embeddedci-com/benchpod/spice/adc-v2/adc-v2.asc

C72: Cap; 100p
C74: Cap; 10p
C139: Cap; 10p
C140: Cap; {Cc}
R90: Res; 910k
R91: Res; 82.5k
R92: Res; 1k
R93: Res; 1k
R94: Res; 1.5k
R97: Res; 22
R98: Res; 22
R102: Res; 1.5k
R103: Res; 10
VOCM: voltage; 2.05
VP: voltage; 5
Vsig: voltage; PULSE(0 30 1u 0.1n 0.1n 5u 10u); AC 1 0
Named nets: 0, SMA, TOP, ATTN, INM, INP, OUTP, OUTM, AINP, AINN, VP, VOCM, BUF
.include ths4551.lib
XU1 INP INM OUTP OUTM VOCM VP 0 THS4551
.tran 0 12u 0 1n
Vneg VN 0 -5
;EBUF BUF 0 ATTN 0 1
.include opa810.lib
XBUF ATTN BUF BUF VP VN OPA810
.options reltol=1e-5
* per-input charge buckets (datasheet 22R + 1.7nF per input)
CbP AINP 0 680p
CbN AINN 0 680p
* SAR sample-and-hold: 31pF cap switched onto the inputs during tACQ
S1 AINP SP CLK 0 SW1
S2 AINN SN CLK 0 SW1
Csmp SP SN 31p
S3 SP SN NCLK 0 SW1
VCLK  CLK  0 PULSE(0 1 1.5u 1n 1n 300n 1000n)
VNCLK NCLK 0 PULSE(1 0 1.5u 1n 1n 300n 1000n)
.model SW1 SW(Ron=100 Roff=1e9 Vt=0.5)
.meas TRAN Vend   FIND V(AINP)-V(AINN) AT 4.8u
.meas TRAN Vfinal FIND V(AINP)-V(AINN) AT 5.45u
.meas TRAN err    param Vend-Vfinal
.param Cc=9.3p
.step param Cc 9.0p 9.6p 0.025p
