embeddedci-com/benchpod/(commit log)

2026-09-04 switched D1, added rules area with keepout
    [analog-power-v2.kicad_sch, usb.kicad_sch, vbench-pod.kicad_pcb]
2026-09-05 1V8/3V3 pull-ups / pull-down fixes
    [LogicAnalyzer.kicad_sch, vbench-pod.kicad_pcb, vbench-pod.kicad_sch]
2026-09-05 ethernet rx/tx reroute
    [vbench-pod.kicad_pcb]
2026-09-05 txp/txn/rxp/rxn rerouting
    [vbench-pod.kicad_pcb]
2026-09-05 nrst control
    [vbench-pod.kicad_pcb, vbench-pod.kicad_sch]
2026-09-06 expanding board, adding headers, adding usb-a
    [analog-to-digital-v2.kicad_sch, digital-to-analog-v2.kicad_sch, power.kicad_sch, vbench-pod.kicad_pcb]
2026-09-06 replacement for crystals, revision resistors, cleanups
    [ethernet.kicad_sch, vbench-pod.kicad_pcb, vbench-pod.kicad_sch]
2026-09-06 tvs fixes, extra cap, schematic fixes
    [analog-power-v2.kicad_sch, digital-to-analog-v2.kicad_sch, vbench-pod.kicad_pcb]
2026-09-07 headers for dac/adcs with zero resistors, 4.5V input for DAC instead of 5V
    [analog-power-v2.kicad_sch, analog-to-digital-v2.kicad_sch, digital-to-analog-v2.kicad_sch, vbench-pod.kicad_pcb]
2026-09-07 fix pull-downs for board boot-up
    [analog-switching.kicad_sch, power.kicad_sch]
2026-09-07 copper cleanups
    [vbench-pod.kicad_pcb]
2026-09-07 cleanups and copper fill
    [vbench-pod.kicad_pcb]
2026-09-08 route cleanups and out of stock component replacement
    [analog-power-v2.kicad_sch, power.kicad_sch, usb.kicad_sch, vbench-pod.kicad_pcb, vbench-pod.kicad_sch]
2026-09-08 replace d1, cleanups, cap changes
    [analog-power-v2.kicad_sch, ethernet.kicad_sch, power.kicad_sch, vbench-pod.kicad_pcb, vbench-pod.kicad_sch]
2026-09-08 5VA->5V for relays, resistor and cap changes
    [analog-power-v2.kicad_sch, analog-switching.kicad_sch, analog-to-digital-v2.kicad_sch, digital-to-analog-v2.kicad_sch, vbench-pod.kicad_pcb, vbench-pod.kicad_sch]
2026-09-08 5VA->5V for relays rerouting
    [analog-to-digital-v2.kicad_sch, vbench-pod.kicad_pcb, vbench-pod.kicad_sch]
2026-09-08 drc and cleanups
    [vbench-pod.kicad_pcb]
2026-09-09 CAN improvements, rerouting, final drc cleanup of routes
    [vbench-pod.kicad_pcb, vbench-pod.kicad_sch]
2026-09-09 fb changes, cc sensing, cleanups
    [analog-power-v2.kicad_sch, ethernet.kicad_sch, usb.kicad_sch, vbench-pod.kicad_pcb, vbench-pod.kicad_sch]
2026-09-09 final cleanup
    [analog-power-v2.kicad_sch]
2026-09-09 change resistor value
    [analog-power-v2.kicad_sch]
2026-09-25 benchpod digital only
    [LogicAnalyzer.kicad_sch, analog-power-v2.kicad_sch, analog-switching.kicad_sch, analog-to-digital-v2.kicad_sch, digital-to-analog-v2.kicad_sch, ethernet.kicad_sch, power.kicad_sch, usb.kicad_sch]
2026-10-02 digital layout fixes
    [vbench-pod.kicad_pcb]
2026-10-03 layout fixes and cleanups
    [vbench-pod.kicad_pcb, vbench-pod.kicad_sch]
2026-10-03 more fixes
    [vbench-pod.kicad_pcb]
2026-10-03 digital benchpod: final layout
    [vbench-pod.kicad_pcb, vbench-pod.kicad_sch]
2026-10-04 cleanups: before schematic sync
    [vbench-pod.kicad_pcb]
2026-10-04 digital and analog cleanup
    [ethernet.kicad_sch, power.kicad_sch, usb.kicad_sch, vbench-pod.kicad_pcb, vbench-pod.kicad_sch]
2026-10-06 Benchpod v3.0.1 work (#1)
    * bom replacements and footprint replacements for out of stock items
    * replacements and fixes
    * smaller fixes
    * finalized v3r1
    * finshunt work on digital (wip)
    [analog-power-v2.kicad_sch, analog-to-digital-v2.kicad_sch, power.kicad_sch, usb.kicad_sch, vbench-pod.kicad_pcb, vbench-pod.kicad_sch]
2026-10-06 bring digital on par with analog for current shunt
    [vbench-pod.kicad_pcb]
2026-10-06 small cleanups
    [vbench-pod.kicad_pcb]
2026-10-06 README: which board matches which tag
    Board names as printed on the silkscreen, the tag with their design files,
    and what changed per board. The v3 tags are renamed after the boards:
    analog-v3, digital-v3, analog-v3r1, digital-v3r2.
2026-10-06 digital: U35 value INA226AIDGSR like U29/U33
    With two different values the JLC BOM had two lines for the same part
    (C49851) and left both unconfirmed at quantity 0, so no INA226 would have
    been placed. One value gives one line, U29/U33/U35.
    [usb.kicad_sch]
2026-10-20 analog v3r2: lead-free diodes and SMA, 0.1 % gain resistors, tantalum ADC reference cap
    RoHS/REACH (no exemption claimed in the LCSC test reports):
    - SS34 D3 D9 D15 D16 -> FOSAN SS34 C3014011
    - SMAJ20A D5 -> FOSAN SMAJ20A C5353170
    - SMAJ36CA D6 D7 D8 D10 -> FOSAN SMAJ36CA C5353135
    - SMA RF1-RF4 -> HCTL HC-SMA-KWE-14.5H-D002-01 C41410437 (same footprint,
    5.08 vs 5.10 mm pin square)
    - 11.8k R127 R129 R132 R133 (RALEC, lead glass) -> YAGEO 0.1 % C852496
    0.1 % 25 ppm thin film, to cut the pod-to-pod offset and gain spread:
    - THS4551 gain R92 R93 (1k C852624), R94 R102 (1.5k C281775): the 1 %
    mismatch turned VOCM into an ADC offset of about +-66 mV between pods
    - +-12 V difference amps R126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
2026-10-20 analog v3r2: smaller capacitor packages (same rating and dielectric)
    To 0402: 3.3 nF C99 C102 C119 C226 (C26404), 8.2 pF C0G C29 C30 C50 C51
    (C1579), 5.1 pF high-Q C207 C208 (C237535; the old C2297586 had 29 in stock).
    To 0603: 4.7 uF C2 C3 C5 C220 (C69335), 22 uF C16 C108 C154 C157 (C2762594),
    220 nF C189 (C64705), 2.2 uF X7R VCAP C218 C219 (C415535, from 1206).
    Kept: C150/C153 (4.7 uF on the ~5 V charge-pump rails, DC-bias derating),
    C140 (sees up to 58 V at TVS clamp), all 10 uF and the 22 uF on >5 V rails.
    Footprint changes: needs a PCB update. Netlist connectivity unchanged.
2026-10-20 analog v3r2: no extra BOM lines from the 0.1 % swaps and cap shrinks
    JLC standard assembly charges per unique BOM line, so only keep changes
    that replace a whole line:
    - Revert 4.7 uF C2 C3 C5 C220 and 22 uF C16 C108 C154 C157 to 0805 (the
    other 4.7 uF/22 uF stay 0805, so the shrink split a line), and 5.1 pF C207
    C208 to the 0603 C2297586 (C140 needs it; 29 in stock = 9 boards).
    - Move the remaining 1k (R21 R22 R164 R175), 1.5k (R15) and 2.2k (R58 R62)
    to the same 0.1 % parts as the precision ones, so their old lines go.
    BOM: 122 -> 124 unique lines (0.1 % 10k for R109 R110 R111 R123, tantalum
    C142). Netlist connectivity unchanged.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
2026-10-20 libs: import DAC8554IPWR (C527522) from LCSC/EasyEDA
    easyeda2kicad import, named like the kicad_lcsc_manager parts:
    symbol DAC8554IPWR_C527522, footprint C527522_TSSOP-16_..., 3D model
    3dmodels/C527522. Pin 5 keeps EasyEDA's name VREEL (VREFL).
2026-10-20 analog v3r2: quad DAC (DAC8554) with one channel per output, TMUXes removed
    Step A of the analog redesign, relays unchanged:
    - U43 DAC8551 -> DAC8554IPWR (C527522, same 24-bit frame family):
    A = TO_3V3, B = TO_5V, C = TO_12V (U51B and the cal2 stage U51C),
    D = DAC_OUTPUT -> U44B -> BUFFER_OUT -> XTR116, so 4-20 mA is now
    independent of the voltage outputs. VREFH = AREF_4V096, VREFL/A0/A1/
    ENABLE/LDAC = GND, IOVDD = +3V3 with new C266 100n (C307331).
    - Removed U47 U48 (TMUX1104), U55 (TCA9554 @0x21) with R107 R112 R124,
    C164 C199 C200 C203 C204 C234, and the SDA/SCL sheet pins of this sheet.
    - BUFFER_VMID (2.048 V) now goes straight to both +-12 V stages
    (was TO_12V_VMID / TO_ADC_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
2026-10-20 analog v3r2: board-rev strap R164 1k -> 2.2k (PA3 2.70 V)
    v3 straps PA3 with 1k/10k (3.00 V); v3r2 uses 2.2k/10k (2.70 V) so new
    firmware can tell them apart. Still reads HIGH in the pull-down NC test
    (~2.59 V loaded), so v2 detection is unchanged, and old firmware runs a
    v3r2 board as v3. R164 uses the existing 0.1 % 2.2k line (C326602): no new
    BOM line. Note next to the strap documents both values.
2026-10-20 header cleanup and schematic cleanup
2026-10-20 analog v3r2: +-14 V (TPS65131) enabled from U58 P4, off by default
    U49 ENP/ENN were pulled up to VIN, so +-14 V was always on. They now share
    the new ANA14_EN net from the relay expander U58 P4 (TCA9554 0x23, spare
    pin), with R114 (100k) as pull-down to GND; R117 removed. TPS65131 EN:
    VIH 1.4 V, 0.1 uA, so the 3.3 V expander output and 100k pull-down work.
    Why: the DAC8554 powers up at code 0, which put the +-12 V output (RF3) at
    about -12 V until firmware parked channel C. With +-14 V off at power-up,
    -14 V is 0 V and +14 V sits at ~VIN - Vf (no BSW load switch), so U51
    cannot swing negative and RF3 stays near 0 V. Old firmware never enables
    it, so on v3r2 the +-12 V output is simply off.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
2026-10-20 analog v3r2: remove H3 (unused 2x5 GPIO header), freed STM32 pins no-connect
    PD8-PD15, PG2, PG5 (HEADER1_1..10) get no-connect flags, like the pins
    freed by the H2 removal. BOM lines unchanged (H1 still uses the same
    header part until it becomes a TC2030 footprint).
2026-10-20 analog v3r2: SWD on a TC2030 footprint with SWO, USART2 console on test pads
    - H1 (2x5 1.27 mm SWD header, DNP) -> J10 Tag-Connect TC2030-IDC footprint
    (Connector:Tag-Connect_TC2030-IDC-FP_2x03_P1.27mm_Vertical, legged):
    VCC=+3V3, SWDIO, NRST, SWCLK, GND, and pin 6 SWO = PB3 (was unused).
    TC2030-IDC plugs into a 10-pin Cortex debug header.
    - USART2 (PD5 TX, PD6 RX), the firmware's mirrored console, on test pads
    TP8 (TX), TP9 (RX) and TP10 (GND), 1.5 mm pads, in place of H2's pins.
    - J10 and the pads are footprints only (in_bom no, like TP3/TP7).
    ERC: one extra pin_not_driven on J10 SWO (STM32 pins have no pin type).
    BOM lines unchanged (123).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
2026-10-20 analog v3r2: EMC pre-scan fixes in the schematic, no new BOM lines
    From compliance emc/prescan-2026-10-18.md (schematic part; layout is separate):
    - C267 100 nF (C307331) at U37 (THS4551) pin 5 VS-; C224/C157 sit at the
    LM7705 on the power sheet, not at the driver.
    - USB-C CC1/CC2 clamped by the two unused channels of D11 (USBLC6-4, pins
    6 and 4), which already protects D+/D-.
    - LA header +1V8 (J1.18) and LA_VCCIO (J1.21) on the two unused channels of
    U28 (SRV05-4, pins 4 and 6); +3V3 (J1.17) is U28's own VDD rail, so it is
    clamped by U28 already. Layout: U28 next to J1.
    - RF2 (0-5 V SMA) gets D21 SMF13CA (C1851355, same as D19/D20): the jack had
    no clamp of its own and floats behi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
2026-10-20 pcb placement of v3r2 changes
2026-10-21 analog v3r2: fixed ADC divider compensation, trimmer C160 removed
    Measured on baea06 (v3r1) with a cal1 loopback sine sweep (200 Hz-150 kHz):
    the top leg was ~11.4 pF (C140 5.1 pF + C160 near its 6 pF max + stray)
    against ~107 pF on the bottom, so HF gain was +16 % over DC. Flat needs
    ~9.7 pF total.
    - C160 (2-6 pF trimmer, never adjusted) removed.
    - C140 5.1 pF -> 9.1 pF C0G +-0.1 pF 250 V, Murata GQM1875C2E9R1BB12D
    (C2299929), same 0603 footprint. With ~0.3 pF stray: ~3 % low at HF.
    - C72 100 pF +-5 % -> +-1 % C0G, YAGEO CC0402FRNPO9BN101 (C327198), same
    0402 footprint; C72 was the only user of C1546.
    C140 also leaves the 5.1 pF line (29 in stock), now only C207/C208.
    Netlist: only C1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
2026-10-21 pcb: 16 vias 0.45/0.2 -> 0.6/0.3 (board standard), no moves
    Only size and drill changed; positions, nets and tracks untouched. Fixes 16
    annular_width errors (0.125 mm ring vs the 0.15 mm rule). The bigger vias
    now hit clearance near the ESP32 signals around (107-117, 25-31); left for
    manual fixing. Refill zones before judging the via-to-zone clearance items.
2026-10-21 cleanups and sync pcb to schematic
2026-10-21 silkscreen fixes
2026-10-21 resistor change - enable 14V not at power up
2026-10-21 README: BenchPod v3-r2 board and tag
2026-10-21 bom fixes
2026-10-21 digital v3r3: carry over the analog v3r2 schematic changes
    Same refs and nets as analog v3r1 in these areas, so the v3r2 fixes map 1:1.
    - RoHS: D3 SS34 C8678 -> C3014011, D5 SMAJ20A C41376408 -> C5353170.
    - U4 ESP32-C3-MINI-1-H4 (C2934569): the N4 is out of stock at JLC; same
    module, footprint and chip, 105 C rated.
    - Package shrinks (whole BOM lines, no new lines): 8.2p C29/C30/C50/C51 and
    3.3n C99/C102/C119/C226 0603 -> 0402, 2.2u C218/C219 1206 -> 0603.
    - EMC: D11 spare channels on USB CC1/CC2, U34 spares on +1V8 and LA_VCCIO.
    - Debug: H1 (SWD 2x5) and H3 (HEADER1) removed; J10 SWO/NRST/SWCLK/SWDIO and
    J11 USART2_RX/+3V3/GND/USART2_TX 2x2, both DNP; PB3 = SWO, PD5/PD6 = USART2.
    No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
2026-10-21 pcb sync
2026-10-21 digital v3r3: right-angle, panel-facing parts for the enclosure
    Parts from benchpod-private enclosure/design.md (connector choices):
    - J1 LA header: shrouded keyed right-angle 2x13 X9555WR-2x13-6TV01
    (C2682221). Pins 1-22 unchanged (same odd/even IDC numbering), 23-26 GND.
    - J4/J5/J6 (target in, target out, 5 V out): pluggable right-angle 3.81 mm
    block, black, DB2ERC-3.81-2P-BK (C5259145); the plug ships separately.
    - SW1/SW2 reset/boot: side-push TS24CA (C393942), for pinholes in the panel;
    its two mechanical tabs have no pad number.
    - LED1: side-view RGB P4-1204RGBWS2-1.5T-A (C2827295). Pin numbers follow
    its datasheet (1 G, 2 B, 3 R, 4 anode); the colors stay on the same
    iCE40 d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
2026-10-21 digital v3r3: C120 back to its v3r2 orientation (pad 1 = +3V3) so the existing traces fit
2026-10-21 digital v3r3: CN1 becomes a 24-pin 1.0 mm FFC link to the analog module
    CN1 (2x10 IDC) is replaced by a 24-pin 1.0 mm FFC, KH-FPC1.0-H2.0SMT-24P-QCHF
    (C5123103, flip lock, top and bottom contact), on a new "Module link" sheet:
    1-3 +5V_MOD, 4-6 GND, 7 DAC_SCLK, 8 DAC_DIN, 9 DAC_SYNC, 10 GND,
    11 ADC_SCLK, 12 ADC_SDO, 13 ADC_SDI, 14 GND, 15 ADC_CNVST, 16 GND,
    17 I2C0_SDA, 18 I2C0_SCL, 19 GND, 20 MOD_RESET#, 21 MOD_PRESENT#, 22 GND,
    23 MOD_SPARE, 24 GND (tabs to GND). Every clock sits next to a ground.
    - Module 5 V through eFuse U59, a copy of U26 (TPS259470A, same BOM line):
    about 1 A limit (1.65k), soft start, OVLO divider, PG and FLT pull-ups.
    EN has a 10k pull-up, so the module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
2026-10-21 digital v3r3: always-on USB-A (USB2) to power the optional Wi-Fi bridge
    USB1 stays the target-power USB-A (it follows eFuse 1 and power-cycles with
    the DUT). USB2 is a second USB-A, same part, for the back panel next to the
    RJ45: always-on 5 V for the Wi-Fi bridge (power only, data goes over RJ45),
    as decided in benchpod-private enclosure/wifi-bridge.md (USB-A rather than a
    second USB-C, so nobody plugs the laptop into the wrong port).
    - eFuse U60, a copy of U26/U59 (TPS259470A): about 1 A limit, soft start,
    OVLO; EN pulled up, so it is on at power-up and older firmware keeps it on.
    - STM32 PD14 BRIDGE_PWR_EN (low = off, to power-cycle a hung bridge),
    PD15 BRIDGE_PWR_FLT#, PG2 BRIDGE_PW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
2026-10-21 connector placement
2026-10-21 connector placement continued
2026-10-21 pcb work
2026-10-22 digital v3r3: own I2C bus for the module; module sheet uses hierarchical labels
    - CN1 pins 17/18 move from the pod's internal I2C0 bus to a separate bus for
    the analog module: MOD_I2C_SDA = PF0, MOD_I2C_SCL = PF1 (STM32 I2C2, AF4),
    4.7k pull-ups R193/R194 to +3V3 (existing 4.7k line). A fault on the module
    or its cable can no longer hang the INA226 and TCA9554 bus.
    - The "Module link, bridge power" sheet now connects through hierarchical
    labels and sheet pins instead of global labels: the sheet box on the root
    sheet moved to the free space at the top (152.4, 25.4), 50.8 x 25.4, with
    the 9 FPGA/I2C lines on the left and the 9 STM32 control lines on the right.
    - Removes the old I2C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
2026-10-22 more pcb work
2026-10-22 digital v3r3: SY6280AAC power switches for module and bridge, TVS on 5 V outputs
    - U59 (module 5 V) and U60 (bridge USB-A 5 V) become SY6280AAC (C55136,
    about $0.09) instead of TPS259470 eFuses (about $1 each); 12 support parts
    removed. Current limit 6800/Rset: module 4.7k = about 1.45 A, bridge
    4.7k + 2.2k (R187 + R195) = 6.9k = about 1 A, both from existing BOM lines.
    EN keeps its 10k pull-up (on at power-up), PD10 / PD14 still switch them.
    - The FLT/PG flags are gone with the eFuses: PD11, PD12, PD15 and PG2 are free
    again (no-connect), and their four sheet pins are removed.
    - SMAJ5.0A TVS (same line as D1): D22 on the bridge USB-A VBUS, D23 on target
    power 1 (USB1/J5).
    BOM: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
2026-10-22 digital v3r3: merge three single-use resistor lines into existing ones
    - CAN series resistors R18/R176: 56 ohm -> 49.9 ohm (C325388).
    - RJ45 LED resistors R140/R141: 270 ohm 0603 -> 330 ohm 0402 (C25104); the
    LEDs get slightly dimmer.
    - VDDA/VREF+ filter R1: 47 ohm 0603 -> 49.9 ohm 0402 (C325388).
    Three BOM lines fewer. The MDIO pull-up R15 stays 1.5k (LAN8742A reference
    value). R140, R141 and R1 change footprint: re-place them after Update PCB.
2026-10-22 digital v3r3: CAN termination resistors R18/R176 back to 56 ohm
    They are not series resistors: with U24 (switch) they form the switchable
    CAN termination across CANH/CANL (2 x 56 + switch = about 115-117 ohm,
    close to 120 nominal). 49.9 ohm would give about 103-105 ohm.
2026-10-23 digital v3r3: PSRAM U7 in SOP-8 (APS6404L-3SQR-SN)
    - U7 becomes APS6404L-3SQR-SN (C5333729, SOP-8): same die, commands and pin
    numbering as the USON-8 APS6404L-3SQR-ZR (C3040877). $3.99 instead of $4.98
    at qty 1 ($2.88 vs $3.40 at 100), and 3.7k in stock at JLC instead of 664.
    - The SOP-8 has no exposed pad: pin 9 and its GND wire and symbol are removed.
    GND stays on pin 4. No firmware or gateware change.
    BOM: same number of lines. Layout needs about 5 x 6 mm instead of 2 x 3 mm.
2026-10-23 digital v3r3: 3.3 V buck U30 becomes TPS62130A plus a 2.2 uH inductor
    The TPS82130 module is a TPS62130 with a 1 uH inductor inside. Discrete, per
    the TPS62130 datasheet typical application (figure 9-1, table 9-1):
    - U30 TPS62130ARGTR (C337502, $0.80, KiCad VQFN-16 footprint with thermal
    vias); L1 2.2 uH 4x4 shielded FNR4030S2R2MT (C167869, 3.2 A, 5.8 A sat,
    39 mohm). 2.2 uH + 22 uF is the datasheet's standard LC combination.
    - PVIN/AVIN and EN on +5V; VOS on +3V3; FB divider R85 316k / R86 100k
    unchanged (FB is 0.8 V on both, 3.33 V out); SS/TR C119 3.3 nF unchanged;
    DEF and FSW on GND (nominal output, 2.5 MHz); PG unconnected, so the A
    version's PG behavior does not matter.
    - Ex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
2026-10-23 analog only board
2026-10-23 analog only board: CN1 FFC module link to the digital board
    - CN1 KH-FPC1.0-H2.0SMT-24P-QCHF (C5123103), the same 24-pin 1.0 mm FFC
    connector as the digital board, on the root sheet. Pins 21-24 +5V,
    DAC_DIN/SCLK/SYNC, ADC_SDI/SCLK/SDO/CNVST and I2C0 to the existing labels;
    MOD_PRESENT# tied to GND; MOD_RESET# and MOD_SPARE unused; tabs to GND.
    - Placed on the bottom side, under the digital CN1 (same X/Y from the
    top-left board corner), opening toward the left edge. Mounted upside down
    it is mirrored, so the pin order is reversed: pin N here = digital CN1
    pin 25-N (a flat cable keeps each wire at the same position). Text note on
    the sheet.
    - PCB: only the footprint was added; it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
2026-10-23 analog only board: +3V3 from an AP2112K-3.3 instead of the 3 A buck
    On this board +3V3 only feeds logic I/O (DAC8554 IOVDD, MCP33131 DVIO,
    TCA9554, the new EEPROM): a few mA. U30 TPS82130 (3 A module) becomes
    AP2112K-3.3 (C51118, same part as U46, so no new BOM line): VIN and EN on
    +5V, VOUT to +3V3, C107/C109 in, C110/C114 out. R85, R86, C119 and C108
    removed. Separate from U46's +3V3A so logic I/O stays off the analog rail.
    BOM: TPS82130, 316k and 3.3n lines gone (-3), about $4.75 per board.
2026-10-23 analog only board: sheet-pin cleanup, PWR_FLAGs, module ID EEPROM
    - Power sheet: the INA_SCL/SDA, SCL/SDA and EFUSE_INT sheet pins and their
    root labels removed (left over from the full pod, no labels inside).
    - PWR_FLAG on +5V at CN1 (it now comes in over the FFC) and on GND.
    - U61 24C32 I2C EEPROM (XBLW 24C32BN, C18723546, SOP-8) on I2C0, the module
    bus: A0-A2 and WP to GND (address 0x50, writable), C268 100n. Holds the
    module ID and its DAC/ADC calibration so they travel with the module.
    Pull-ups are on the digital board (R193/R194).
    BOM: +1 line (EEPROM). ERC 291 -> 276 (6 cleanup errors gone).
2026-10-23 analog only board: CN1 on the top side, straight pin order
    The board now has a cut at the left edge for the FFC, so CN1 moves to the
    top side with the same orientation as the digital CN1 (opening toward the
    cut). The cable U-turns through the cut, so pin N = digital CN1 pin N again
    (the reversed mapping is gone): pins 1-4 +5V, MOD_PRESENT# (21) to GND,
    MOD_RESET# (20) and MOD_SPARE (23) unused. Note on the sheet updated.
    PCB: CN1 on F.Cu, rotated -90, pin 1 at the digital pin-1 height (y 48.57
    from the top edge), 2 mm further inboard (x 19.51) so the opening is about
    3.3 mm from the cut's inner edge and the cable has room to bend.
    Includes the board-edge cut drawn in KiCad.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
2026-10-23 analog only board: enclosure connectors (BNC, pluggable 4-20 mA blocks)
    Per benchpod-private enclosure/design.md:
    - RF2 (0-5 V), RF3 (+-12 V), RF4 (ADC in): SMA -> right-angle BNC
    KH-BNC50-3511 (C2837587). Center on the same net, shell + lugs to GND.
    - RF1 (0-3.3 V jack) removed; the 0-3.3 V output stays on TP1.
    - 2-pin test headers U11-U14 and their 0 ohm links R20, R165-R167 removed;
    test pads TP1-TP4 (1.5 mm, not in the BOM) on the four outputs instead.
    - J8 (4-20 mA in) and J9 (4-20 mA out): 5.08 mm screw terminals ->
    3.81 mm right-angle pluggable WJ15EDGRC-3.81-02P (C8387, green); the
    mating plug C8466 is bought separately.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
2026-10-23 analog only board: ADC input ready for 10x probes, lead-free BNC
    - J10 (was RF4): ADC input BNC is now the lead-free SAMZO BNC-KYWE-295-W4-N
    (C41416668), as decided in benchpod-compliance v4-parts.md; the Kinghelm
    KH-BNC50-3511 relies on a RoHS lead exemption and is removed (symbol,
    footprint, model).
    - D8 and D7 (SMAJ36CA on RELAY1_IN / RELAY2_IN) removed: a few hundred pF and
    uA leakage on the 1 Mohm node made 10x probes impossible to compensate.
    - D22 BAV199LT1G (C145516, pA leakage, ~2 pF) clamps the OPA810 input
    (R90/R91 node) to 5VA / -5VA. R90 limits the fault current (0.33 mA at
    300 V) and moves to a 1206 0.1 % 200 V part (YAGEO RT1206BRD07910KL,
    C870935), value unchang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
2026-10-23 analog only board: DAC outputs on one 6-pin pluggable block
    RF2 (0-5 V) and RF3 (+-12 V) BNCs removed. All three DAC outputs go to
    J11, a 3.81 mm right-angle pluggable block WJ15EDGRC-3.81-06P (C7246,
    green): 1 0-3.3 V (OUT_3V3), 2 GND, 3 0-5 V (TO_5V_SMA), 4 GND,
    5 +-12 V (OUT_12V), 6 GND. The 0-3.3 V output is on the panel again.
    TP1-TP3 stay as internal test pads. Panel: 1 BNC (ADC in), the 6-pin DAC
    block, and the two 2-pin 4-20 mA blocks.
2026-10-24 digital v3r3: front/back connectors overhang 2.2 mm, even spacing
    Parts moved only; tracks to these parts are not rerouted yet.
    - Overhang: J1, J5, J6, USB1 2.2 mm past the front edge; USB2, J4, J7
    2.2 mm past the back edge; USBC1 1.5 mm (its pads allow no more). The
    faces sit 0.2 mm behind the panel's inside face (Hammond 1455N, 118 mm
    board). LED1, SW1, SW2 stay (light pipe / pinholes).
    - Front row: J1 centred on the board (x 106.30), 4.0 mm between all
    courtyards (J6, J5, J1, LED1, USB1), like the 4 mm between the analog
    4-20 mA blocks.
    - Back: J4 centred between USB2 and USBC1 (7.65 mm each side).
    - C64/C65 (4.7u pair between J6 and J5) moved 1.6 mm back to clear the
    connecto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
2026-10-24 analog only board: square outline, front connectors overhang, J8/J9 turned
    Parts moved only; tracks are not rerouted.
    - Outline: one polygon, exactly 98.5 x 118 (x 39.0-137.5, y 20.18-138.18),
    with the FFC cut (x to 50.0, y 65.0-97.0) and a 2.2 mm tab under the BNC
    (x 46.41-61.41) so its pads stay on the board while it reaches the panel.
    - J10 (ADC BNC): flange front on the panel's inside face (2.4 mm past the
    edge), so the panel nut clamps it; y 26.36 -> 23.78.
    - J8 (4-20 IN), J9 (4-20 OUT): were at 0 deg, with the plug opening facing
    into the board; now 180 deg like J11, opening 2.2 mm past the edge.
    - J11 (DAC block): 2.2 mm overhang, x 114.37 -> 115.22 for the same
    7.89 mm gap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
2026-10-24 aligning board components
2026-10-24 analog only board: mounting holes at the digital board's positions
    H10, H11, H12, H14 at the same X/Y from the top-left board corner as on the
    digital board (x 5.99 / 92.33, y 20.81 / 92.49), so both boards line up
    in the case. H10, H11 and H14 sit in free space. H12 lands on U45
    (OPA2992), C168, C169 and R108: those need to move. H12 is still the
    unplated MountingHole_2.7mm_M2.5 here (plated Pad_Via on the digital
    board).
2026-10-24 analog only board: H12 plated and on GND like the other holes
    H12 becomes Mechanical:MountingHole_Pad with MountingHole_2.7mm_M2.5_Pad_Via
    and its own GND symbol, the same as H10, H11, H14 and all four holes on the
    digital board. PCB footprint swapped in place (same position, path, GND on
    the pads). Its pad now shorts with U45, C168, C169 and R108, which still
    need to move out of the hole's keepout.
2026-10-24 pcb alignment work
2026-10-24 digital v3r3: USB1 1.5 mm and LED1 0.75 mm toward the board center
    USB1's rear shell leg (2.2 mm below the board) reached 0.34 mm into the
    Hammond 1455N's bottom corner (found by the enclosure import). Moving USB1
    1.5 mm inward clears it; LED1 moves 0.75 mm so the front row stays even
    (J1-LED1 and LED1-USB1 both 3.25 mm, J1 still centred) and the aluminum
    between the USB and LED panel openings stays thicker than with the LED
    moved alone. Parts moved only: tracks around LED1 and USB1 need rerouting,
    and the +3V3 via at (135.1, 23.6) now sits too close to USB1's shell leg.
2026-10-24 fixes for enclosure
2026-10-24 digital v3r3: USB-C reaches through the panel, 2.2 mm tab under it
    For a tight USB-C panel opening (no overmold-sized hole) the receptacle face
    has to sit just behind the panel's outside surface (1.5 mm aluminum, inside
    face 2.4 mm past the board edge). Its front pads only allowed 1.5 mm of
    overhang on a straight edge.
    - Outline: the rectangle becomes one polygon with a 2.2 mm tab on the back
    edge under USBC1 (x 113.49-124.49, inside the bezel window), stopping
    0.2 mm short of the panel, like the analog board's BNC tab.
    - USBC1 y 129.52 -> 131.74: face 3.7 mm past the board edge, 0.2 mm behind
    the panel's outside surface (measured from the footprint's silkscreen
    front). Front pads 0.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
2026-10-24 pcb connector work
2026-10-24 digital: flush connector moves + two 2.2 mm front stop tabs
    Front -y: J1 1.95, J5/J6 1.82, USB1 1.5. Back +y: J4 1.79, J7 1.72, USB2 1.55.
    Stop tabs x 82.32-85.32 and 127.29-129.54, front edge to y 13.055.
    Tracks not moved: reroute J1, J7, USB1, USB2 (J4/J5/J6 pads still touch old ends).
2026-10-24 analog: black DORABO terminals, flush with the front panel
    J8/J9 -> DB2ERC-3.81-2P-BK (C5259145, same as digital J4-J6), J11 -> DB2ERC-3.81-6P-BK
    (C5244107, new footprint from EasyEDA + courtyard, no 3D model). Same pinout and pitch,
    body centre x kept, pad row y 25.53 -> 24.271 (face 3.8 mm past the edge). Stale
    C8465/WJ500V fields on J8/J9 corrected. Tracks to the old pads need rerouting.
2026-10-24 analog: J8/J9/J11 0.09 mm toward the front (face 0.1 mm behind panel outside, per enclosure fit check)
2026-10-24 digital: USB1/USB2 1.4 mm inward, flare against the inside of the panel
    C456018 has a flared lip (14.5 x 7.0) on its front 0.6 mm; seating it behind the panel
    lets the opening fit the shell body (13.5 x 6.1). Shell face ends 1.5 mm behind the panel
    outside. USB1 y 23.323 -> 24.723, USB2 125.126 -> 123.726.
2026-10-26 pcb work - all connected
2026-10-26 pcb work - pours
2026-10-27 digital v3r3: EMC changes from vendor references
    Ethernet (Microchip LAN8742A datasheet Fig. 3-23 + EVB8742, HanRun
    HR911105A note, TI DP83825 EVM):
    - R160 1M -> 0R 0402: J7 pin 8 (CHS GND) straight to GND; C58 DNP
    - J7 center taps on their own net ETH_CT, fed from VDDA by R196 0R;
    C49 100n now sits on ETH_CT (place it at J7 pins 4/5)
    - C273-C276 8.2p from TXP/TXN/RXP/RXN to GND (EVB8742 10 pF EMI option)
    Power terminals (TI TPS25947EVM):
    - 100n + 470p at J5 (C277/C278), J6 (C279/C280), J4 (C281/C282)
    - J4 pin 1 net named EXT_IN
    No new BOM lines. ERC unchanged (467 before and after).
2026-10-27 signal filtering / improvement
2026-10-27 digital v3r3: D4 Ethernet ESD -> TPD4E05U06DQAR (flow-through, no 3.3 V rail)
    As on TI's DP83825 EVM (U3): D1 = TX pair, D2 = RX pair, each line on
    both opposite pads (1/10, 2/9, 4/7, 5/6) so the pairs run straight
    through the part; GND on 3 and 8. USBLC6-4SC6 clamped to +3V3 and its
    SOT-23-6 pinout forced the pairs to cross; C47 (its +3V3 pin cap) removed.
    Part imported with easyeda2kicad (C138714), pins set to passive.
    ERC unchanged (467).
2026-10-27 analog module: use reserved JLC stock for C207/C208 and U42
    C207/C208 5.1 pF: C2297586 (11 left at JLC) -> C20617868 (FH 0603 C0G 50 V,
    100 reserved); op-amp feedback caps, 50 V is plenty. C140 9.1 pF 250 V stays.
    U42 LM7705MM/NOPB C129980 -> LM7705MMX/NOPB C2070761 (same chip and
    VSSOP-8 package, larger reel; 10 reserved). Schematic and board fields both.
2026-10-27 bom changes, cleanups
2026-10-27 README: v3r3 digital board and analog module in the board table
2026-10-28 analog module: ÷2 ADC low range (K5)
    A second input range for small signals: ±5.46 V (÷2, 167 uV/count)
    next to today's ±32.8 V (÷12), 6x the resolution on 0-5 V signals and on
    the J8 current input (both share the divider).
    - K5 (G6K-2F-Y DC5, same part as K3) driven by U53 OUT5 from U58 P5
    (R185 4.7k pull-down), LOW_RANGE_EN through the root sheet.
    - Pole 1 swaps the bottom leg: R91 82.5k + C72 to GND (NC1, off) or
    R182 910k 0.1 % 25 ppm + C269 47 pF to GND (NO1, on). R90 stays in
    series, so 30 V into the D22 clamp is still ~33 uA.
    - Pole 2 moves C271 (47 pF 100 V): to GND on the normal range (part of
    the bottom leg; C72 100 -> 51 pF keeps it at ~105 pF with strays), across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
2026-10-29 pcb work for second precision on adc
2026-10-29 analog: silkscreen v3-r4
2026-11-04 Add the BenchPod product datasheet
    Markdown source (datasheet/datasheet.md) built into a PDF through headless
    Chrome. Port, dimension and block-diagram figures are generated from the
    KiCad PCBs at the digital-v3r3 and analog-v3r4 tags. Ports use their
    product names; no board reference designators in the datasheet.
2026-11-04 datasheet: EXT SUPPLY IN is 2.7-20 V
    The DUT EXT eFuse has no undervoltage divider; only the chip's own
    2.5 V lockout applies, so 3.3 V DUT supplies pass and 1.8 V does not.
2026-11-04 datasheet: getting started, usage notes, firmware updates and support
    Copied from the public docs so the PDF is useful on its own: setup with
    the CLI, first wiring, a first pytest, the do's and don'ts per port, and
    how to update or recover the firmware. Fenced code blocks render now.
2026-11-04 datasheet: indoor use, 3 m cable limit
2026-11-04 datasheet: no adapter included, current draw from the previous revision, SHA-256 checked updates
    Firmware signature checks are not enforced yet, so the datasheet no longer
    calls the images signed. DUT 5V notes the computer's USB-C port limit.
2026-11-05 analog module: 100 pF at ADC VREF, DNP 1.8 nF C0G per ADC input
    C272 100 pF C0G at U36 VREF (pin 1), as on Microchip's ADM00873-R2.
    C273/C274 1.8 nF C0G from ADC_AIN+/- to GND, DNP until the THS4551
    is checked for stability with the extra load. Schematic only; the PCB
    still needs Update from Schematic and placement next to U36.
2026-11-05 analog module: drop C273/C274 ADC input caps
    Simulation (THS4551 model, as-built driver) shows they do not change
    stability and slow the recovery after the ADC's sampling kick, so they
    are left out. C272 (100 pF at VREF) stays.
2026-11-05 datasheet: separate Wi-Fi bridge datasheet
    wifi-bridge.md builds BenchPod-WiFi-bridge-datasheet.pdf (make bridge): radio,
    network, measured power and throughput, ports and buttons, setup, security,
    updates and recovery, usage notes, and a test-lab section with the bridge's
    clocks and the module's FCC and ISED numbers. build.py takes the source file
    and reads the PDF name from an output comment. The main datasheet's bridge
    section points to it. Not published to the Downloads page.
2026-11-06 1 uF caps: 25 V basic part (C52923) on 38 positions of 5.5 V or less
    Samsung CL05A105KA5NQNC (1 uF 25 V X5R 0402, JLC basic) replaces the Murata
    GRM155R61H105KE05D (C1518208, 50 V) where the rail stays at 5.5 V or less
    and the cap sits in parallel with at least 10x its capacitance, so DC-bias
    loss cannot matter:
    - digital (21): C17 C24 C26 C53 C57 C59 C67 C107 C110 C111 C115 C117 C217
    C235-C240 C265 C271
    - analog (17): C107 C127 C134 C147 C151 C155 C165 C168 C171 C209 C213 C230
    C232 C234 C247 C251 C252
    The other 29 keep the 50 V part (+-14 V, LDO output caps, references and
    filters, charge pumps, USB VBUS input). Schematic and PCB fields both
    updated; about $1.60 per pod. Decision log: b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
2026-11-06 1 uF caps: MPN matches the LCSC part (GRM155R61H105KE05D)
    The C1518208 positions listed MPN CL21B105KBFNNNE, an 0805 Samsung part,
    while C1518208 is Murata GRM155R61H105KE05D (0402). Only the MPN field
    changes; no other BOM line moves.
2026-11-06 Digital buck U30: TPS62130RGTR (C43590) instead of TPS62130ARGTR (C337502)
    C337502 is out of stock at JLC. The A and non-A versions differ only in
    the power-good pin, and U30's PG is not connected, so the circuit, the
    RGT footprint and the symbol stay. Value, description and LCSC change in
    the schematic and the PCB.
2026-11-06 Digital D5 (EXT SUPPLY IN TVS): SMAJ22CA (C5353129) instead of SMAJ20A
    Bidirectional, same SMA pads. Breakdown 24.4-28.0 V keeps it off on a
    24 V supply and below the eFuse's 28 V input maximum; bidirectional so a
    reversed supply is not shorted (TPS25947 handles -15 V on IN).
2026-11-06 Analog 4-20 mA IN: 25 mA limiter U62 (AL5809-25P1-7) + reverse diode D23 (SS34)
    A supply wired straight to 4-20 mA IN put up to 2.3 W into R81 (249 R,
    250 mW). U62 caps the current at 23.75-26.25 mA (R81 <= 0.17 W) and
    D23 blocks reverse polarity. D6 stays at the connector. Adds about 2 V
    to the loop burden. Schematic only: PCB not updated yet. Footprint
    (PowerDI-123) imported from EasyEDA, check against the datasheet land
    pattern before layout. R81 note corrected to 250 mW.
2026-11-07 Digital: CAN ESD clamp D25 (H24VNT2B) on J1 CAN+/CAN-
    Dual bidirectional 24 V TVS (C20615827, JLC preferred) from CAN+ and
    CAN- to GND, to be placed at J1 with a short ground. Schematic only,
    the PCB is not updated.
2026-11-07 Analog: ESD fixes for 4-20 mA OUT, 4-20 mA IN and the BNC input
    - J9 (4-20 mA OUT): D24/D25 SMAJ36CA clamp each loop terminal to GND,
    R186 47 ohm in series with XTR116 IO, D26 BAV21WS keeps V+ to IO
    from reversing, D9 SS34 -> SS220 (200 V).
    - 4-20 mA IN: D23 SS34 -> BAV21WS (250 V, 5 pF), D27 BAV21WS bypass
    across U62 (anode Out, cathode In).
    - ADC IN: D28 H36VLT2B (36 V, 18 pF max) from the BNC center to GND,
    to be placed at J10.
    New parts are JLC preferred (no loading fee). Schematic only, the PCB
    is not updated.
2026-11-08 CN1 ESD: SRV05-4A arrays at both CN1s, 100 ohm in the lines without a series resistor
    The stand cover over the FFC was dropped, so CN1 and the FFC are reachable in the
    open-board EMC test and on the stand. Simulated in benchpod-compliance
    emc/esd-port-simulation.md (CN1 section): every IC end then stays under its HBM
    rating at +-4 kV contact and at the 8 kV contact stress case.
    Digital (module-link sheet):
    - U61-U63 SRV05-4A (C20615829, JLC preferred) on the 12 CN1 signal lines,
    rail +3V3, GND; place at CN1 with a short ground via.
    - R197-R201 100R (0402, C25076) in series in MOD_I2C_SDA/SCL, MOD_RESET#,
    MOD_PRESENT# and MOD_SPARE; CN1 side is the new *_CN1 net. The ADC/DAC lines
    keep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
2026-11-09 Analog K1-K5: G6K-2F-Y-TR DC5 (C231390) instead of C231389
    Same Omron G6K-2F-Y 5 V DPDT relay on the same footprint, on tape and reel. JLC sells it for
    less ($0.80 vs $1.12 at 30+), and our own JLC stock will hold this part number, which JLC only
    uses when the BOM names it.
2026-11-10 Digital: DAC SPI series resistors R81/R82/R92 33 -> 100 ohm (C25076)
    The DAC clock (24 MHz) and data on the module cable drive the 288-336 MHz
    emission. ngspice of FPGA -> traces -> cable -> module DAC (with the CN1 ESD
    arrays and the module's 100 ohm resistors): about 9 dB less cable current at
    288-336 MHz, edges at the DAC 6.5 ns, setup/hold >= 15 ns, SCLK high/low at
    mid-level 20.5-20.8 ns. No shunt capacitor: 8.2 pF gave no extra reduction
    and doubled the edge time. Schematic only; the PCB is not updated yet.
2026-11-11 Analog R90: 910k 0.1% 0805 RT0805BRD07910KL (C865698) instead of the 1206
    C870935 (RT1206BRD07910KL) is out at JLC (5 left, 144 minimum pre-order).
    The 0805 is the same Yageo RT thin-film series (0.1%, 25 ppm), 2737 at JLC:
    150 V working, 300 V overload, still fine for the 300 V fault case of the
    ADC input (R90 limits the current, D22 clamps). Same center and rotation,
    short stubs from the old pad centers to the new pads, zones refilled; DRC
    unchanged (0 violations, 0 unconnected). Sheet note updated. Recheck the
    divider compensation (C140) on the first board, as the note already says.
2026-11-11 datasheet: Ethernet up to 30 m, indoors, to a switch or router in the same building
2026-11-12 datasheet: CAN FD (data phase up to 8 Mbit/s, 64-byte frames) (#2)
