embeddedci-com/benchpod/pcb/benchpod-analog/vbench-pod.kicad_pcb

## KiCad design pcb/benchpod-analog/vbench-pod.kicad_pcb (2026-11-11)

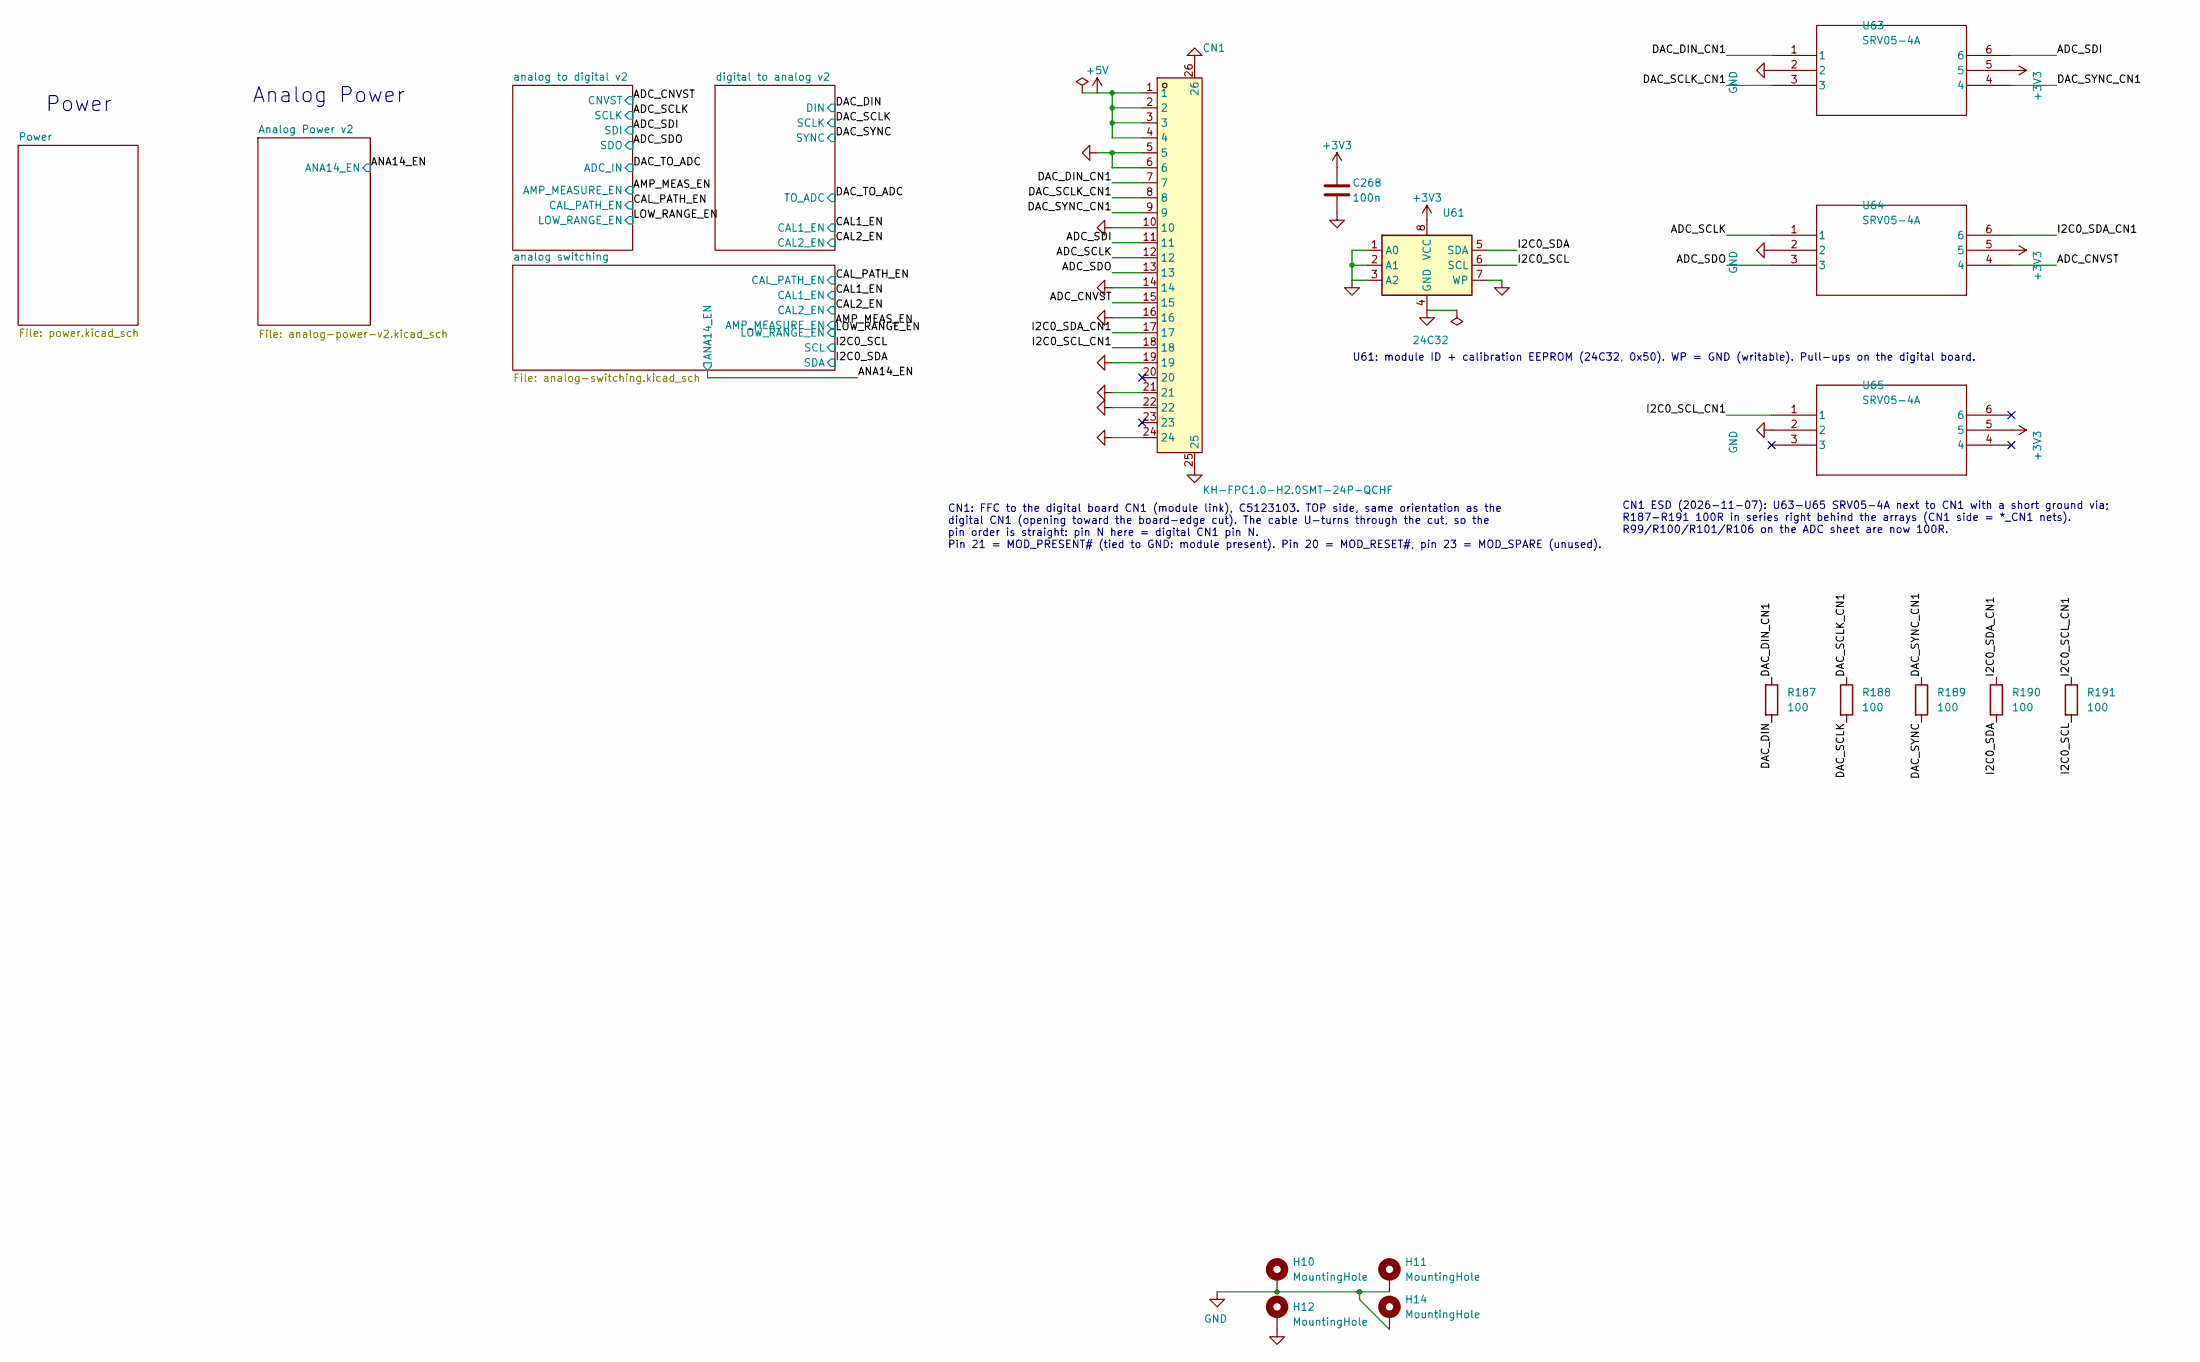
[picture p1: schematic vbench-pod.kicad_sch]

Parts:
C268: 100n; C_0402_1005Metric; LCSC C307331
CN1: KH-FPC1.0-H2.0SMT-24P-QCHF; C5123103_FPC-SMD_24P-P1.00_KH-FPC1.0-H2.0SMT-24P-QCHF; LCSC C5123103
H10, H11, H12, H14: MountingHole; MountingHole_2.7mm_M2.5_Pad_Via
R187, R188, R189, R190, R191: 100; R_0402_1005Metric; LCSC C25076
U61: 24C32; C18723546_SOP-8_L4.9-W3.9-P1.27-LS6.0-BL; LCSC C18723546
U63, U64, U65: SRV05-4A; SOT-23-6_L2.9-W1.6-P0.95-LS2.8-BR; LCSC C20615829

Connections:
+3V3: C268.1, U61.8 (VCC), U63.5, U64.5, U65.5; also elsewhere on the board
+5V: CN1.1, CN1.2, CN1.3, CN1.4; also elsewhere on the board
/ADC_CNVST: CN1.15, U64.4; also elsewhere on the board
/ADC_SCLK: CN1.12, U64.1; also elsewhere on the board
/ADC_SDI: CN1.11, U63.6; also elsewhere on the board
/ADC_SDO: CN1.13, U64.3; also elsewhere on the board
/DAC_DIN: CN1.7, R187.1, U63.1; also elsewhere on the board
/DAC_SCLK: CN1.8, R188.1, U63.3; also elsewhere on the board
/DAC_SYNC: CN1.9, R189.1, U63.4; also elsewhere on the board
/I2C0_SCL: CN1.18, R191.1, R191.2, U61.6 (SCL), U65.1; also elsewhere on the board
/I2C0_SDA: CN1.17, R190.1, R190.2, U61.5 (SDA), U64.6; also elsewhere on the board
GND: C268.2, CN1.5, CN1.6, CN1.10, CN1.14, CN1.16, CN1.19, CN1.21, CN1.22, CN1.24, CN1.25, CN1.26, H10.1 (1_1), H11.1 (1_1), H12.1 (1_1), H14.1 (1_1), U61.1 (A0), U61.2 (A1), U61.3 (A2), U61.4 (GND), U61.7 (WP), U63.2, U64.2, U65.2; also elsewhere on the board

Notes on the sheet:
Analog Power
CN1: FFC to the digital board CN1 (module link), C5123103. TOP side, same orientation as the digital CN1 (opening toward the board-edge cut). The cable U-turns through the cut, so the pin order is straight: pin N here = digital CN1 pin N. Pin 21 = MOD_PRESENT# (tied to GND: module present). Pin 20 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
U61: module ID + calibration EEPROM (24C32, 0x50). WP = GND (writable). Pull-ups on the digital board.
Power
CN1 ESD (2026-11-07): U63-U65 SRV05-4A next to CN1 with a short ground via; R187-R191 100R in series right behind the arrays (CN1 side = *_CN1 nets). R99/R100/R101/R106 on the ADC sheet are now 100R.

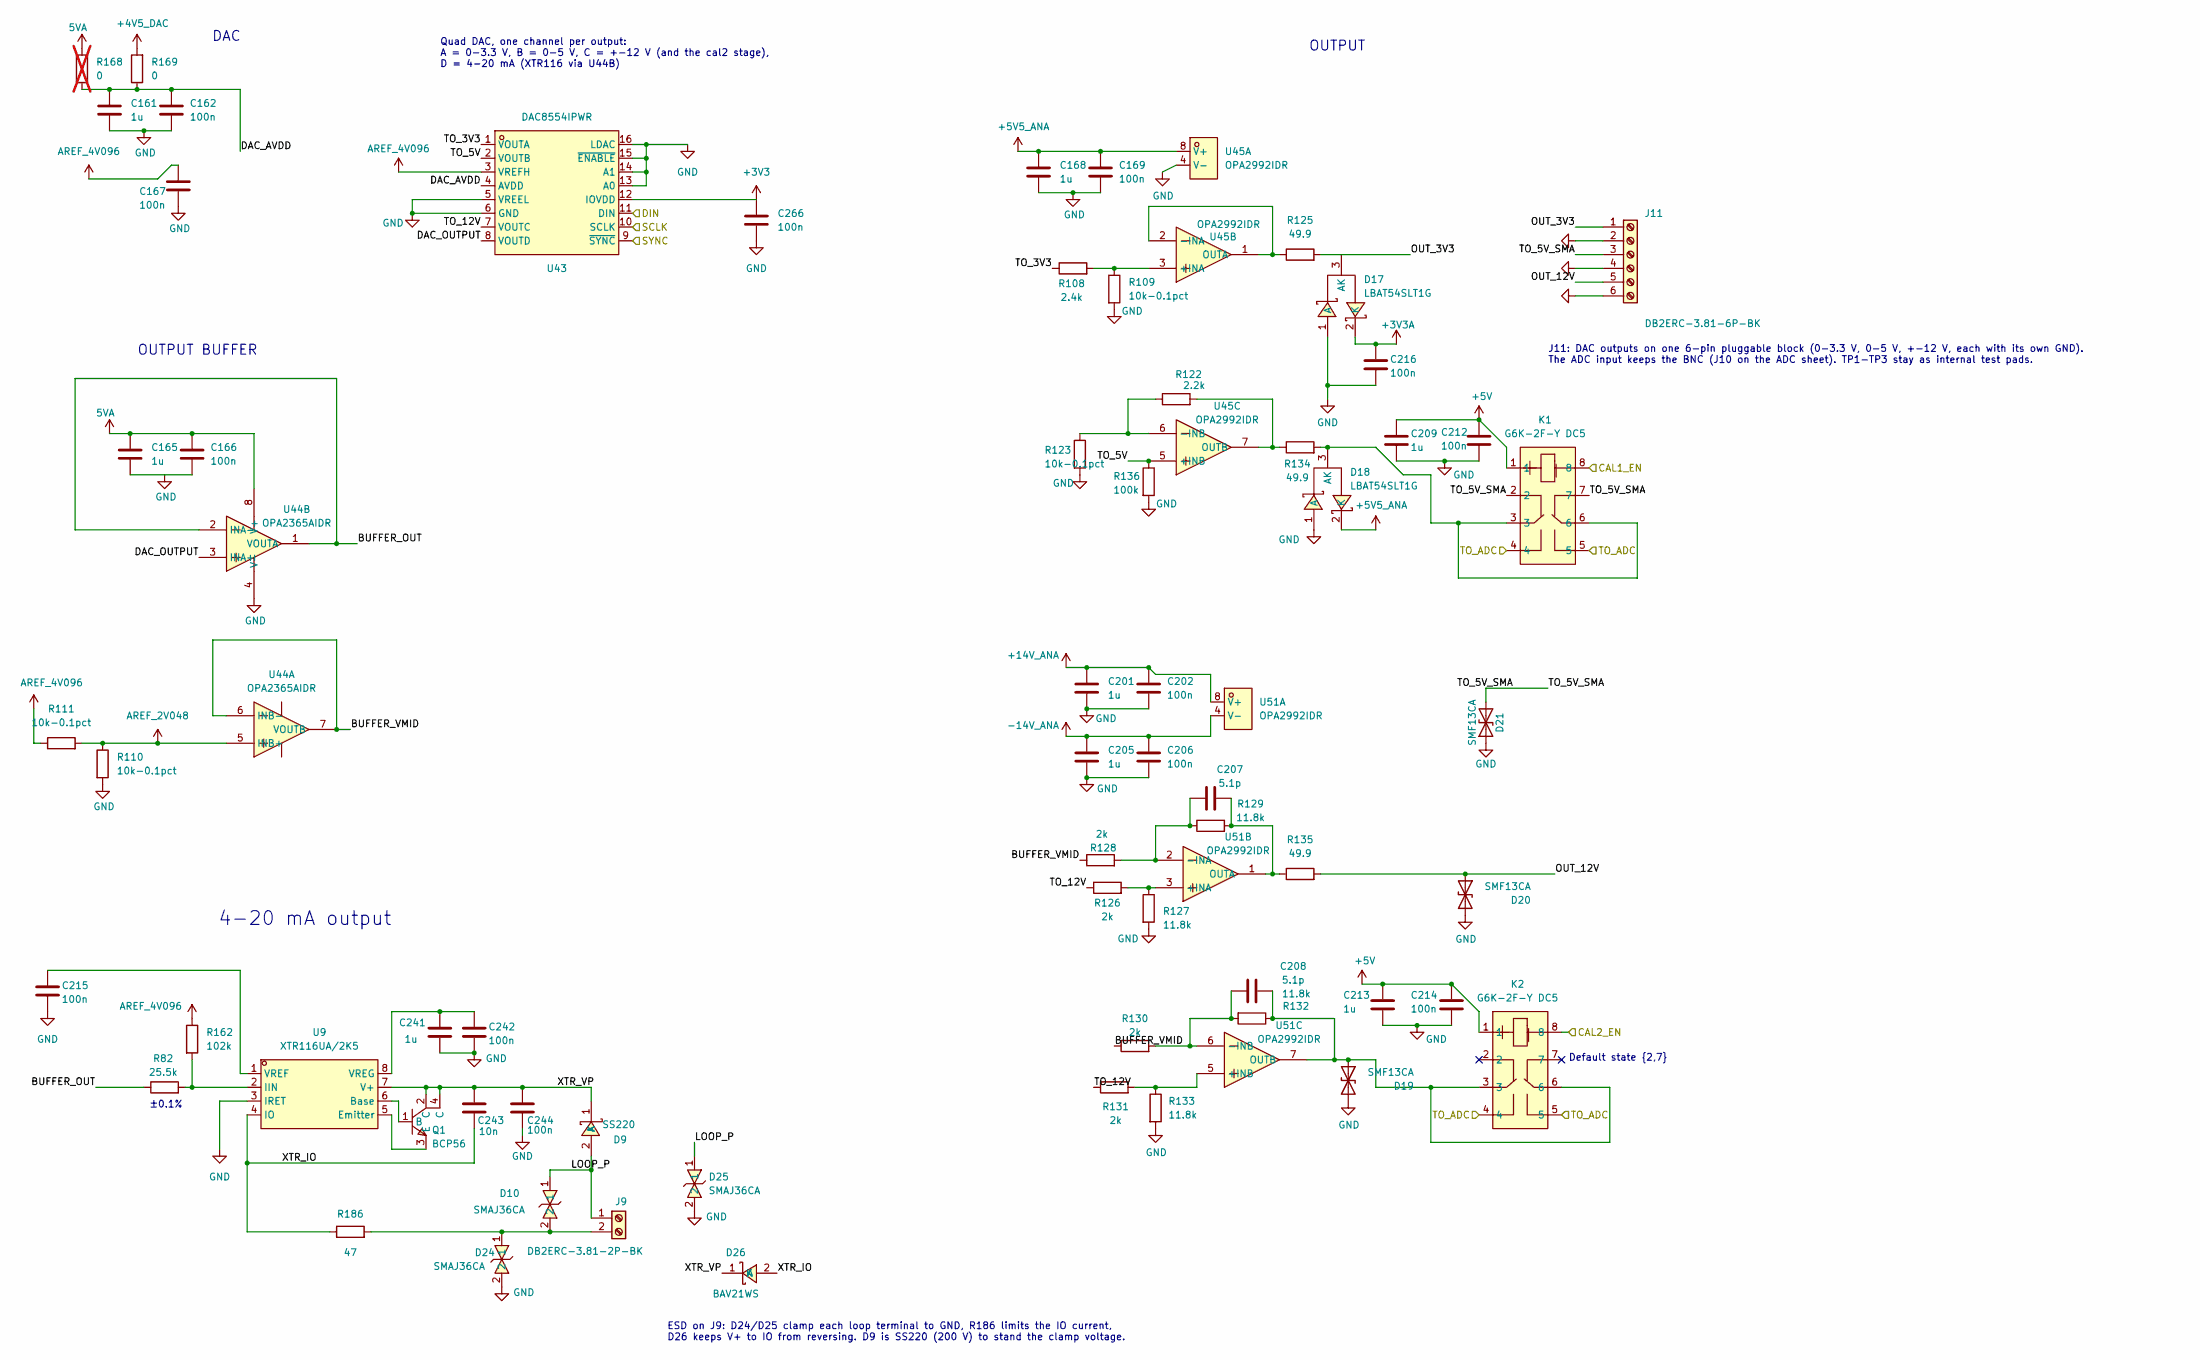
[picture p2: schematic digital-to-analog-v2.kicad_sch]

Parts:
C161, C201, C205, C241: 1u; C_0402_1005Metric; MPN GRM155R61H105KE05D; LCSC C1518208
C162, C166, C167, C169, C202, C206, C212, C214, C215, C216, C242, C244: 100n; C_0402_1005Metric; MPN CC0603KRX7R9BB104; LCSC C307331
C165, C168, C209, C213: 1u; C_0402_1005Metric; MPN CL05A105KA5NQNC; LCSC C52923
C207, C208: 5.1p; C_0603_1608Metric; LCSC C20617868
C243: 10n; C_0402_1005Metric; LCSC C15195
C266: 100n; C_0402_1005Metric; LCSC C307331
D9: SS220; SMA_L4.3-W2.6-LS5.2-RD; MPN SS220; LCSC Part C7420361
D10, D24, D25: SMAJ36CA; SMA_L4.3-W2.6-LS5.0-BI; MPN SMAJ36CA; LCSC Part C5353135
D17, D18: LBAT54SLT1G; SOT-23_L2.9-W1.3-P1.90-LS2.4-BR; MPN LBAT54SLT1G; LCSC Part C12765
D19, D20: SMF13CA; SOD-123FL_L3.0-W1.8-LS3.7-BI; MPN SMF13CA; LCSC Part C1851355
D21: SMF13CA; SOD-123FL_L3.0-W1.8-LS3.7-BI; MPN SMF13CA; LCSC C1851355
D26: BAV21WS; D_SOD-323; MPN BAV21WS; LCSC Part C7420334
J9: DB2ERC-3.81-2P-BK; C5259145_CONN-TH_2P-P3.81_DB2ERC-3.81-2P-BK; MFR. Part # DB2ERC-3.81-2P-BK; LCSC Part # C5259145
J11: DB2ERC-3.81-6P-BK; C5244107_HDR-TH_DB2ERC-3.81-6P-BK; LCSC C5244107
K1, K2: G6K-2F-Y DC5; RELAY-TH_G6K-2F-Y; MPN G6K-2F-Y-TR DC5 BY OMR/C; LCSC Part C231390
Q1: BCP56; SOT-223-4_L6.5-W3.5-P2.30-LS7.0-BR; MPN BCP56; LCSC C5345976
R82: 25.5k; R_0603_1608Metric; LCSC C861257
R108: 2.4k; R_0603_1608Metric; LCSC C861300
R109, R110, R111, R123: 10k-0.1pct; R_0402_1005Metric; LCSC C190095
R122: 2.2k; R_0402_1005Metric; LCSC C326602
R125, R134, R135: 49.9; R_0402_1005Metric; LCSC C325388
R126, R128, R130, R131: 2k; R_0402_1005Metric; LCSC C852711
R127, R129, R132, R133: 11.8k; R_0402_1005Metric; LCSC C852496
R136: 100k; R_0402_1005Metric; LCSC C25741
R162: 102k; R_0603_1608Metric; LCSC C861068
R168: 0; R_0402_1005Metric; LCSC C17168; not fitted
R169: 0; R_0402_1005Metric; LCSC C17168
R186: 47; R_0603_1608Metric; LCSC C23182
U9: XTR116UA/2K5; SOIC-8_L5.0-W4.0-P1.27-LS6.0-BL; MPN XTR116UA/2K5; LCSC Part C368611
U43: DAC8554IPWR; C527522_TSSOP-16_L5_0-W4_4-P0_65-LS6_4-BL; MPN DAC8554IPWR; LCSC C527522
U44: OPA2365AIDR; SOIC-8_L4.9-W3.9-P1.27-LS6.0-BL; MPN OPA2365AIDR; LCSC Part C130011
U45, U51: OPA2992IDR; SOIC-8_L4.9-W3.9-P1.27-LS6.0-BL; MPN OPA2992IDR; LCSC Part C4368953

Connections:
5VA: C165.2, C166.2, R168.2, U44.8 (V+); also elsewhere on the board
+3V3: C266.1, U43.12 (IOVDD); also elsewhere on the board
+3V3A: C216.2, D17.2 (K); also elsewhere on the board
+4V5_DAC: R169.2; also elsewhere on the board
+5V: C209.2, C212.2, C213.2, C214.2, K1.1, K2.1; also elsewhere on the board
+5V5_ANA: C168.2, C169.2, D18.2 (K), U45.8 (V+); also elsewhere on the board
+14V_ANA: C201.2, C202.2, U51.8 (V+); also elsewhere on the board
-14V_ANA: C205.2, C206.2, U51.4 (V-); also elsewhere on the board
/CAL1_EN: K1.8; also elsewhere on the board
/CAL2_EN: K2.8; also elsewhere on the board
/DAC_DIN: U43.11 (DIN); also elsewhere on the board
/DAC_SCLK: U43.10 (SCLK); also elsewhere on the board
/DAC_SYNC: U43.9 (~SYNC); also elsewhere on the board
/DAC_TO_ADC: K1.4, K1.5, K2.4, K2.5; also elsewhere on the board
/digital to analog v2/BUFFER_OUT: R82.1, U44.1 (VOUTA), U44.2 (INA-)
/digital to analog v2/BUFFER_VMID: R128.1, R130.1, U44.6 (INB-), U44.7 (VOUTB)
/digital to analog v2/DAC_AVDD: C161.2, C162.2, R168.1, R169.1, U43.4 (AVDD)
/digital to analog v2/DAC_OUTPUT: U43.8 (VOUTD), U44.3 (INA+)
/digital to analog v2/OUT_3V3: D17.3 (AK), J11.1, R125.2
/digital to analog v2/OUT_12V: D20.1 (A1), J11.5, R135.2
/digital to analog v2/TO_3V3: R108.1, U43.1 (VOUTA)
/digital to analog v2/TO_5V: R136.1, U43.2 (VOUTB), U45.5 (+INB)
/digital to analog v2/TO_5V_SMA: D21.2 (A2), J11.3, K1.2, K1.7
/digital to analog v2/TO_12V: R126.1, R131.1, U43.7 (VOUTC)
AREF_2V048: R110.1, R111.2, U44.5 (INB+)
AREF_4V096: C167.2, R111.1, R162.1, U43.3 (VREFH); also elsewhere on the board
GND: C161.1, C162.1, C165.1, C166.1, C167.1, C168.1, C169.1, C201.1, C202.1, C205.1, C206.1, C209.1, C212.1, C213.1, C214.1, C215.1, C216.1, C241.1, C242.1, C244.1, C266.2, D17.1 (A), D18.1 (A), D19.2 (A2), D20.2 (A2), D21.1 (A1), D24.2, D25.2, J11.2, J11.4, J11.6, R109.2, R110.2, R123.2, R127.2, R133.2, R136.2, U9.3 (IRET), U43.5 (VREEL), U43.6 (GND), U43.13 (A0), U43.14 (A1), U43.15 (~ENABLE), U43.16 (LDAC), U44.4 (V-), U45.4 (V-); also elsewhere on the board
unnamed: D9.2 (A), D10.1, D25.1, J9.1
unnamed: C243.1, C244.2, D9.1 (K), D26.1 (K), Q1.2 (C), Q1.4 (C), U9.7 (V+)
unnamed: D18.3 (AK), K1.3, K1.6, R134.2
unnamed: C208.2, D19.1 (A1), K2.3, K2.6, R132.1, U51.7 (OUTB)
unnamed: Q1.1 (B), U9.6 (Base)
unnamed: Q1.3 (E), U9.5 (Emitter)
unnamed: R82.2, R162.2, U9.2 (IIN)
unnamed: C215.2, U9.1 (VREF)
unnamed: C241.2, C242.2, U9.8 (VREG)
unnamed: R108.2, R109.1, U45.3 (+INA)
unnamed: R125.1, U45.1 (OUTA), U45.2 (-INA)
unnamed: R122.1, R123.1, U45.6 (-INB)
unnamed: R122.2, R134.1, U45.7 (OUTB)
unnamed: R126.2, R127.1, U51.3 (+INA)
unnamed: C207.1, R128.2, R129.1, U51.2 (-INA)
unnamed: C207.2, R129.2, R135.1, U51.1 (OUTA)
unnamed: R131.2, R133.1, U51.5 (+INB)
unnamed: C208.1, R130.2, R132.2, U51.6 (-INB)

Notes on the sheet:
Default state {2,7}
J11: DAC outputs on one 6-pin pluggable block (0-3.3 V, 0-5 V, +-12 V, each with its own GND). The ADC input keeps the BNC (J10 on the ADC sheet). TP1-TP3 stay as internal test pads.
±0.1%
OUTPUT BUFFER
OUTPUT
Quad DAC, one channel per output: A = 0-3.3 V, B = 0-5 V, C = +-12 V (and the cal2 stage), D = 4-20 mA (XTR116 via U44B)
DAC
4-20 mA output
ESD on J9: D24/D25 clamp each loop terminal to GND, R186 limits the IO current, D26 keeps V+ to IO from reversing. D9 is SS220 (200 V) to stand the clamp voltage.

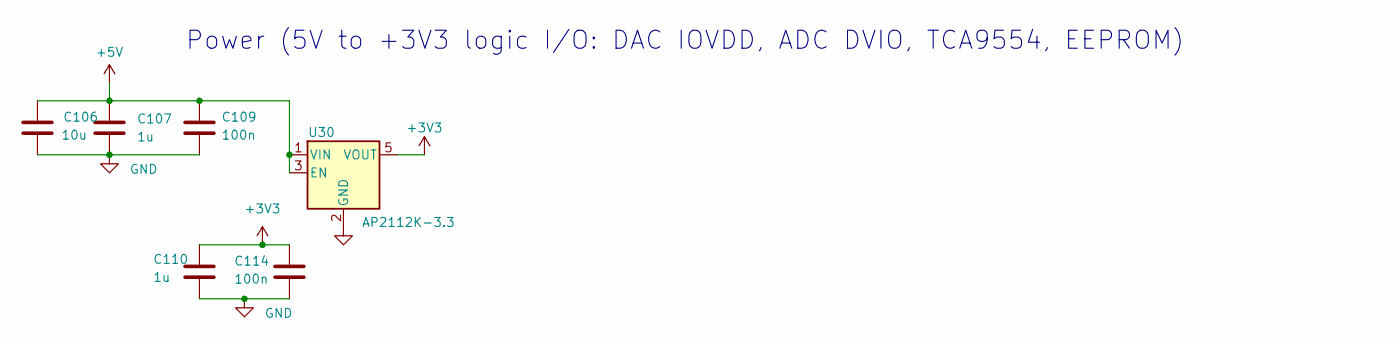
[picture p3: schematic power.kicad_sch]

Parts:
C106: 10u; C_0603_1608Metric; LCSC C96446
C107: 1u; C_0402_1005Metric; MPN CL05A105KA5NQNC; LCSC C52923
C109, C114: 100n; C_0402_1005Metric; MPN CC0603KRX7R9BB104; LCSC C307331
C110: 1u; C_0402_1005Metric; MPN GRM155R61H105KE05D; LCSC C1518208
U30: AP2112K-3.3; SOT-25-5_L2.9-W1.6-P0.95-LS2.8-BL; LCSC C51118

Connections:
+3V3: C110.2, C114.2, U30.5 (VOUT); also elsewhere on the board
+5V: C106.2, C107.2, C109.2, U30.1 (VIN), U30.3 (EN); also elsewhere on the board
GND: C106.1, C107.1, C109.1, C110.1, C114.1, U30.2 (GND); also elsewhere on the board

Notes on the sheet:
Power (5V to +3V3 logic I/O: DAC IOVDD, ADC DVIO, TCA9554, EEPROM)

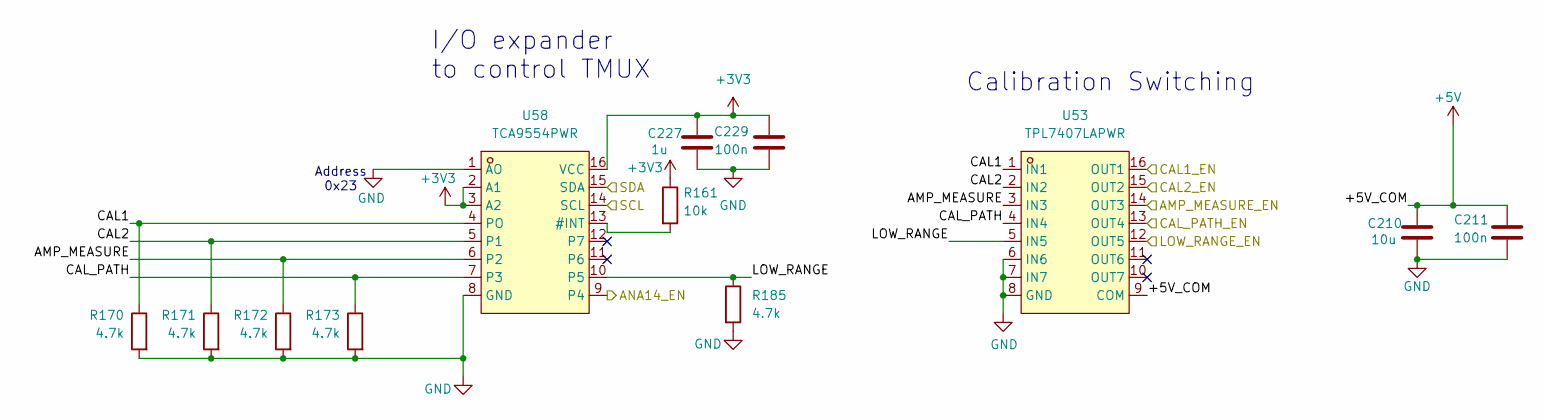
[picture p4: schematic analog-switching.kicad_sch]

Parts:
C210: 10u; C_0603_1608Metric; MPN CL21B105KBFNNNE; LCSC C96446
C211: 100n; C_0402_1005Metric; MPN CC0603KRX7R9BB104; LCSC C307331
C227: 1u; C_0402_1005Metric; MPN GRM155R61H105KE05D; LCSC C1518208
C229: 100n; C_0402_1005Metric; LCSC C307331
R161: 10k; R_0402_1005Metric; LCSC C25744
R170, R171, R172, R173, R185: 4.7k; R_0402_1005Metric; LCSC C25900
U53: TPL7407LAPWR; TSSOP-16_L5.0-W4.4-P0.65-LS6.4-BL; MPN TPL7407LAPWR; LCSC Part C2149827
U58: TCA9554PWR; TSSOP-16_L5.0-W4.4-P0.65-LS6.4-TL; MPN TCA9554PWR; LCSC Part C477924

Connections:
+3V3: C227.2, C229.1, R161.1, U58.2 (A1), U58.3 (A2), U58.16 (VCC); also elsewhere on the board
+5V: C210.2, C211.2, U53.9 (COM); also elsewhere on the board
/AMP_MEAS_EN: U53.14 (OUT3); also elsewhere on the board
/ANA14_EN: U58.9 (P4); also elsewhere on the board
/CAL1_EN: U53.16 (OUT1); also elsewhere on the board
/CAL2_EN: U53.15 (OUT2); also elsewhere on the board
/CAL_PATH_EN: U53.13 (OUT4); also elsewhere on the board
/I2C0_SCL: U58.14 (SCL); also elsewhere on the board
/I2C0_SDA: U58.15 (SDA); also elsewhere on the board
/LOW_RANGE_EN: U53.12 (OUT5); also elsewhere on the board
/analog switching/AMP_MEASURE: R172.1, U53.3 (IN3), U58.6 (P2)
/analog switching/CAL1: R170.1, U53.1 (IN1), U58.4 (PO)
/analog switching/CAL2: R171.1, U53.2 (IN2), U58.5 (P1)
/analog switching/CAL_PATH: R173.1, U53.4 (IN4), U58.7 (P3)
/analog switching/LOW_RANGE: R185.1, U53.5 (IN5), U58.10 (P5)
GND: C210.1, C211.1, C227.1, C229.2, R170.2, R171.2, R172.2, R173.2, R185.2, U53.6 (IN6), U53.7 (IN7), U53.8 (GND), U58.1 (AO), U58.8 (GND); also elsewhere on the board
unnamed: R161.2, U58.13 (#INT)

Notes on the sheet:
I/O expander to control TMUX
Calibration Switching
Address 0x23

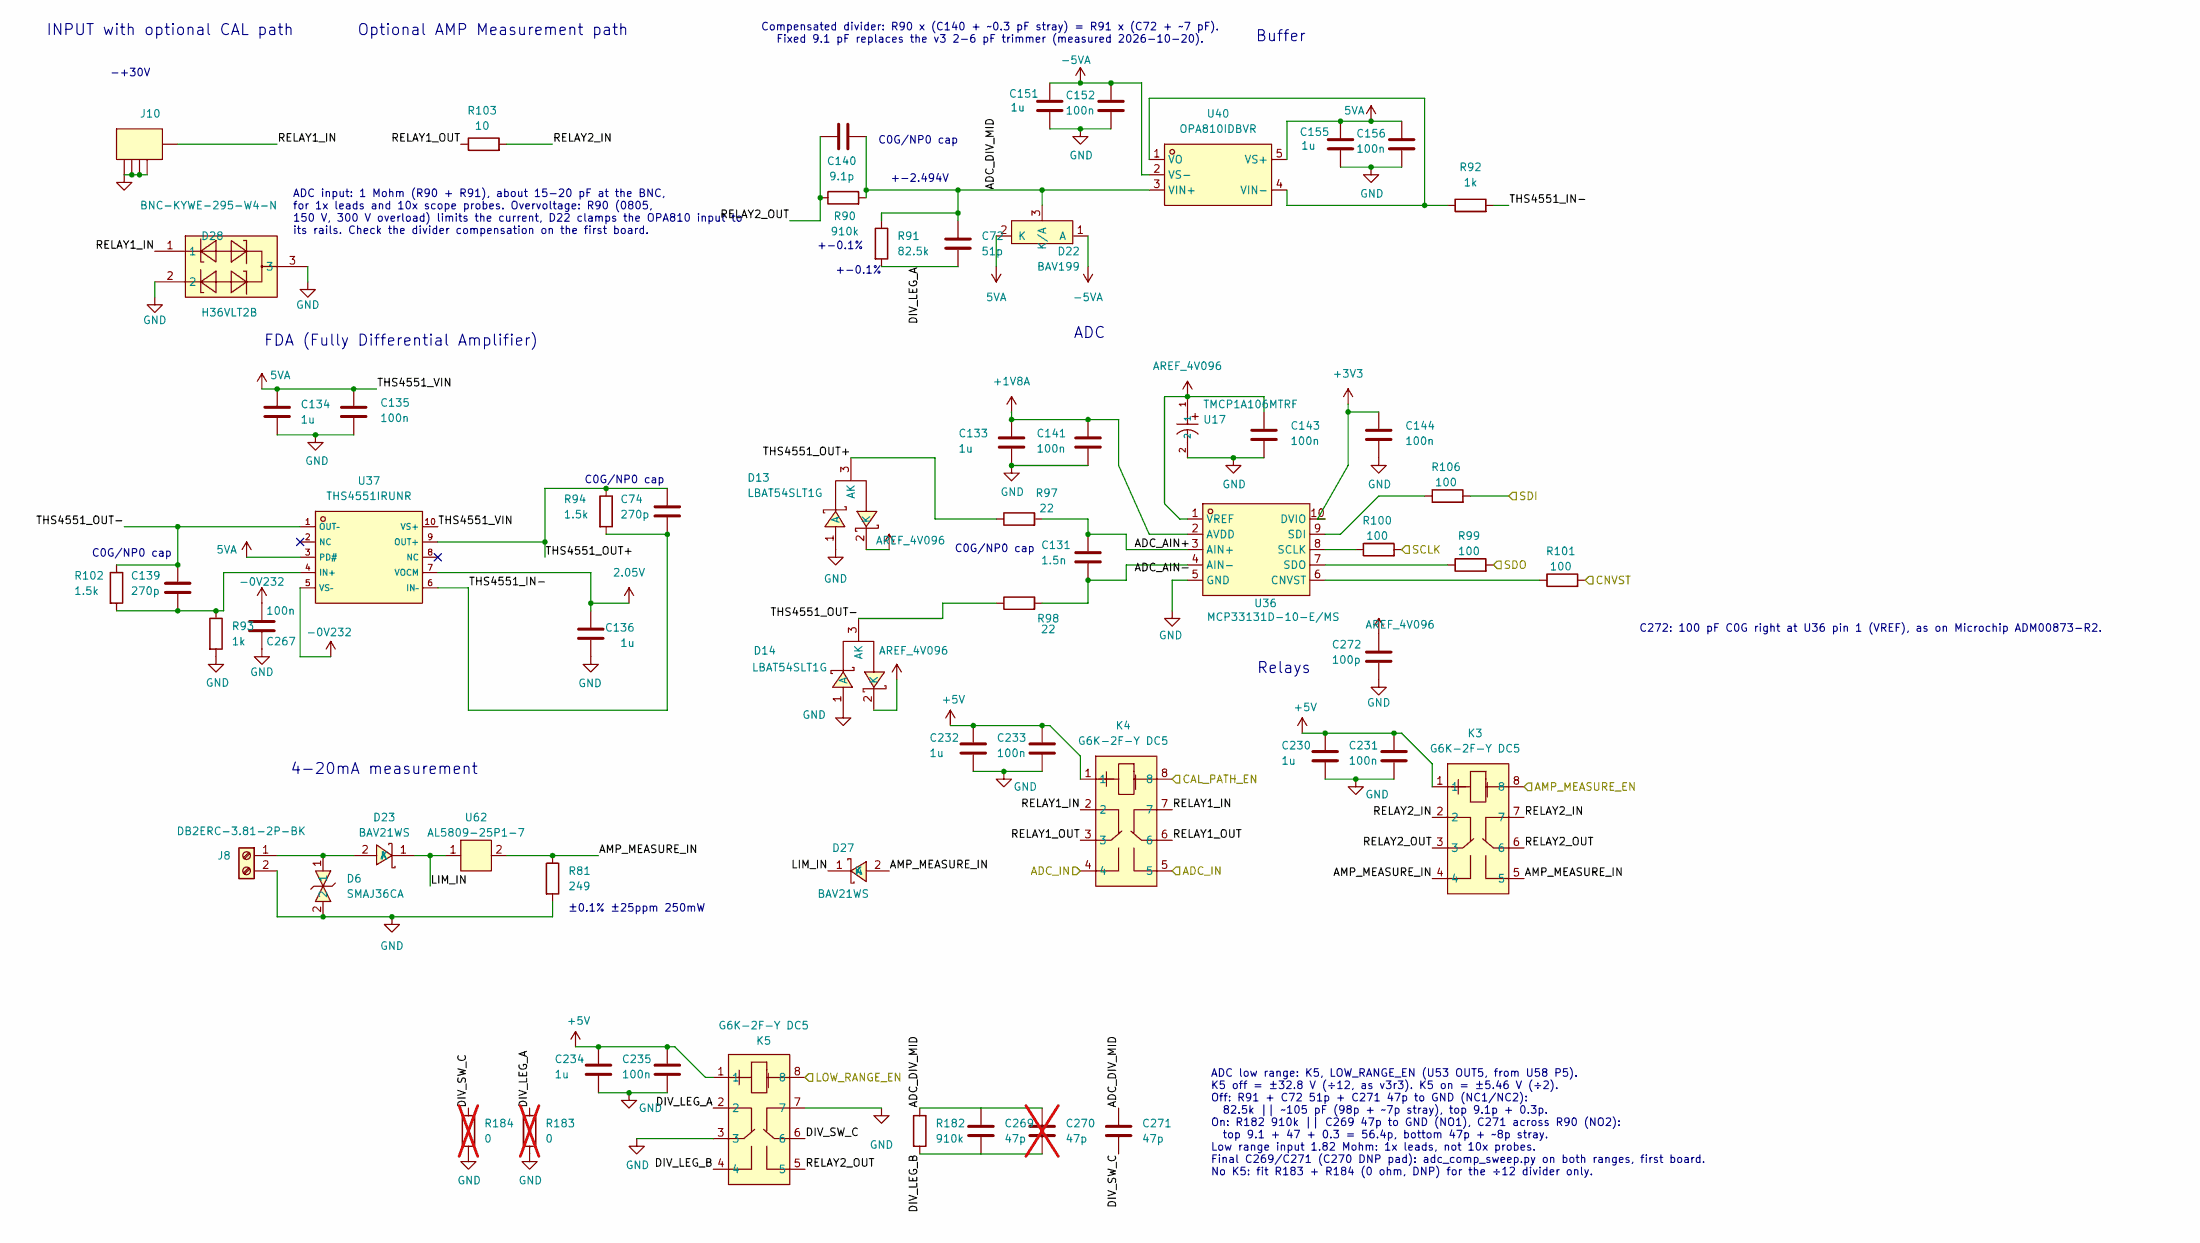
[picture p5: schematic analog-to-digital-v2.kicad_sch]

Parts:
C72: 51p; C_0402_1005Metric; LCSC C541437
C74, C139: 270p; C_0402_1005Metric; LCSC C161545
C131: 1.5n; C_0402_1005Metric; LCSC C668348
C133, C136: 1u; C_0402_1005Metric; MPN GRM155R61H105KE05D; LCSC C1518208
C134, C151, C155, C230, C232, C234: 1u; C_0402_1005Metric; MPN CL05A105KA5NQNC; LCSC C52923
C135, C141, C143, C144, C152, C156, C231, C233, C235: 100n; C_0402_1005Metric; MPN CC0603KRX7R9BB104; LCSC C307331
C140: 9.1p; C_0603_1608Metric; MPN GQM1875C2E9R1BB12D; LCSC C2299929
C267: 100n; C_0402_1005Metric; LCSC C307331
C269: 47p; C_0402_1005Metric; LCSC C277503
C270: 47p; C_0402_1005Metric; LCSC C277503; not fitted
C271: 47p; C_0603_1608Metric; LCSC C882574
C272: 100p; C_0402_1005Metric; MPN 0402CG101J500NT; LCSC C1546
D6: SMAJ36CA; SMA_L4.3-W2.6-LS5.0-BI; MPN SMAJ36CA; LCSC Part C5353135
D13, D14: LBAT54SLT1G; SOT-23_L2.9-W1.3-P1.90-LS2.4-BR; MPN LBAT54SLT1G; LCSC Part C12765
D22: BAV199; C145516_SOT-23_L2.9-W1.3-P1.90-LS2.4-BR; LCSC C145516
D23, D27: BAV21WS; D_SOD-323; MPN BAV21WS; LCSC Part C7420334
D28: H36VLT2B; SOT-23; LCSC C20615828
J8: DB2ERC-3.81-2P-BK; C5259145_CONN-TH_2P-P3.81_DB2ERC-3.81-2P-BK; MFR. Part # DB2ERC-3.81-2P-BK; LCSC Part # C5259145
J10: BNC-KYWE-295-W4-N; C41416668_BNC-TH_BNC-KYWE-295-W4-N; LCSC C41416668
K3, K4, K5: G6K-2F-Y DC5; RELAY-TH_G6K-2F-Y; MPN G6K-2F-Y-TR DC5 BY OMR/C; LCSC Part C231390
R81: 249; R_1206_3216Metric; LCSC C870575
R90: 910k; R_0805_2012Metric; LCSC C865698
R91: 82.5k; R_0603_1608Metric; LCSC C705796
R92, R93: 1k; R_0402_1005Metric; LCSC C852624
R94, R102: 1.5k; R_0402_1005Metric; LCSC C281775
R97, R98: 22; R_0402_1005Metric; LCSC C25092
R99, R100, R101, R106: 100; R_0402_1005Metric; LCSC C25076
R103: 10; R_0402_1005Metric; LCSC C25077
R182: 910k; R_0603_1608Metric; LCSC C2686431
R183, R184: 0; R_0603_1608Metric; LCSC C21189; not fitted
U17: TMCP1A106MTRF; C1969735_CAP-SMD_L2_0-W1_3-FD; LCSC C1969735
U36: MCP33131D-10-E/MS; MSOP-10_L3.0-W3.0-P0.50-LS5.0-BL; MPN MCP33131D-10-E/MS; LCSC Part C635978
U37: THS4551IRUNR; C2060364_QFN-10_L2_0-W2_0-P0_50-BL; LCSC C2060364
U40: OPA810IDBVR; SOT-23-5_L2.9-W1.6-P0.95-LS2.8-TL; MPN OPA810IDBVR; LCSC Part C2833513
U62: AL5809-25P1-7; POWERDI-123_L2.7-W1.6-LS3.7-RD; MPN AL5809-25P1-7; LCSC Part C2678668

Connections:
2.05V: C136.2, U37.7 (VOCM); also elsewhere on the board
5VA: C134.2, C135.2, C155.2, C156.2, D22.2 (K), U37.3 (PD#), U37.10 (VS+), U40.5 (VS+); also elsewhere on the board
+1V8A: C133.2, C141.2, U36.2 (AVDD); also elsewhere on the board
+3V3: C144.2, U36.10 (DVIO); also elsewhere on the board
+5V: C230.2, C231.2, C232.2, C233.2, C234.2, C235.2, K3.1, K4.1, K5.1; also elsewhere on the board
-5VA: C151.2, C152.2, D22.1 (A), U40.2 (VS-); also elsewhere on the board
/ADC_CNVST: R101.2; also elsewhere on the board
/ADC_SCLK: R100.2; also elsewhere on the board
/ADC_SDI: R106.2; also elsewhere on the board
/ADC_SDO: R99.2; also elsewhere on the board
/AMP_MEAS_EN: K3.8; also elsewhere on the board
/CAL_PATH_EN: K4.8; also elsewhere on the board
/DAC_TO_ADC: K4.4, K4.5; also elsewhere on the board
/LOW_RANGE_EN: K5.8; also elsewhere on the board
/analog to digital v2/ADC_DIV_MID: C72.1, C140.2, C269.1, C270.1, C271.1, D22.3 (K/A), R90.2, R91.1, R182.1, U40.3 (VIN+)
/analog to digital v2/DIV_LEG_A: C72.2, K5.2, R91.2, R183.1
/analog to digital v2/DIV_LEG_B: C269.2, C270.2, K5.4, R182.2
/analog to digital v2/DIV_SW_C: C271.2, K5.6, R184.1
/analog to digital v2/RELAY1_IN: D28.1, J10.5 (OUT), K4.2, K4.7
/analog to digital v2/RELAY1_OUT: K4.3, K4.6, R103.1
/analog to digital v2/RELAY2_IN: K3.2, K3.7, R103.2
/analog to digital v2/RELAY2_OUT: C140.1, K3.3, K3.6, K5.5, R90.1
/analog to digital v2/THS4551_IN-: C74.2, R92.2, R94.2, U37.6 (IN–)
/analog to digital v2/THS4551_OUT+: C74.1, D13.3 (AK), R94.1, R97.1, U37.9 (OUT+)
/analog to digital v2/THS4551_OUT-: C139.1, D14.3 (AK), R98.1, R102.1, U37.1 (OUT–)
AREF_4V096: C143.2, C272.1, D13.2 (K), D14.2 (K), U17.1, U36.1 (VREF); also elsewhere on the board
GND: C133.1, C134.1, C135.1, C136.1, C141.1, C143.1, C144.1, C151.1, C152.1, C155.1, C156.1, C230.1, C231.1, C232.1, C233.1, C234.1, C235.1, C267.2, C272.2, D6.2, D13.1 (A), D14.1 (A), D28.2, D28.3, J8.2, J10.1 (GND), J10.2 (GND), J10.3 (GND), J10.4 (GND), K5.3, K5.7, R81.2, R93.2, R183.2, R184.2, U17.2, U36.5 (GND); also elsewhere on the board
unnamed: D23.1 (K), D27.1 (K), U62.1 (In)
unnamed: C131.1, R97.2, U36.3 (AIN+)
unnamed: C131.2, R98.2, U36.4 (AIN-)
unnamed: R101.1, U36.6 (CNVST)
unnamed: R100.1, U36.8 (SCLK)
unnamed: R106.1, U36.9 (SDI)
unnamed: R99.1, U36.7 (SDO)
unnamed: C139.2, R93.1, R102.2, U37.4 (IN+)
unnamed: R92.1, U40.1 (VO), U40.4 (VIN-)
−0V232: C267.1, U37.5 (VS–); also elsewhere on the board

Notes on the sheet:
C0G/NP0 cap
4-20mA measurement
+-0.1%
ADC
+-2.494V
Buffer
±0.1% ±25ppm 250mW
Optional AMP Measurement path
Relays
ADC input: 1 Mohm (R90 + R91), about 15-20 pF at the BNC, for 1x leads and 10x scope probes. Overvoltage: R90 (0805, 150 V, 300 V overload) limits the current, D22 clamps the OPA810 input to its rails. Check the divider compensation on the first board.
FDA (Fully Differential Amplifier)
INPUT with optional CAL path
-+30V
Compensated divider: R90 x (C140 + ~0.3 pF stray) = R91 x (C72 + ~7 pF). Fixed 9.1 pF replaces the v3 2-6 pF trimmer (measured 2026-10-20).
ADC low range: K5, LOW_RANGE_EN (U53 OUT5, from U58 P5). K5 off = ±32.8 V (÷12, as v3r3). K5 on = ±5.46 V (÷2). Off: R91 + C72 51p + C271 47p to GND (NC1/NC2): 82.5k || ~105 pF (98p + ~7p stray), top 9.1p + 0.3p. On: R182 910k || C269 47p to GND (NO1), C271 across R90 (NO2): top 9.1 + 47 + 0.3 = 56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
C272: 100 pF C0G right at U36 pin 1 (VREF), as on Microchip ADM00873-R2.
