embeddedci-com/benchpod/pcb/benchpod-analog/vbench-pod.kicad_pcb

## KiCad design pcb/benchpod-analog/vbench-pod.kicad_pcb (continued)

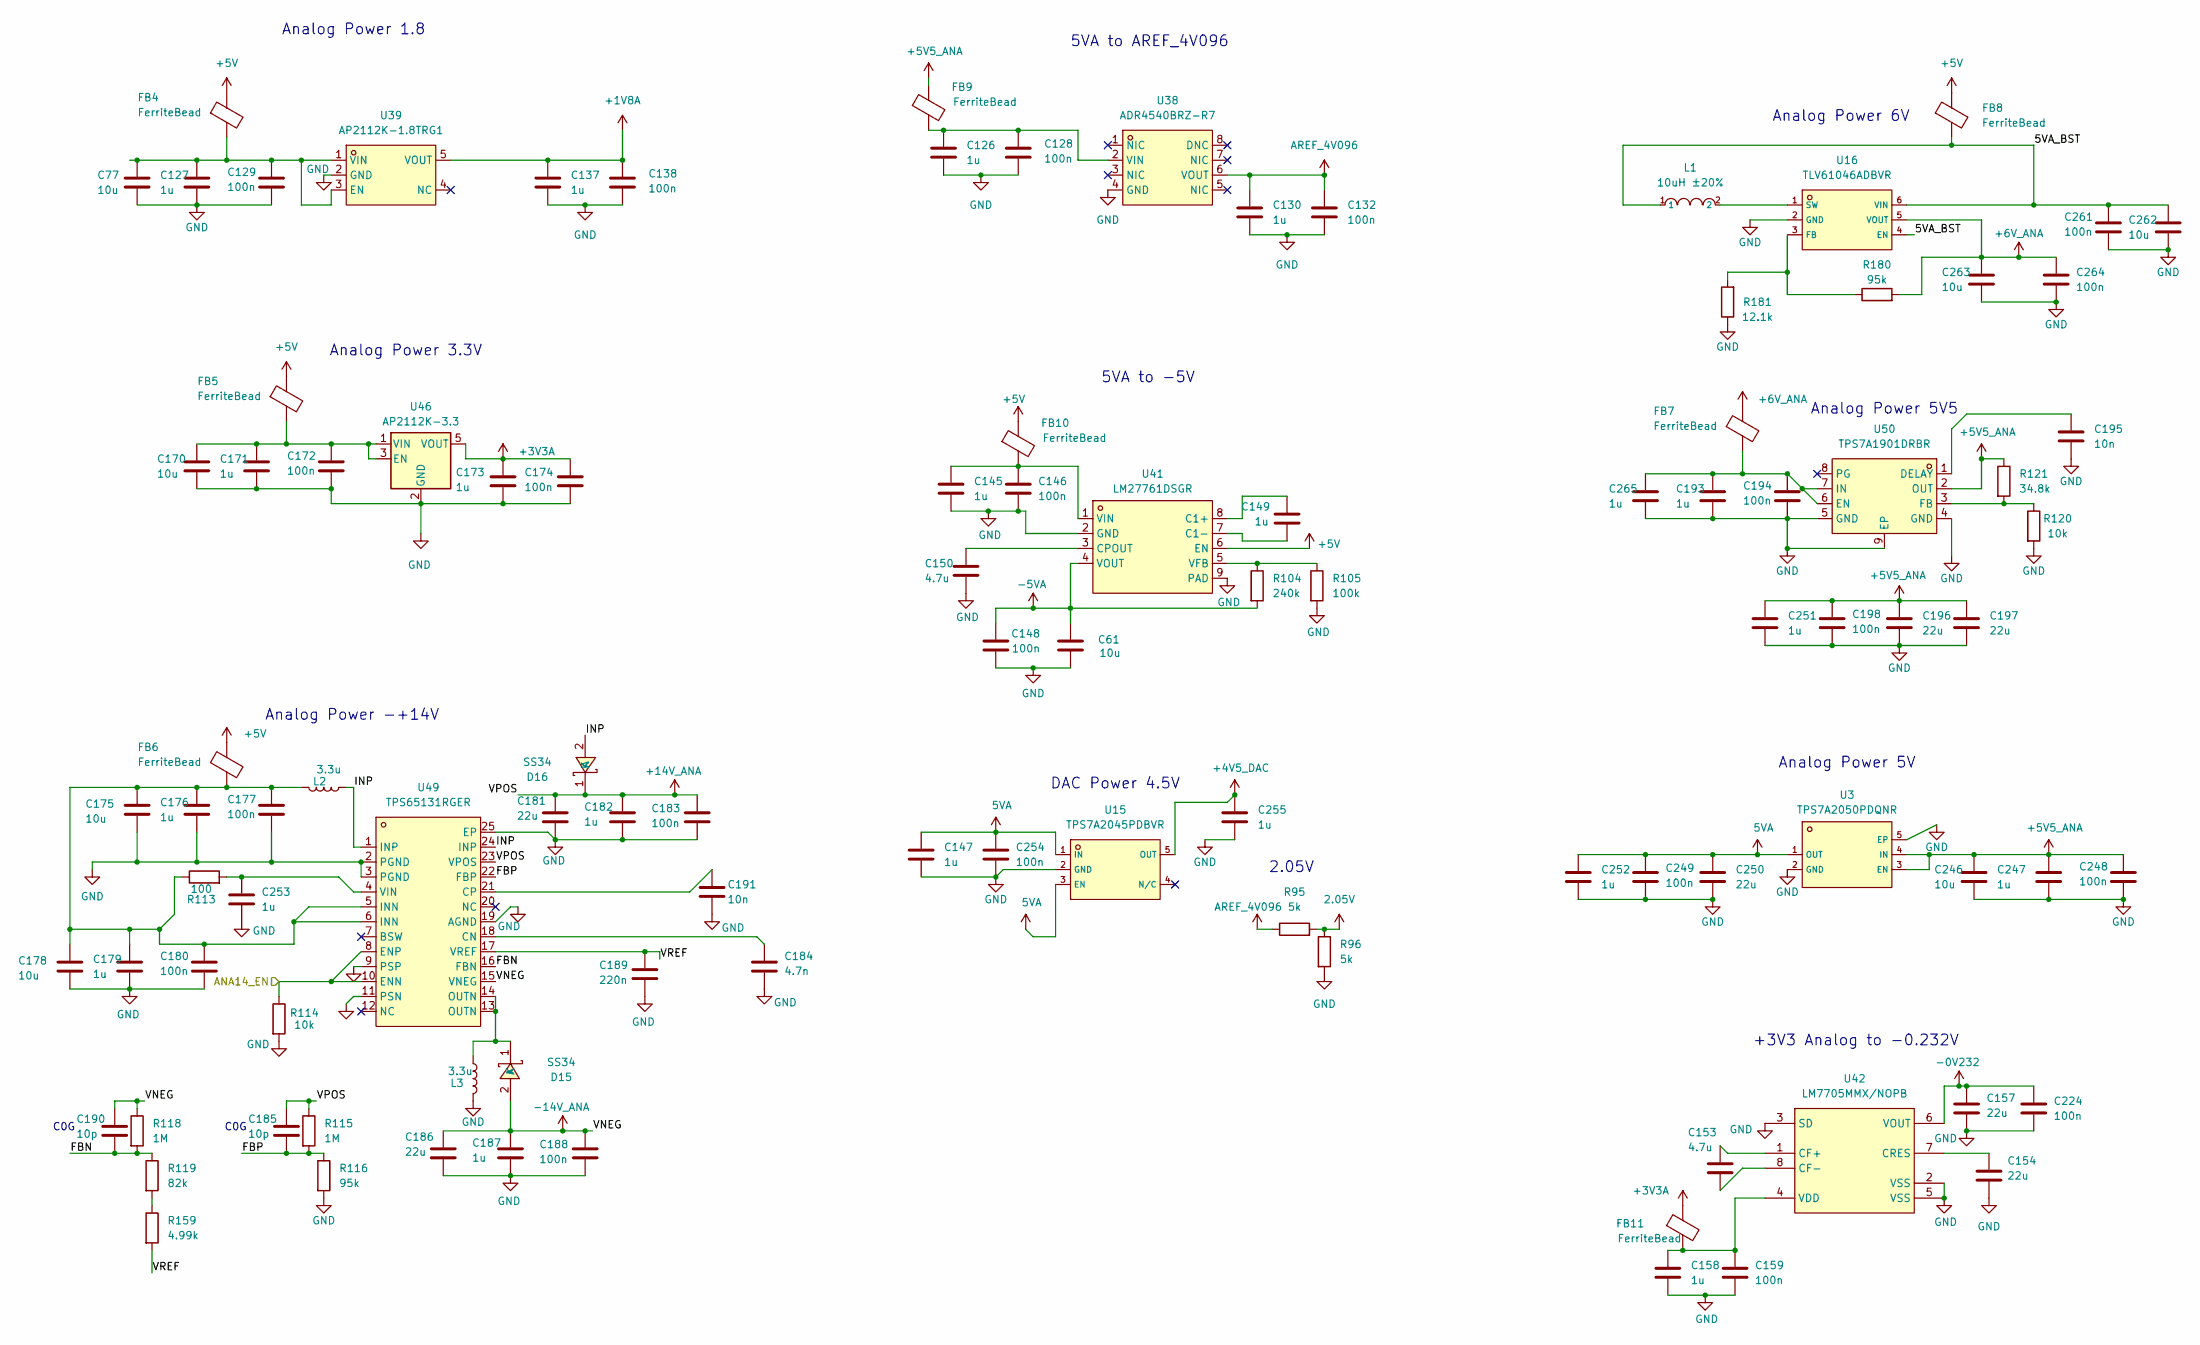
[picture p6: schematic analog-power-v2.kicad_sch]

Parts:
C61: 10u; C_0603_1608Metric; LCSC C96446
C77, C170, C175, C178, C246, C262, C263: 10u; C_0603_1608Metric; MPN GRM21BR61H106KE43L; LCSC C96446
C126, C130, C137, C145, C149, C158, C173, C176, C179, C182, C187, C193, C253, C255, C265: 1u; C_0402_1005Metric; MPN GRM155R61H105KE05D; LCSC C1518208
C127, C147, C171, C247, C251, C252: 1u; C_0402_1005Metric; MPN CL05A105KA5NQNC; LCSC C52923
C128, C129, C132, C138, C146, C148, C159, C172, C174, C177, C180, C183, C188, C194, C198, C224, C248, C249, C254, C261, C264: 100n; C_0402_1005Metric; MPN CC0603KRX7R9BB104; LCSC C307331
C150, C153: 4.7u; C_0805_2012Metric; LCSC C98192
C154, C157, C196, C197, C250: 22u; C_0805_2012Metric; LCSC C45783
C181, C186: 22u; C_0805_2012Metric; MPN CL21B105KBFNNNE; LCSC C45783
C184: 4.7n; C_0402_1005Metric; MPN CC0603KRX7R9BB104; LCSC C1538
C185, C190: 10p; C_0402_1005Metric; LCSC C32949
C189: 220n; C_0603_1608Metric; LCSC C64705
C191, C195: 10n; C_0402_1005Metric; LCSC C15195
D15, D16: SS34; SMA_L4.3-W2.6-LS5.2-RD; MPN SS34; LCSC Part C3014011
FB4, FB5, FB6, FB7, FB8, FB9, FB10, FB11: FerriteBead; C85833_L0603; LCSC C85833
L1: 10uH ±20%; C38117_IND-SMD_L4_0-W4_0; LCSC C38117
L2, L3: 3.3u; IND-SMD_L2.0-W1.6_AOTA-B201610S3R3-101-T; LCSC C42411119
R95, R96: 5k; R_0402_1005Metric; LCSC C5948099
R104: 240k; R_0402_1005Metric; LCSC C64043
R105: 100k; R_0402_1005Metric; LCSC C25741
R113: 100; R_0402_1005Metric; LCSC C25076
R114, R120: 10k; R_0402_1005Metric; LCSC C25744
R115, R118: 1M; R_0603_1608Metric; LCSC C22935
R116, R180: 95k; R_0402_1005Metric; LCSC C22375098
R119: 82k; R_0603_1608Metric; LCSC C23254
R121: 34.8k; R_0402_1005Metric; LCSC C2998092
R159: 4.99k; R_0603_1608Metric; LCSC C23046
R181: 12.1k; R_0402_1005Metric; LCSC C25852
U3: TPS7A2050PDQNR; C2866499_X2SON-4_L1_0-W1_0-P0_65-TL-EP; LCSC C2866499
U15: TPS7A2045PDBVR; C2873627_SOT-23-5_L2_9-W1_6-P0_95-LS2_8-BR; LCSC C2873627
U16: TLV61046ADBVR; C464815_SOT-23-6_L2_9-W1_6-P0_95-LS2_8-BL; LCSC C464815
U38: ADR4540BRZ-R7; SOIC-8_L4.9-W3.9-P1.27-LS6.0-BL; MPN ADR4540BRZ-R7; LCSC Part C404003
U39: AP2112K-1.8TRG1; SOT-25_L3.0-W1.6-P0.95-LS2.8-BL; MPN AP2112K-1.8TRG1; LCSC Part C176944
U41: LM27761DSGR; WSON-8_L2.0-W2.0-P0.65-BL-EP; MPN LM27761DSGR; LCSC Part C129351
U42: LM7705MMX/NOPB; MSOP-8_L3.0-W3.0-P0.65-LS5.0-BL; MPN LM7705MMX/NOPB; LCSC Part C2070761
U46: AP2112K-3.3; SOT-25-5_L2.9-W1.6-P0.95-LS2.8-BL; LCSC C51118
U49: TPS65131RGER; VQFN-24_L4.0-W4.0-P0.50-BL-EP2.5; LCSC Part C87663
U50: TPS7A1901DRBR; TDFN-8_L3.0-W3.0-P0.65-BL-EP; MPN TPS7A1901DRBR; LCSC Part C544334

Connections:
2.05V: R95.2, R96.1; also elsewhere on the board
5VA: C147.2, C249.2, C250.1, C252.2, C254.2, U3.1 (OUT), U15.1 (IN), U15.3 (EN); also elsewhere on the board
+1V8A: C137.2, C138.2, U39.5 (VOUT); also elsewhere on the board
+3V3A: C173.2, C174.2, FB11.1, U46.5 (VOUT); also elsewhere on the board
+4V5_DAC: C255.2, U15.5 (OUT); also elsewhere on the board
+5V: FB4.1, FB5.1, FB6.1, FB8.1, FB10.1, U41.6 (EN); also elsewhere on the board
+5V5_ANA: C196.1, C197.1, C198.2, C246.2, C247.2, C248.2, C251.2, FB9.1, R121.1, U3.3 (EN), U3.4 (IN), U50.2 (OUT); also elsewhere on the board
+6V_ANA: C263.2, C264.2, FB7.1, R180.2, U16.5 (VOUT)
+14V_ANA: C181.2, C182.2, C183.2, C185.1, D16.1 (K), R115.1, U49.23 (VPOS); also elsewhere on the board
-5VA: C61.1, C148.2, R104.2, U41.4 (VOUT); also elsewhere on the board
-14V_ANA: C186.2, C187.2, C188.2, C190.1, D15.2 (A), R118.1, U49.15 (VNEG); also elsewhere on the board
/ANA14_EN: R114.1, U49.8 (ENP), U49.10 (ENN); also elsewhere on the board
/Analog Power v2/5VA_BST: C261.2, C262.2, FB8.2, L1.1, U16.4 (EN), U16.6 (VIN)
/Analog Power v2/FBN: C190.2, R118.2, R119.1, U49.16 (FBN)
/Analog Power v2/FBP: C185.2, R115.2, R116.1, U49.22 (FBP)
/Analog Power v2/INP: D16.2 (A), L2.1, U49.1 (INP), U49.24 (INP)
/Analog Power v2/VREF: C189.2, R159.2, U49.17 (VREF)
AREF_4V096: C130.2, C132.2, R95.1, U38.6 (VOUT); also elsewhere on the board
GND: C61.2, C77.1, C126.1, C127.1, C128.1, C129.1, C130.1, C132.1, C137.1, C138.1, C145.1, C146.1, C147.1, C148.1, C150.2, C154.2, C157.2, C158.1, C159.1, C170.1, C171.1, C172.1, C173.1, C174.1, C175.1, C176.1, C177.1, C178.1, C179.1, C180.1, C181.1, C182.1, C183.1, C184.1, C186.1, C187.1, C188.1, C189.1, C191.2, C193.1, C194.1, C195.2, C196.2, C197.2, C198.1, C224.1, C246.1, C247.1, C248.1, C249.1, C250.2, C251.1, C252.1, C253.1, C254.1, C255.1, C261.1, C262.1, C263.1, C264.1, C265.1, L3.2, R96.2, R105.2, R114.2, R116.2, R120.2, R181.1, U3.2 (GND), U3.5 (EP), U15.2 (GND), U16.2 (GND), U38.4 (GND), U39.2 (GND), U41.2 (GND), U41.9 (PAD), U42.2 (VSS), U42.3 (SD), U42.5 (VSS), U46.2 (GND), U49.2 (PGND), U49.3 (PGND), U49.9 (PSP), U49.11 (PSN), U49.19 (AGND), U49.25 (EP), U50.4 (GND), U50.5 (GND), U50.9 (EP); also elsewhere on the board
unnamed: C175.2, C176.2, C177.2, C178.2, C179.2, C180.2, FB6.2, L2.2, R113.1, U49.5 (INN), U49.6 (INN)
unnamed: D15.1 (K), L3.1, U49.13 (OUTN), U49.14 (OUTN)
unnamed: R119.2, R159.1
unnamed: R180.1, R181.2, U16.3 (FB)
unnamed: L1.2, U16.1 (SW)
unnamed: C126.2, C128.2, FB9.2, U38.2 (VIN)
unnamed: C77.2, C127.2, C129.2, FB4.2, U39.1 (VIN), U39.3 (EN)
unnamed: C149.2, U41.8 (C1+)
unnamed: C149.1, U41.7 (C1-)
unnamed: C150.1, U41.3 (CPOUT)
unnamed: R104.1, R105.1, U41.5 (VFB)
unnamed: C145.2, C146.2, FB10.2, U41.1 (VIN)
unnamed: C153.1, U42.1 (CF+)
unnamed: C153.2, U42.8 (CF-)
unnamed: C154.1, U42.7 (CRES)
unnamed: C158.2, C159.2, FB11.2, U42.4 (VDD)
unnamed: C170.2, C171.2, C172.2, FB5.2, U46.1 (VIN), U46.3 (EN)
unnamed: C184.2, U49.18 (CN)
unnamed: C191.1, U49.21 (CP)
unnamed: C253.2, R113.2, U49.4 (VIN)
unnamed: C195.1, U50.1 (DELAY)
unnamed: C193.2, C194.2, C265.2, FB7.2, U50.6 (EN), U50.7 (IN)
unnamed: R120.1, R121.2, U50.3 (FB)
−0V232: C157.1, C224.2, U42.6 (VOUT); also elsewhere on the board

Notes on the sheet:
5VA to AREF_4V096
Analog Power 6V
DAC Power 4.5V
Analog Power 5V
5VA to -5V
Analog Power 5V5
C0G
2.05V
Analog Power 3.3V
Analog Power 1.8
+3V3 Analog to -0.232V
Analog Power -+14V

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
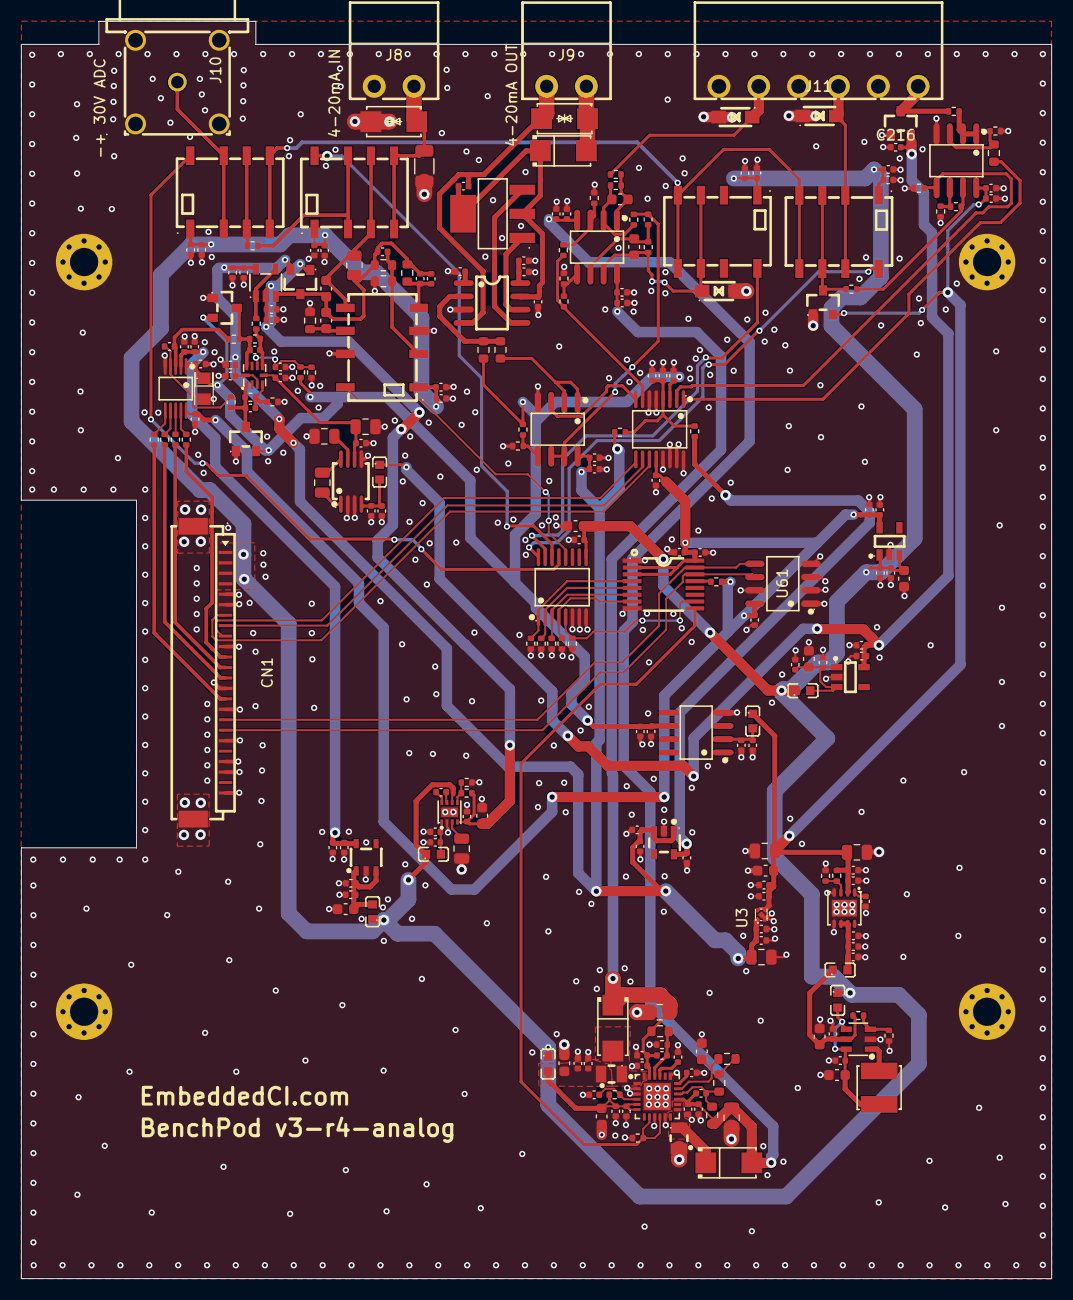
[picture p7: board pcb/benchpod-analog/vbench-pod.kicad_pcb from above]

Board: 4 copper layers, 98.5 x 120.2 mm, 247 parts (0 on the bottom side), 115 nets.
