embeddedci-com/benchpod/pcb/benchpod-digital/vbench-pod.kicad_pcb

## KiCad design pcb/benchpod-digital/vbench-pod.kicad_pcb (2026-11-06)

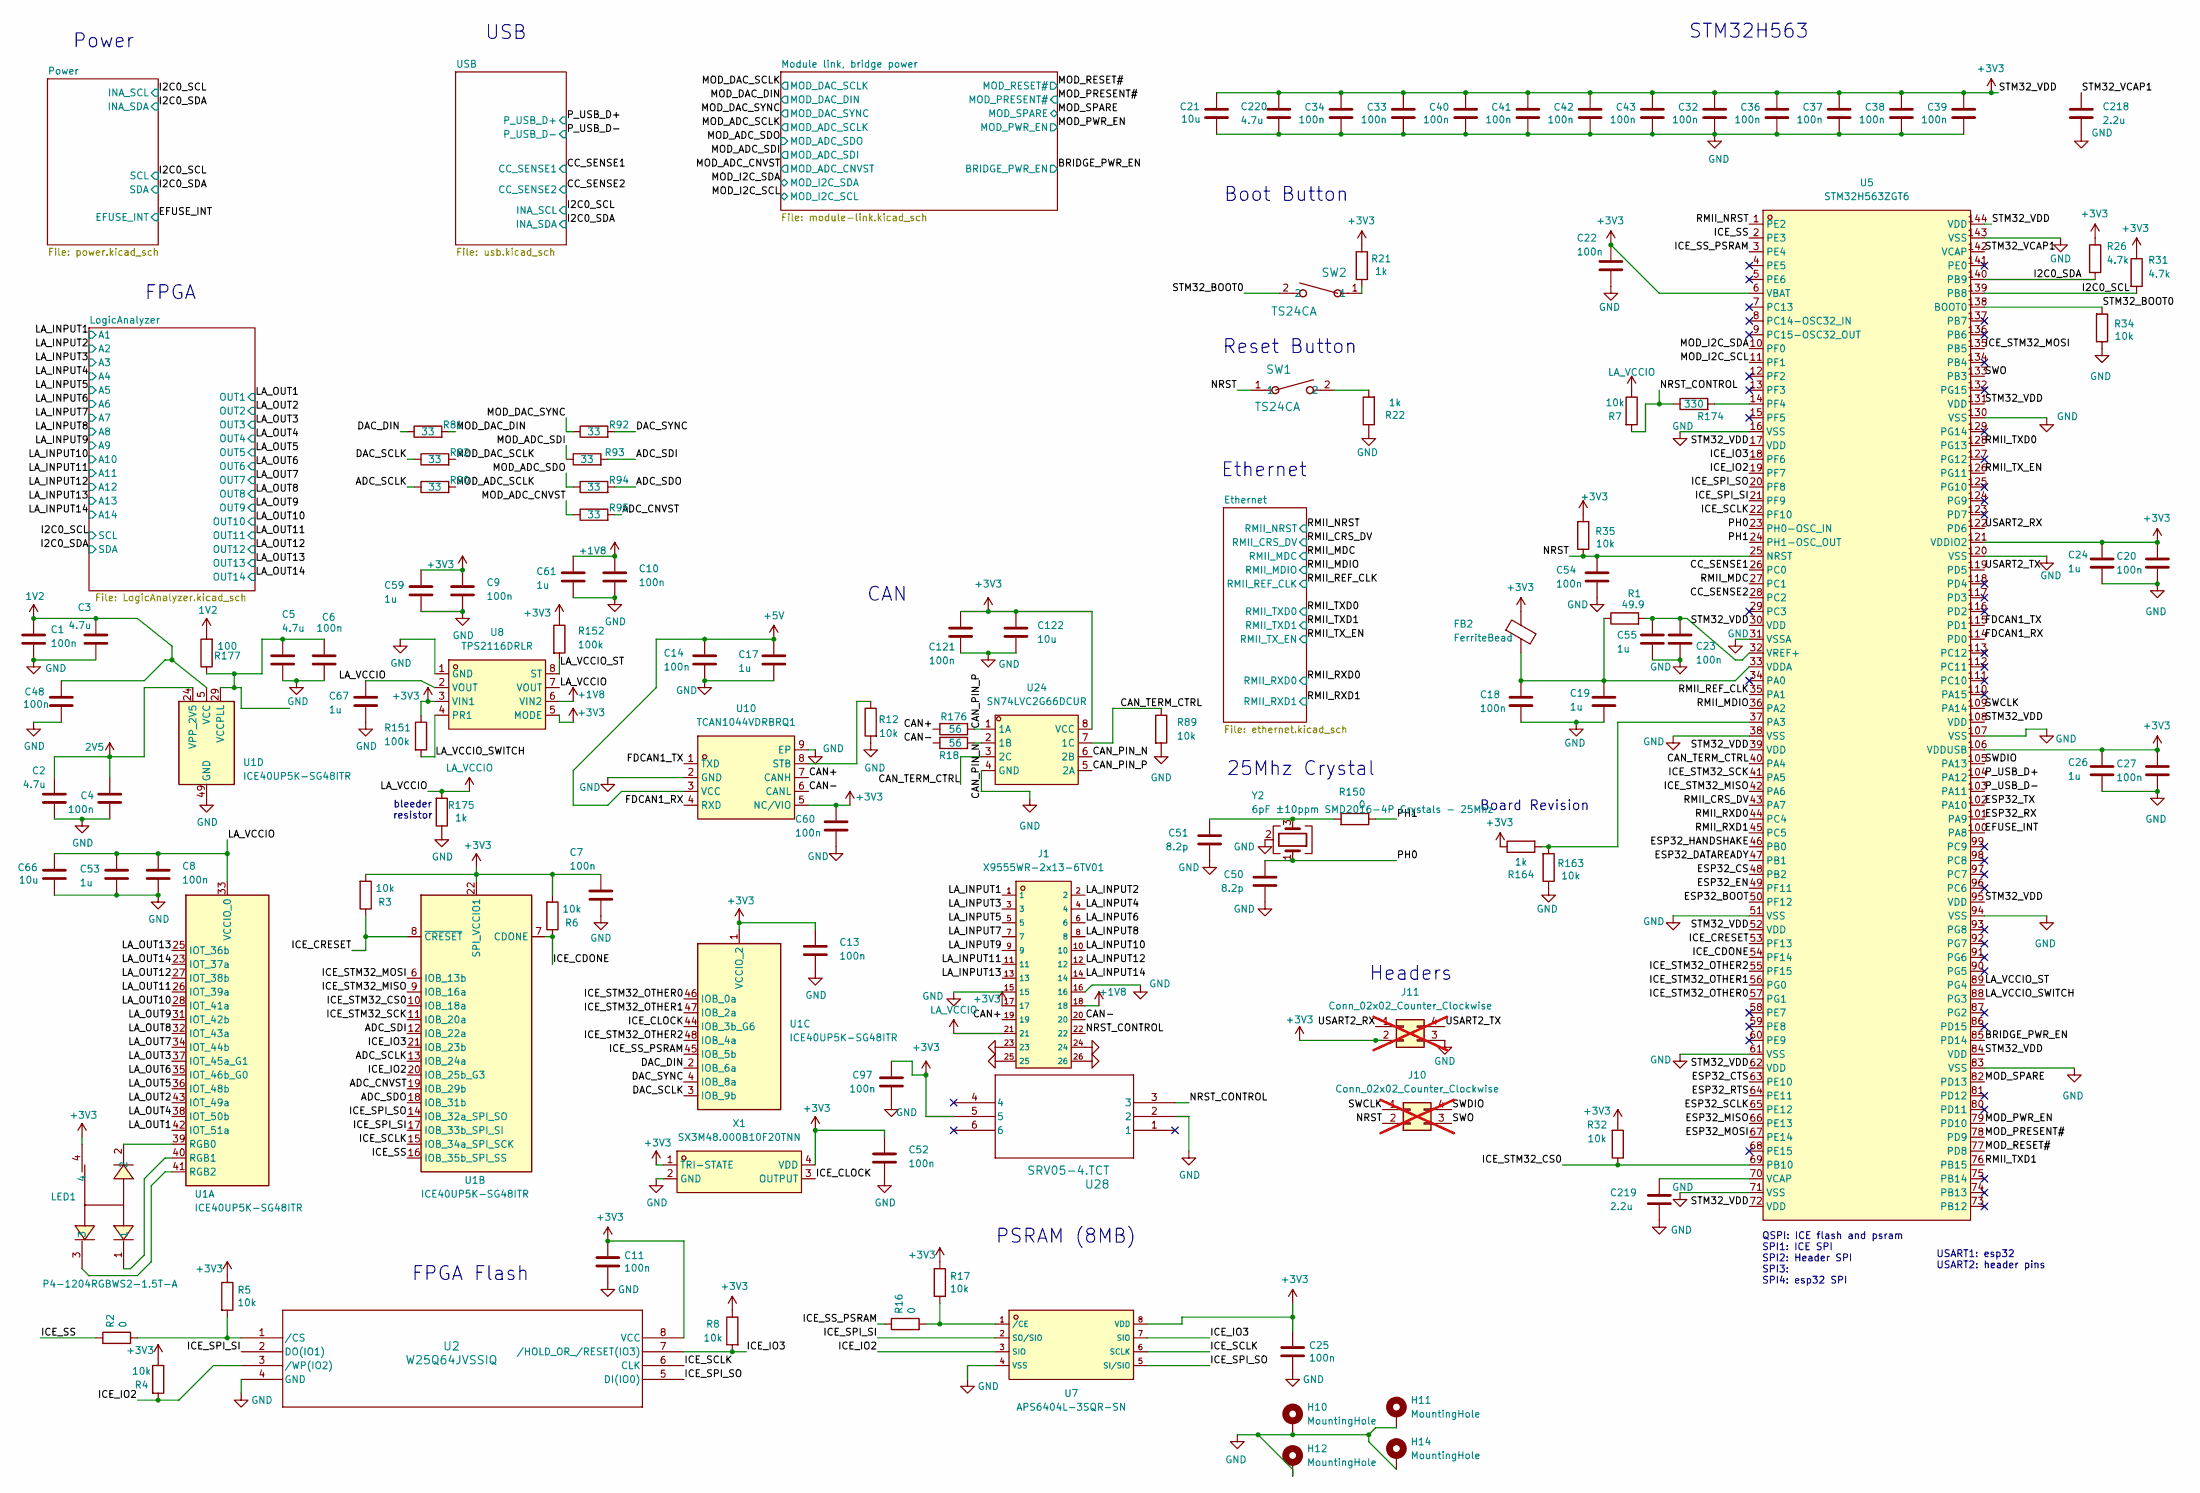
[picture p8: schematic vbench-pod.kicad_sch]

Parts:
C1, C4, C6, C7, C8, C9, C10, C13, C14, C18, C20, C22, C23, C27, C48, C52, C54, C60: 100n; C_0402_1005Metric; MPN CC0603KRX7R9BB104; LCSC C307331
C2, C3, C5, C220: 4.7u; C_0805_2012Metric; LCSC C98192
C11, C25, C32, C33, C34, C36, C37, C38, C39, C40, C41, C42, C43, C97, C121: 100n; C_0402_1005Metric; LCSC C307331
C17, C24, C26, C53, C59, C67: 1u; C_0402_1005Metric; MPN CL05A105KA5NQNC; LCSC C52923
C19, C55, C61: 1u; C_0402_1005Metric; MPN GRM155R61H105KE05D; LCSC C1518208
C21, C66, C122: 10u; C_0603_1608Metric; LCSC C96446
C50, C51: 8.2p; C_0402_1005Metric; LCSC C1579
C218, C219: 2.2u; C_0603_1608Metric; LCSC C415535
FB2: FerriteBead; C85833_L0603; LCSC C85833
H10, H11, H12, H14: MountingHole; MountingHole_2.7mm_M2.5_Pad_Via
J1: X9555WR-2x13-6TV01; C2682221_CONN-TH_X9555WR-2X13-6TV01; LCSC C2682221
J10, J11: Conn_02x02_Counter_Clockwise; PinSocket_2x02_P2.54mm_Vertical; not fitted
LED1: P4-1204RGBWS2-1.5T-A; C2827295_LED-SMD_4P-L3.2-W1.5_P4-1204RGBWS2-1.5T-A; MPN P4-1204RGBWS2-1.5T-A; LCSC Part C2827295
R1: 49.9; R_0402_1005Metric; LCSC C325388
R2, R16, R150: 0; R_0402_1005Metric; LCSC C17168
R3, R4, R6, R7, R8, R12, R32, R34, R35, R89, R163: 10k; R_0402_1005Metric; LCSC C25744
R5, R17: 10k; R_0402_1005Metric; JLC_DNF true
R18, R176: 56; R_0402_1005Metric; LCSC C3013179
R21, R22, R164, R175: 1k; R_0402_1005Metric; LCSC C11702
R26, R31: 4.7k; R_0402_1005Metric; LCSC C25900
R81, R82, R90, R92, R93, R94, R95: 33; R_0402_1005Metric; LCSC C25105
R151, R152: 100k; R_0402_1005Metric; LCSC C25741
R174: 330; R_0402_1005Metric; LCSC C25104
R177: 100; R_0402_1005Metric; LCSC C25076
SW1, SW2: TS24CA; C393942_SW-SMD_2P-TS24CA; LCSC C393942
U1: ICE40UP5K-SG48ITR; QFN-48_L7.0-W7.0-P0.50-TL-EP5.4-1; LCSC C2678152
U2: W25Q64JVSSIQ; SOIC-8_L5.3-W5.3-P1.27-LS8.0-BL; MPN W25Q64JVSSIQ; LCSC C179171
U5: STM32H563ZGT6; LQFP-144_L20.0-W20.0-P0.50-LS22.0-TL; LCSC Part C29271104
U7: APS6404L-3SQR-SN; C5333729_SOIC-8_L4.9-W3.9-P1.27-LS6.0-BL; LCSC C5333729
U8: TPS2116DRLR; SOT-583-8_L2.1-W1.6-P0.50-LS1.6-BL; MPN TPS2116DRLR; LCSC Part C3235557
U10: TCAN1044VDRBRQ1; VSON-8_L3.0-W3.0-P0.65-BR-EP; MPN TCAN1044VDRBRQ1; LCSC Part C5215851
U24: SN74LVC2G66DCUR; VSSOP-8_L2.1-W2.4-P0.50-LS3.2-BR; MPN SN74LVC2G66DCUR; LCSC Part C181970
U28: SRV05-4.TCT; SOT-23-6_L2.9-W1.6-P0.95-LS2.8-BR; LCSC C13612
X1: SX3M48.000B10F20TNN; OSC-SMD_4P-L3.2-W2.5-BL; MPN SX3M48.000B10F20TNN; LCSC Part C5452690
Y2: 6pF ±10ppm SMD2016-4P Crystals - 25Mhz; Crystal_SMD_2016-4Pin_2.0x1.6mm; LCSC C49867546

Connections:
1V2: C1.2, C3.1, C48.2, R177.2, U1.5 (VCC), U1.30 (VCC); also elsewhere on the board
2V5: C2.1, C4.2, U1.24 (VPP_2V5); also elsewhere on the board
+1V8: C10.2, C61.2, J1.18, U8.6 (VIN2); also elsewhere on the board
+3V3: C7.2, C9.2, C11.1, C13.2, C20.2, C21.1, C22.2, C24.2, C25.1, C26.2, C27.2, C32.1, C33.1, C34.1, C36.1, C37.1, C38.1, C39.1, C40.1, C41.1, C42.1, C43.1, C52.2, C59.2, C60.2, C97.2, C121.1, C122.2, C220.1, FB2.1, J1.17, J11.2, LED1.4, R3.2, R4.1, R5.1, R6.2, R8.1, R17.1, R21.2, R26.1, R31.1, R32.2, R35.2, R151.1, R152.1, R164.1, U1.1 (VCCIO_2), U1.22 (SPI_VCCIO1), U2.8 (VCC), U5.6 (VBAT), U5.17 (VDD), U5.30 (VDD), U5.39 (VDD), U5.52 (VDD), U5.62 (VDD), U5.72 (VDD), U5.84 (VDD), U5.95 (VDD), U5.106 (VDDUSB), U5.108 (VDD), U5.121 (VDDIO2), U5.131 (VDD), U5.144 (VDD), U7.8 (VDD), U8.3 (VIN1), U8.5 (MODE), U10.5 (NC/VIO), U24.8 (VCC), U28.5, X1.1 (TRI-STATE), X1.4 (VDD); also elsewhere on the board
+5V: C14.2, C17.2, U10.3 (VCC); also elsewhere on the board
/ADC_CNVST: R95.2, U1.19 (IOB_29b)
/ADC_SCLK: R90.1, U1.13 (IOB_24a)
/ADC_SDI: R93.2, U1.12 (IOB_22a)
/ADC_SDO: R94.2, U1.18 (IOB_31b)
/BRIDGE_PWR_EN: U5.85 (PD14); also elsewhere on the board
/CAN+: J1.19, R176.1, U10.7 (CANH)
/CAN-: J1.20, R18.1, U10.6 (CANL)
/CAN_PIN_N: R18.2, U24.2 (1B), U24.6 (2B)
/CAN_PIN_P: R176.2, U24.1 (1A), U24.5 (2A)
/CAN_TERM_CTRL: R89.1, U5.40 (PA4), U24.3 (2C), U24.7 (1C)
/CC_SENSE1: U5.26 (PC0); also elsewhere on the board
/CC_SENSE2: U5.28 (PC2); also elsewhere on the board
/DAC_DIN: R81.1, U1.2 (IOB_6a)
/DAC_SCLK: R82.1, U1.3 (IOB_9b)
/DAC_SYNC: R92.2, U1.4 (IOB_8a)
/EFUSE_INT: U5.100 (PA8); also elsewhere on the board
/ESP32_BOOT: U5.50 (PF12)
/ESP32_CS: U5.48 (PB2)
/ESP32_CTS: U5.63 (PE10)
/ESP32_DATAREADY: U5.47 (PB1)
/ESP32_EN: U5.49 (PF11)
/ESP32_HANDSHAKE: U5.46 (PB0)
/ESP32_MISO: U5.66 (PE13)
/ESP32_MOSI: U5.67 (PE14)
/ESP32_RTS: U5.64 (PE11)
/ESP32_RX: U5.101 (PA9)
/ESP32_SCLK: U5.65 (PE12)
/ESP32_TX: U5.102 (PA10)
/FDCAN1_RX: U5.114 (PD0), U10.4 (RXD)
/FDCAN1_TX: U5.115 (PD1), U10.1 (TXD)
/I2C0_SCL: R31.2, U5.139 (PB8); also elsewhere on the board
/I2C0_SDA: R26.2, U5.140 (PB9); also elsewhere on the board
/ICE_CDONE: R6.1, U1.7 (CDONE), U5.54 (PF14)
/ICE_CLOCK: U1.44 (IOB_3b_G6), X1.3 (OUTPUT)
/ICE_CRESET: R3.1, U1.8 (~CRESET), U5.53 (PF13)
/ICE_IO2: R4.2, U1.20 (IOB_25b_G3), U2.3 (/WP(IO2)), U5.19 (PF7), U7.3 (SIO)
/ICE_IO3: R8.2, U1.21 (IOB_23b), U2.7 (/HOLD_OR_/RESET(IO3)), U5.18 (PF6), U7.7 (SIO)
/ICE_SCLK: U1.15 (IOB_34a_SPI_SCK), U2.6 (CLK), U5.22 (PF10), U7.6 (SCLK)
/ICE_SPI_SI: U1.17 (IOB_33b_SPI_SI), U2.2 (DO(IO1)), U5.21 (PF9), U7.2 (SO/SIO)
/ICE_SPI_SO: U1.14 (IOB_32a_SPI_SO), U2.5 (DI(IO0)), U5.20 (PF8), U7.5 (SI/SIO)
/ICE_SS: R2.1, U1.16 (IOB_35b_SPI_SS), U5.2 (PE3)
/ICE_SS_PSRAM: R16.1, U1.45 (IOB_5b), U5.3 (PE4)
/ICE_STM32_CS0: R32.1, U1.10 (IOB_18a), U5.69 (PB10)
/ICE_STM32_MISO: U1.9 (IOB_16a), U5.42 (PA6)
/ICE_STM32_MOSI: U1.6 (IOB_13b), U5.135 (PB5)
/ICE_STM32_OTHER0: U1.46 (IOB_0a), U5.57 (PG1)
/ICE_STM32_OTHER1: U1.47 (IOB_2a), U5.56 (PG0)
/ICE_STM32_OTHER2: U1.48 (IOB_4a), U5.55 (PF15)
/ICE_STM32_SCK: U1.11 (IOB_20a), U5.41 (PA5)
/LA_INPUT1: J1.1; also elsewhere on the board
/LA_INPUT2: J1.2; also elsewhere on the board
/LA_INPUT3: J1.3; also elsewhere on the board
/LA_INPUT4: J1.4; also elsewhere on the board
/LA_INPUT5: J1.5; also elsewhere on the board
/LA_INPUT6: J1.6; also elsewhere on the board
/LA_INPUT7: J1.7; also elsewhere on the board
/LA_INPUT8: J1.8; also elsewhere on the board
/LA_INPUT9: J1.9; also elsewhere on the board
/LA_INPUT10: J1.10; also elsewhere on the board
/LA_INPUT11: J1.11; also elsewhere on the board
/LA_INPUT12: J1.12; also elsewhere on the board
/LA_INPUT13: J1.13; also elsewhere on the board
/LA_INPUT14: J1.14; also elsewhere on the board
/LA_OUT1: U1.42 (IOT_51a); also elsewhere on the board
/LA_OUT2: U1.43 (IOT_49a); also elsewhere on the board
/LA_OUT3: U1.37 (IOT_45a_G1); also elsewhere on the board
/LA_OUT4: U1.38 (IOT_50b); also elsewhere on the board
/LA_OUT5: U1.36 (IOT_48b); also elsewhere on the board
/LA_OUT6: U1.35 (IOT_46b_G0); also elsewhere on the board
/LA_OUT7: U1.34 (IOT_44b); also elsewhere on the board
/LA_OUT8: U1.32 (IOT_43a); also elsewhere on the board
/LA_OUT9: U1.31 (IOT_42b); also elsewhere on the board
/LA_OUT10: U1.28 (IOT_41a); also elsewhere on the board
/LA_OUT11: U1.26 (IOT_39a); also elsewhere on the board
/LA_OUT12: U1.27 (IOT_38b); also elsewhere on the board
/LA_OUT13: U1.25 (IOT_36b); also elsewhere on the board
/LA_OUT14: U1.23 (IOT_37a); also elsewhere on the board
/LA_VCCIO_ST: R152.2, U5.89 (PG4), U8.8 (ST)
/LA_VCCIO_SWITCH: R151.2, U5.88 (PG3), U8.4 (PR1)
/MOD_ADC_CNVST: R95.1; also elsewhere on the board
/MOD_ADC_SCLK: R90.2; also elsewhere on the board
/MOD_ADC_SDI: R93.1; also elsewhere on the board
/MOD_ADC_SDO: R94.1; also elsewhere on the board
/MOD_DAC_DIN: R81.2; also elsewhere on the board
/MOD_DAC_SCLK: R82.2; also elsewhere on the board
/MOD_DAC_SYNC: R92.1; also elsewhere on the board
/MOD_I2C_SCL: U5.11 (PF1); also elsewhere on the board
/MOD_I2C_SDA: U5.10 (PF0); also elsewhere on the board
/MOD_PRESENT#: U5.78 (PD9); also elsewhere on the board
/MOD_PWR_EN: U5.79 (PD10); also elsewhere on the board
/MOD_RESET#: U5.77 (PD8); also elsewhere on the board
/MOD_SPARE: U5.82 (PD13); also elsewhere on the board
/NRST: C54.2, J10.2, R35.1, SW1.1, U5.25 (NRST)
/NRST_CONTROL: J1.22, R7.2, R174.1, U28.3
/PH0: C50.1, U5.23 (PH0-OSC_IN), Y2.1
/PH1: R150.1, U5.24 (PH1-OSC_OUT)
/P_USB_D+: U5.104 (PA12); also elsewhere on the board
/P_USB_D-: U5.103 (PA11); also elsewhere on the board
/RMII_CRS_DV: U5.43 (PA7); also elsewhere on the board
/RMII_MDC: U5.27 (PC1); also elsewhere on the board
/RMII_MDIO: U5.36 (PA2); also elsewhere on the board
/RMII_NRST: U5.1 (PE2); also elsewhere on the board
/RMII_REF_CLK: U5.35 (PA1); also elsewhere on the board
/RMII_RXD0: U5.44 (PC4); also elsewhere on the board
/RMII_RXD1: U5.45 (PC5); also elsewhere on the board
/RMII_TXD0: U5.128 (PG13); also elsewhere on the board
/RMII_TXD1: U5.76 (PB15); also elsewhere on the board
/RMII_TX_EN: U5.126 (PG11); also elsewhere on the board
/STM32_BOOT0: R34.2, SW2.2, U5.138 (BOOT0)
/STM32_VCAP1: C218.1, U5.142 (VCAP)
/SWCLK: J10.1, U5.109 (PA14)
/SWDIO: J10.4, U5.105 (PA13)
/SWO: J10.3, U5.133 (PB3)
/USART2_RX: J11.1, U5.122 (PD6)
/USART2_TX: J11.4, U5.119 (PD5)
GND: C1.1, C2.2, C3.2, C4.1, C5.1, C6.1, C7.1, C8.1, C9.1, C10.1, C11.2, C13.1, C14.1, C17.1, C18.1, C19.1, C20.1, C21.2, C22.1, C23.1, C24.1, C25.2, C26.1, C27.1, C32.2, C33.2, C34.2, C36.2, C37.2, C38.2, C39.2, C40.2, C41.2, C42.2, C43.2, C48.1, C50.2, C51.2, C52.1, C53.1, C54.1, C55.1, C59.1, C60.1, C61.1, C66.2, C67.1, C97.1, C121.2, C122.1, C218.2, C219.2, C220.2, H10.1 (1_1), H11.1 (1_1), H12.1 (1_1), H14.1 (1_1), J1.15, J1.16, J1.23, J1.24, J1.25, J1.26, J11.3, R12.2, R22.1, R34.1, R89.2, R163.1, R175.1, U1.49 (GND), U2.4 (GND), U5.16 (VSS), U5.31 (VSSA), U5.38 (VSS), U5.51 (VSS), U5.61 (VSS), U5.71 (VSS), U5.83 (VSS), U5.94 (VSS), U5.107 (VSS), U5.120 (VSS), U5.130 (VSS), U5.143 (VSS), U7.4 (VSS), U8.1 (GND), U10.2 (GND), U10.9 (EP), U24.4 (GND), U28.2, X1.2 (GND), Y2.2 (G), Y2.4 (G); also elsewhere on the board
LA_VCCIO: C8.2, C53.2, C66.1, C67.2, J1.21, R7.1, R175.2, U1.33 (VCCIO_0), U8.2 (VOUT), U8.7 (VOUT); also elsewhere on the board
unnamed: C51.1, R150.2, Y2.3
unnamed: C219.1, U5.70 (VCAP)
unnamed: R21.1, SW2.1
unnamed: R22.2, SW1.2
unnamed: LED1.2, U1.39 (RGB0)
unnamed: LED1.1, U1.40 (RGB1)
unnamed: LED1.3, U1.41 (RGB2)
unnamed: C5.2, C6.2, R177.1, U1.29 (VCCPLL)
unnamed: R2.2, R5.2, U2.1 (/CS)
unnamed: R163.2, R164.2, U5.37 (PA3)
unnamed: R174.2, U5.14 (PF4)
unnamed: C18.2, C19.2, FB2.2, R1.1, U5.33 (VDDA)
unnamed: C23.2, C55.2, R1.2, U5.32 (VREF+)
unnamed: R16.2, R17.2, U7.1 (/CE)
unnamed: R12.1, U10.8 (STB)

Notes on the sheet:
bleeder resistor
CAN
QSPI: ICE flash and psram SPI1: ICE SPI SPI2: Header SPI SPI3: SPI4: esp32 SPI
STM32H563
USB
Ethernet
25Mhz Crystal
Reset Button
FPGA Flash
FPGA
Boot Button
Headers
USART1: esp32 USART2: header pins
PSRAM (8MB)
Power
Board Revision

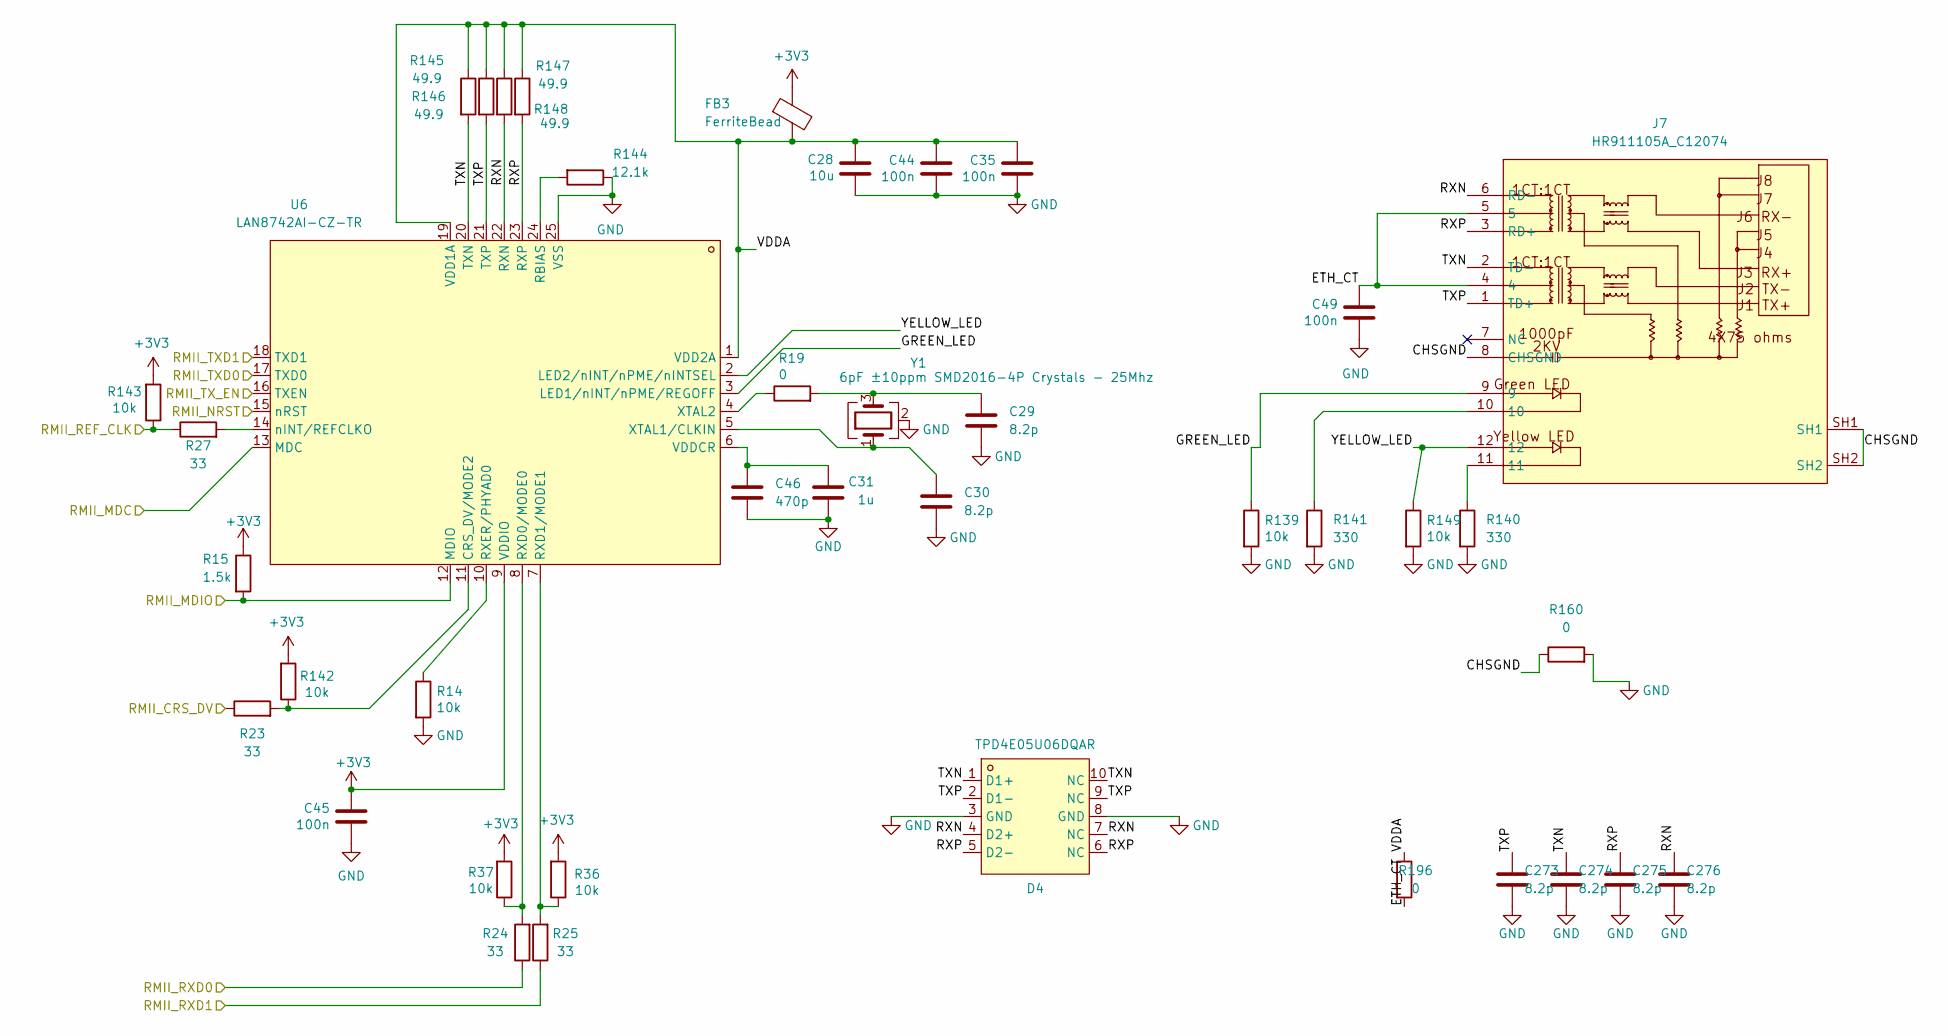
[picture p9: schematic ethernet.kicad_sch]

Parts:
C28: 10u; C_0603_1608Metric; LCSC C96446
C29, C30, C273, C274, C275, C276: 8.2p; C_0402_1005Metric; LCSC C1579
C31: 1u; C_0402_1005Metric; MPN GRM155R61H105KE05D; LCSC C1518208
C35, C44, C45, C49: 100n; C_0402_1005Metric; LCSC C307331
C46: 470p; C_0402_1005Metric; LCSC C1537
D4: TPD4E05U06DQAR; C138714_USON-10_L2.5-W1.0-P0.50-BL; LCSC C138714
FB3: FerriteBead; C85833_L0603; LCSC C85833
J7: HR911105A_C12074; RJ45-TH_HR911105A; MPN HR911105A; LCSC Part C12074
R14, R139, R149: 10k; R_0402_1005Metric; JLC_DNF true
R15: 1.5k; R_0402_1005Metric; LCSC C25867
R19, R160, R196: 0; R_0402_1005Metric; LCSC C17168
R23, R24, R25, R27: 33; R_0402_1005Metric; LCSC C25105
R36, R37, R142, R143: 10k; R_0402_1005Metric; LCSC C25744
R140, R141: 330; R_0402_1005Metric; LCSC C25104
R144: 12.1k; R_0402_1005Metric; LCSC C25852
R145, R146, R147, R148: 49.9; R_0402_1005Metric; LCSC C325388
U6: LAN8742AI-CZ-TR; VQFN-24_L4.0-W4.0-P0.50-BL-EP2.5; MPN LAN8742AI-CZ-TR; LCSC Part C621425
Y1: 6pF ±10ppm SMD2016-4P Crystals - 25Mhz; Crystal_SMD_2016-4Pin_2.0x1.6mm; LCSC C49867546

Connections:
+3V3: C45.1, FB3.1, R15.1, R36.2, R37.2, R142.2, R143.2, U6.9 (VDDIO); also elsewhere on the board
/Ethernet/CHSGND: J7.8 (CHSGND), J7.SH1, J7.SH2, R160.1
/Ethernet/ETH_CT: C49.1, J7.4, J7.5, R196.2
/Ethernet/GREEN_LED: J7.9, R139.1, U6.3 (LED1/nINT/nPME/REGOFF)
/Ethernet/RXN: C276.1, D4.4 (D2+), D4.7 (NC), J7.6 (RD-), R147.2, U6.22 (RXN)
/Ethernet/RXP: C275.1, D4.5 (D2-), D4.6 (NC), J7.3 (RD+), R148.2, U6.23 (RXP)
/Ethernet/TXN: C274.1, D4.1 (D1+), D4.10 (NC), J7.2 (TD-), R145.2, U6.20 (TXN)
/Ethernet/TXP: C273.1, D4.2 (D1-), D4.9 (NC), J7.1 (TD+), R146.2, U6.21 (TXP)
/Ethernet/VDDA: C28.1, C35.1, C44.1, FB3.2, R145.1, R146.1, R147.1, R148.1, R196.1, U6.1 (VDD2A), U6.19 (VDD1A)
/Ethernet/YELLOW_LED: J7.12, R149.1, U6.2 (LED2/nINT/nPME/nINTSEL)
/RMII_CRS_DV: R23.1; also elsewhere on the board
/RMII_MDC: U6.13 (MDC); also elsewhere on the board
/RMII_MDIO: R15.2, U6.12 (MDIO); also elsewhere on the board
/RMII_NRST: U6.15 (nRST); also elsewhere on the board
/RMII_REF_CLK: R27.1, R143.1; also elsewhere on the board
/RMII_RXD0: R24.1; also elsewhere on the board
/RMII_RXD1: R25.1; also elsewhere on the board
/RMII_TXD0: U6.17 (TXD0); also elsewhere on the board
/RMII_TXD1: U6.18 (TXD1); also elsewhere on the board
/RMII_TX_EN: U6.16 (TXEN); also elsewhere on the board
GND: C28.2, C29.2, C30.2, C31.1, C35.2, C44.2, C45.2, C46.2, C49.2, C273.2, C274.2, C275.2, C276.2, D4.3 (GND), D4.8 (GND), R14.2, R139.2, R140.2, R141.2, R144.1, R149.2, R160.2, U6.25 (VSS), Y1.2 (G), Y1.4 (G); also elsewhere on the board
unnamed: C29.1, R19.2, Y1.3
unnamed: J7.10, R141.1
unnamed: J7.11, R140.1
unnamed: R23.2, R142.1, U6.11 (CRS_DV/MODE2)
unnamed: R144.2, U6.24 (RBIAS)
unnamed: R24.2, R37.1, U6.8 (RXD0/MODE0)
unnamed: R25.2, R36.1, U6.7 (RXD1/MODE1)
unnamed: R14.1, U6.10 (RXER/PHYAD0)
unnamed: C31.2, C46.1, U6.6 (VDDCR)
unnamed: C30.1, U6.5 (XTAL1/CLKIN), Y1.1
unnamed: R19.1, U6.4 (XTAL2)
unnamed: R27.2, U6.14 (nINT/REFCLKO)
