embeddedci-com/benchpod/pcb/benchpod-digital/vbench-pod.kicad_pcb

## KiCad design pcb/benchpod-digital/vbench-pod.kicad_pcb (continued)

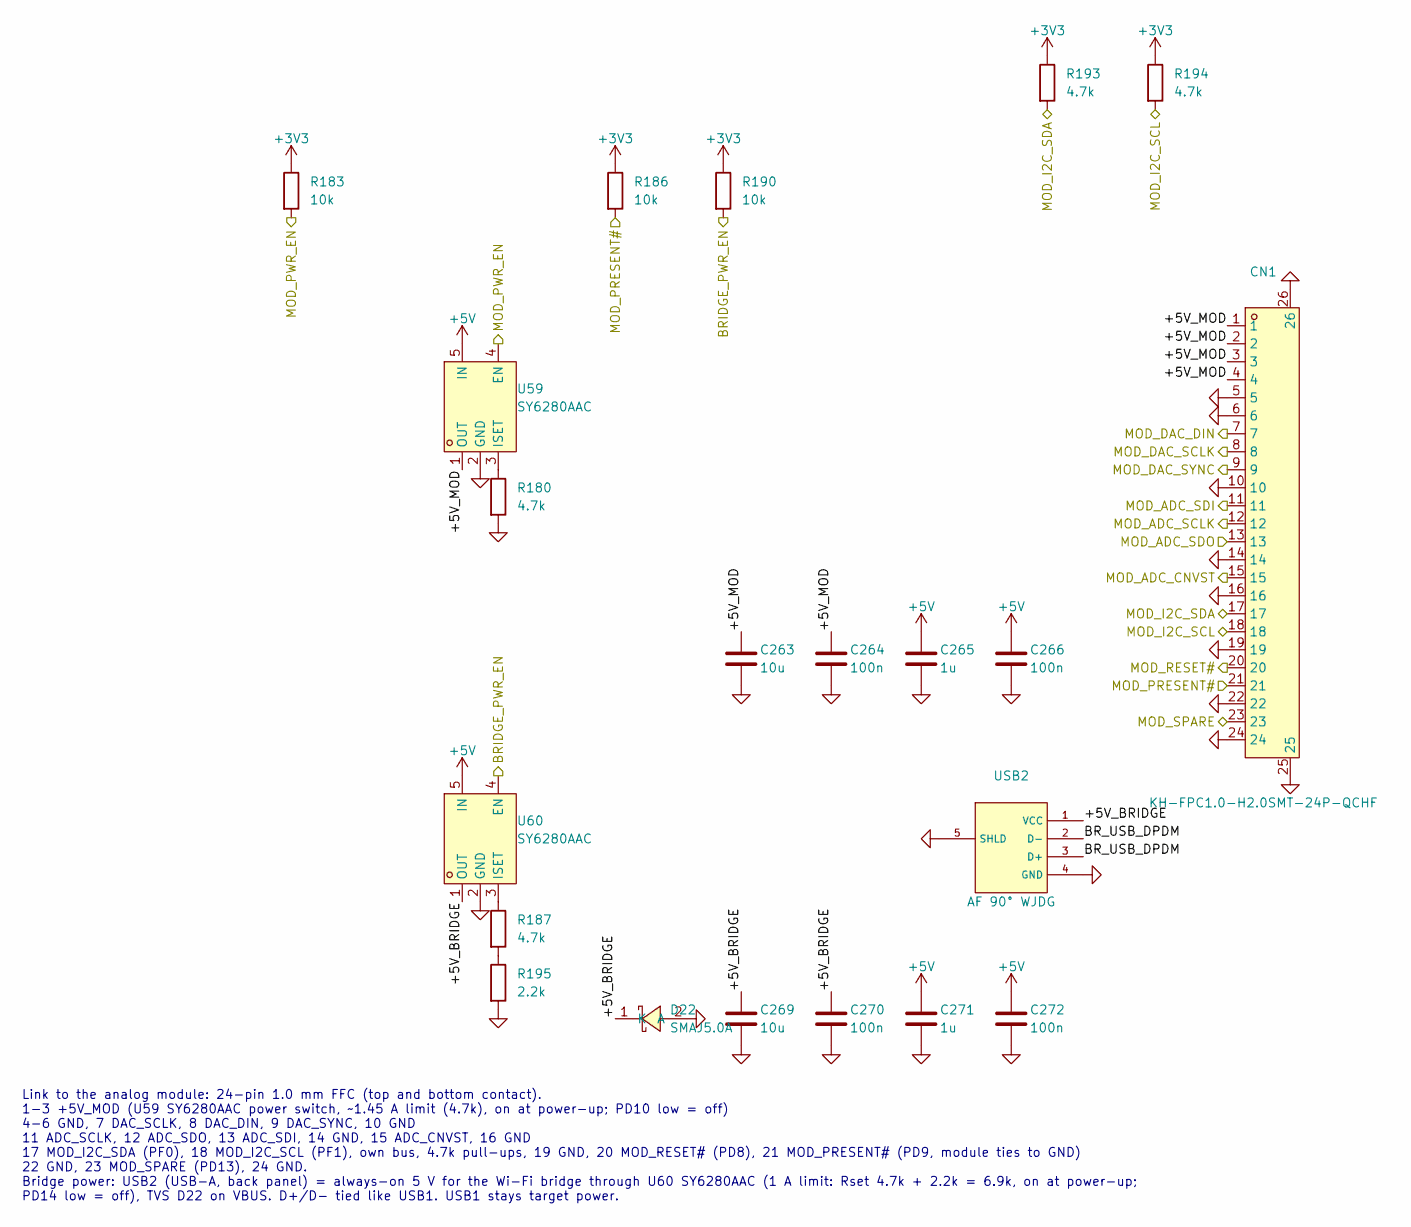
[picture p10: schematic module-link.kicad_sch]

Parts:
C263, C269: 10u; C_0603_1608Metric; LCSC C96446
C264, C266, C270, C272: 100n; C_0402_1005Metric; MPN CC0603KRX7R9BB104; LCSC C307331
C265, C271: 1u; C_0402_1005Metric; MPN CL05A105KA5NQNC; LCSC C52923
CN1: KH-FPC1.0-H2.0SMT-24P-QCHF; C5123103_FPC-SMD_24P-P1.00_KH-FPC1.0-H2.0SMT-24P-QCHF; LCSC C5123103
D22: SMAJ5.0A; SMA_L4.3-W2.6-LS5.0-RD; MPN SMAJ5.0A; LCSC Part C2925443
R180, R187, R193, R194: 4.7k; R_0402_1005Metric; LCSC C25900
R183, R186, R190: 10k; R_0402_1005Metric; LCSC C25744
R195: 2.2k; R_0402_1005Metric; LCSC C25879
U59, U60: SY6280AAC; C55136_SOT-23-5_L3.0-W1.7-P0.95-LS2.8-BL; LCSC C55136
USB2: AF 90° WJDG; C456018_USB-A-TH_AF-WJDG; LCSC C456018

Connections:
+3V3: R183.1, R186.1, R190.1, R193.1, R194.1; also elsewhere on the board
+5V: C265.1, C266.1, C271.1, C272.1, U59.5 (IN), U60.5 (IN); also elsewhere on the board
/BRIDGE_PWR_EN: R190.2, U60.4 (EN); also elsewhere on the board
/MOD_ADC_CNVST: CN1.15; also elsewhere on the board
/MOD_ADC_SCLK: CN1.12; also elsewhere on the board
/MOD_ADC_SDI: CN1.11; also elsewhere on the board
/MOD_ADC_SDO: CN1.13; also elsewhere on the board
/MOD_DAC_DIN: CN1.7; also elsewhere on the board
/MOD_DAC_SCLK: CN1.8; also elsewhere on the board
/MOD_DAC_SYNC: CN1.9; also elsewhere on the board
/MOD_I2C_SCL: CN1.18, R194.2; also elsewhere on the board
/MOD_I2C_SDA: CN1.17, R193.2; also elsewhere on the board
/MOD_PRESENT#: CN1.21, R186.2; also elsewhere on the board
/MOD_PWR_EN: R183.2, U59.4 (EN); also elsewhere on the board
/MOD_RESET#: CN1.20; also elsewhere on the board
/MOD_SPARE: CN1.23; also elsewhere on the board
/Module link, bridge power/+5V_BRIDGE: C269.1, C270.1, D22.1 (K), U60.1 (OUT), USB2.1 (VCC)
/Module link, bridge power/+5V_MOD: C263.1, C264.1, CN1.1, CN1.2, CN1.3, CN1.4, U59.1 (OUT)
/Module link, bridge power/BR_USB_DPDM: USB2.2 (D-), USB2.3 (D+)
GND: C263.2, C264.2, C265.2, C266.2, C269.2, C270.2, C271.2, C272.2, CN1.5, CN1.6, CN1.10, CN1.14, CN1.16, CN1.19, CN1.22, CN1.24, CN1.25, CN1.26, D22.2 (A), R180.2, R195.2, U59.2 (GND), U60.2 (GND), USB2.4 (GND), USB2.5 (SHLD); also elsewhere on the board
unnamed: R187.2, R195.1
unnamed: R180.1, U59.3 (ISET)
unnamed: R187.1, U60.3 (ISET)

Notes on the sheet:
Link to the analog module: 24-pin 1.0 mm FFC (top and bottom contact). 1-3 +5V_MOD (U59 SY6280AAC power switch, ~1.45 A limit (4.7k), on at power-up; PD10 low = off) 4-6 GND, 7 DAC_SCLK, 8 DAC_DIN, 9 DAC_SYNC, 10 GND 11 ADC_SCLK, 12 ADC_SDO, 13 ADC_SDI, 14 GND, 15 ADC_CNVST, 16 GND 17 MOD_I2C_SDA (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

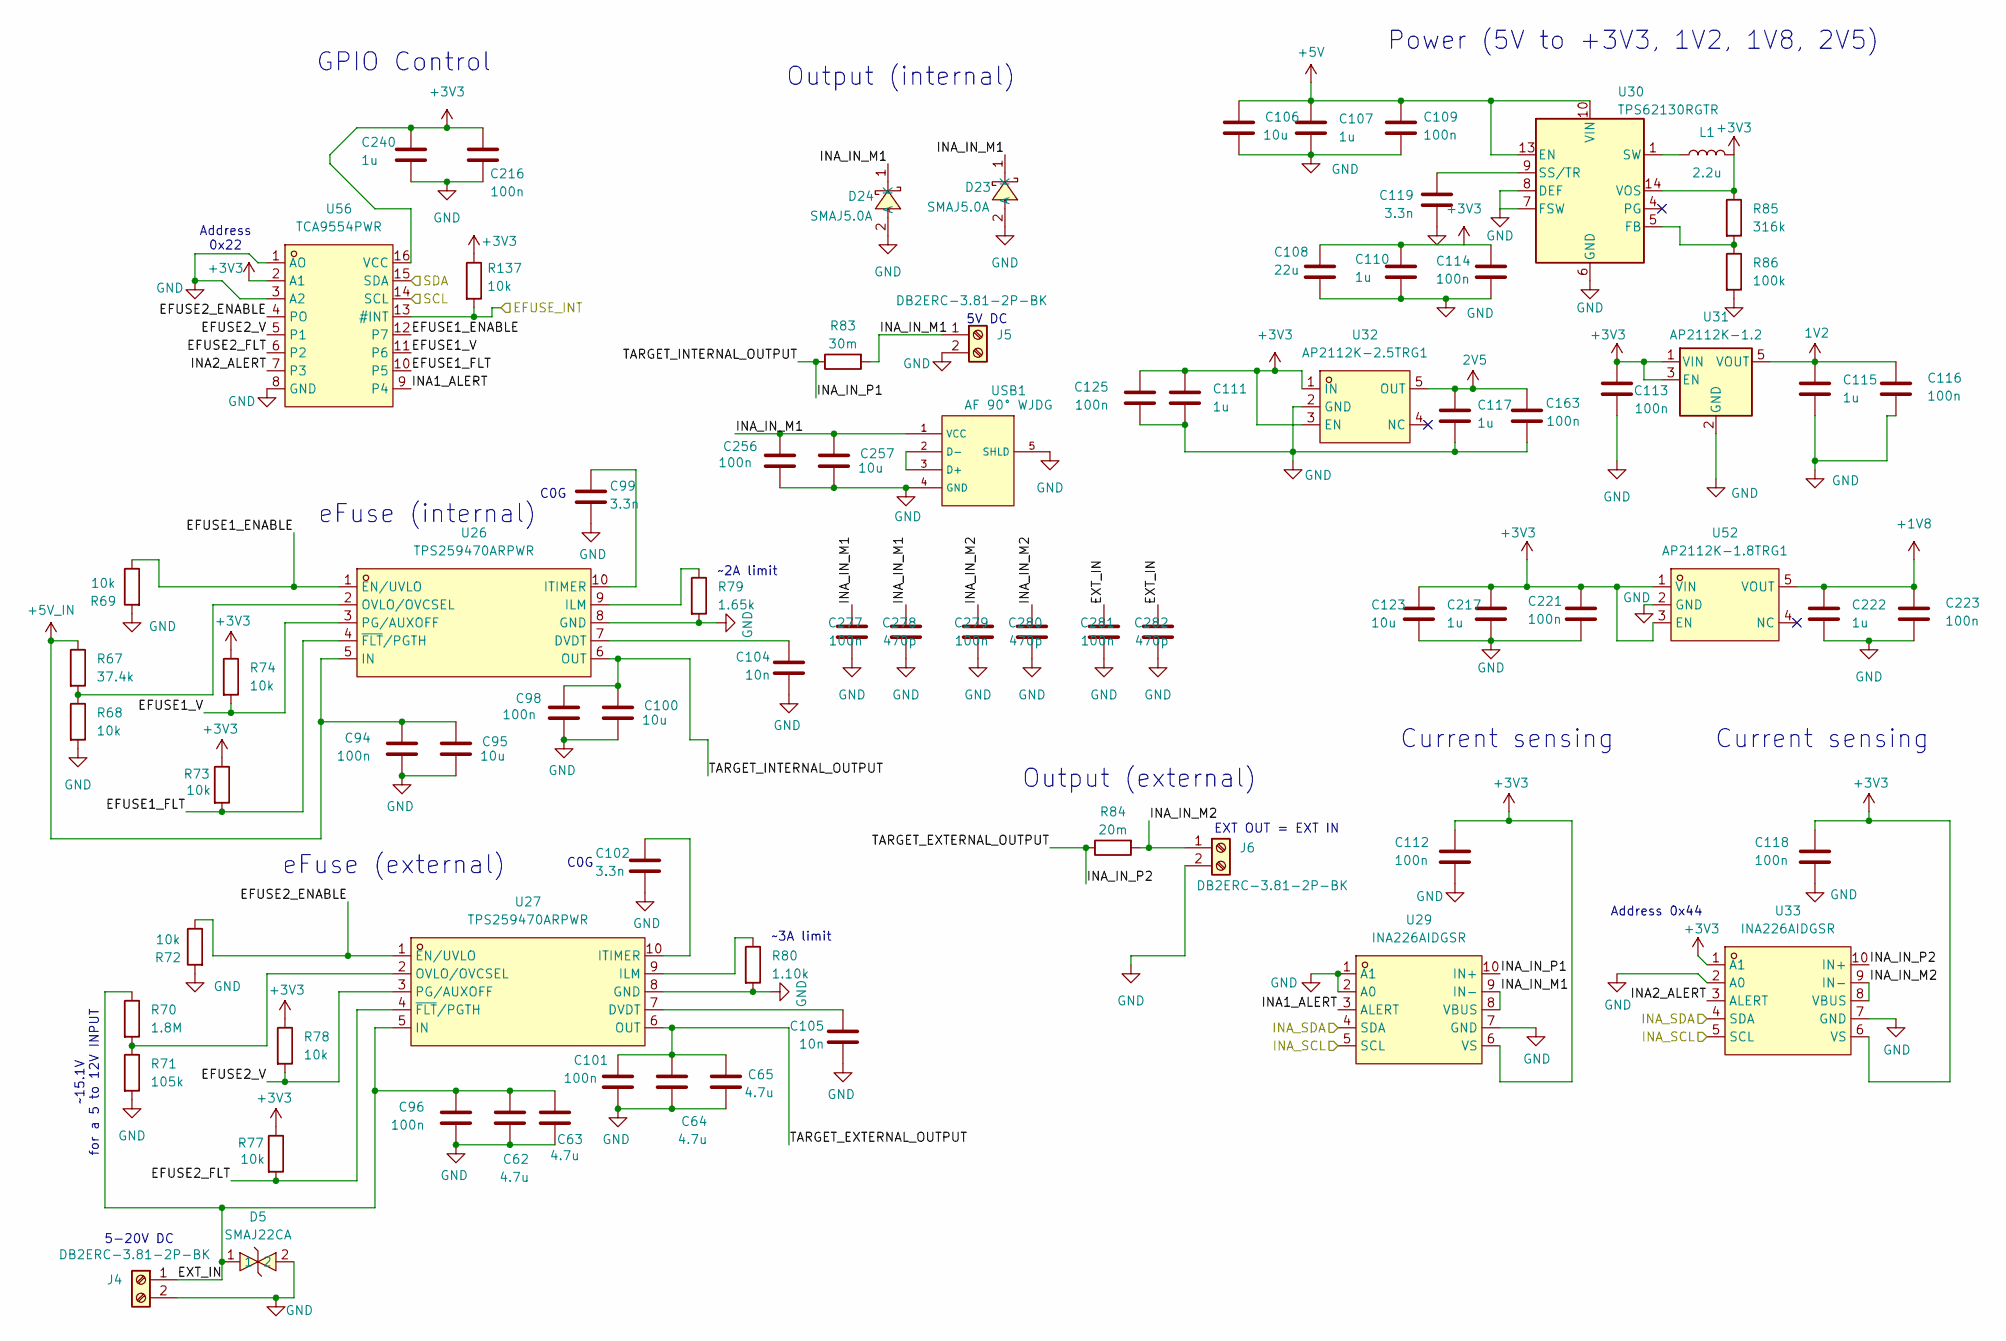
[picture p11: schematic power.kicad_sch]

Parts:
C62, C63, C64, C65: 4.7u; C_0805_2012Metric; LCSC C98192
C94, C96, C98, C101, C109, C112, C113, C114, C116, C118, C125, C163, C221, C223, C256, C277, C279, C281: 100n; C_0402_1005Metric; MPN CC0603KRX7R9BB104; LCSC C307331
C95, C100, C106, C257: 10u; C_0603_1608Metric; LCSC C96446
C99, C102, C119: 3.3n; C_0402_1005Metric; LCSC C26404
C104, C105: 10n; C_0402_1005Metric; LCSC C15195
C107, C110, C111, C115, C117, C217, C240: 1u; C_0402_1005Metric; MPN CL05A105KA5NQNC; LCSC C52923
C108: 22u; C_0805_2012Metric; MPN CL21B105KBFNNNE; LCSC C45783
C123: 10u; C_0603_1608Metric; MPN GRM21BR61H106KE43L; LCSC C96446
C216: 100n; C_0402_1005Metric; LCSC C307331
C222: 1u; C_0402_1005Metric; MPN GRM155R61H105KE05D; LCSC C1518208
C278, C280, C282: 470p; C_0402_1005Metric; MPN CC0603KRX7R9BB104; LCSC C1537
D5: SMAJ22CA; C41376408_SMA_L4_3-W2_6-LS5_2-RD; MPN SMAJ22CA; LCSC C5353129
D23, D24: SMAJ5.0A; SMA_L4.3-W2.6-LS5.0-RD; MPN SMAJ5.0A; LCSC Part C2925443
J4, J5, J6: DB2ERC-3.81-2P-BK; C5259145_CONN-TH_2P-P3.81_DB2ERC-3.81-2P-BK; MFR. Part # DB2ERC-3.81-2P-BK; LCSC Part # C5259145
L1: 2.2u; C167869_IND-SMD_L4.0-W4.0_FNR40XXS; LCSC C167869
R67: 37.4k; R_0402_1005Metric; LCSC C185422
R68, R69, R72, R73, R74, R77, R78, R137: 10k; R_0402_1005Metric; LCSC C25744
R70: 1.8M; R_0402_1005Metric; LCSC C38587
R71: 105k; R_0402_1005Metric; LCSC C25742
R79: 1.65k; R_0402_1005Metric; LCSC C25869
R80: 1.10k; R_0402_1005Metric; LCSC C25860
R83: 30m; R_2512_6332Metric; LCSC C2941066
R84: 20m; R_2512_6332Metric; LCSC C915979
R85: 316k; R_0402_1005Metric; LCSC C25777
R86: 100k; R_0402_1005Metric; LCSC C25741
U26, U27: TPS259470ARPWR; VQFN-10_L2.0-W2.0-P0.45-TL; MPN TPS259470ARPWR; LCSC Part C3662799
U29, U33: INA226AIDGSR; VSSOP-10_L3.0-W3.0-P0.50-LS4.9-BL; LCSC Part C49851
U30: TPS62130RGTR; C337502_VQFN-16_L3_0-W3_0-P0_50-BL-EP1_7; LCSC C43590
U31: AP2112K-1.2; SOT-25_L3.0-W1.6-P0.95-LS2.8-BR; LCSC C460310
U32: AP2112K-2.5TRG1; SOT-25-5; MPN AP2112K-2.5TRG1; LCSC Part C176945
U52: AP2112K-1.8TRG1; SOT-25_L3.0-W1.6-P0.95-LS2.8-BL; MPN AP2112K-1.8TRG1; LCSC Part C176944
U56: TCA9554PWR; TSSOP-16_L5.0-W4.4-P0.65-LS6.4-TL; MPN TCA9554PWR; LCSC Part C477924
USB1: AF 90° WJDG; C456018_USB-A-TH_AF-WJDG; LCSC C456018

Connections:
1V2: C115.2, C116.2, U31.5 (VOUT); also elsewhere on the board
2V5: C117.2, C163.2, U32.5 (OUT); also elsewhere on the board
+1V8: C222.2, C223.2, U52.5 (VOUT); also elsewhere on the board
+3V3: C108.2, C110.2, C111.2, C112.2, C113.2, C114.2, C118.2, C123.2, C125.2, C216.1, C217.2, C221.2, C240.2, L1.2, R73.1, R74.1, R77.1, R78.1, R85.1, R137.1, U29.6 (VS), U30.14 (VOS), U31.1 (VIN), U31.3 (EN), U32.1 (IN), U32.3 (EN), U33.1 (A1), U33.6 (VS), U52.1 (VIN), U52.3 (EN), U56.2 (A1), U56.16 (VCC); also elsewhere on the board
+5V: C106.2, C107.2, C109.2, U30.10 (VIN), U30.11 (VIN), U30.12 (VIN), U30.13 (EN); also elsewhere on the board
+5V_IN: C94.2, C95.1, R67.1, U26.5 (IN); also elsewhere on the board
/EFUSE_INT: R137.2, U56.13 (#INT); also elsewhere on the board
/I2C0_SCL: U29.5 (SCL), U33.5 (SCL), U56.14 (SCL); also elsewhere on the board
/I2C0_SDA: U29.4 (SDA), U33.4 (SDA), U56.15 (SDA); also elsewhere on the board
/Power/EFUSE1_ENABLE: R69.1, U26.1 (EN/UVLO), U56.12 (P7)
/Power/EFUSE1_FLT: R73.2, U26.4 (~FLT/PGTH), U56.10 (P5)
/Power/EFUSE1_V: R74.2, U26.3 (PG/AUXOFF), U56.11 (P6)
/Power/EFUSE2_ENABLE: R72.1, U27.1 (EN/UVLO), U56.4 (PO)
/Power/EFUSE2_FLT: R77.2, U27.4 (~FLT/PGTH), U56.6 (P2)
/Power/EFUSE2_V: R78.2, U27.3 (PG/AUXOFF), U56.5 (P1)
/Power/EXT_IN: C62.1, C63.1, C96.2, C281.1, C282.1, D5.1, J4.1, R70.1, U27.5 (IN)
/Power/INA1_ALERT: U29.3 (ALERT), U56.9 (P4)
/Power/INA2_ALERT: U33.3 (ALERT), U56.7 (P3)
/Power/INA_IN_M1: C256.2, C257.1, C277.1, C278.1, D23.1 (K), D24.1 (K), J5.1, R83.2, U29.8 (VBUS), U29.9 (IN-), USB1.1 (VCC)
/Power/INA_IN_M2: C279.1, C280.1, J6.1, R84.2, U33.8 (VBUS), U33.9 (IN-)
/Power/INA_IN_P1: C98.2, C100.1, R83.1, U26.6 (OUT), U29.10 (IN+)
/Power/INA_IN_P2: C64.1, C65.1, C101.2, R84.1, U27.6 (OUT), U33.10 (IN+)
GND: C62.2, C63.2, C64.2, C65.2, C94.1, C95.2, C96.1, C98.1, C99.2, C100.2, C101.1, C102.2, C104.2, C105.2, C106.1, C107.1, C108.1, C109.1, C110.1, C111.1, C112.1, C113.1, C114.1, C115.1, C116.1, C117.1, C118.1, C119.2, C123.1, C125.1, C163.1, C216.2, C217.1, C221.1, C222.1, C223.1, C240.1, C256.1, C257.2, C277.2, C278.2, C279.2, C280.2, C281.2, C282.2, D5.2, D23.2 (A), D24.2 (A), J4.2, J5.2, J6.2, R68.2, R69.2, R71.2, R72.2, R79.2, R80.2, R86.2, U26.8 (GND), U27.8 (GND), U29.1 (A1), U29.2 (A0), U29.7 (GND), U30.6 (GND), U30.7 (FSW), U30.8 (DEF), U30.15 (GND), U30.16 (GND), U30.17 (GND), U31.2 (GND), U32.2 (GND), U33.2 (A0), U33.7 (GND), U52.2 (GND), U56.1 (AO), U56.3 (A2), U56.8 (GND), USB1.4 (GND), USB1.5 (SHLD); also elsewhere on the board
unnamed: L1.1, U30.1 (SW), U30.2 (SW), U30.3 (SW)
unnamed: C104.1, U26.7 (DVDT)
unnamed: R79.1, U26.9 (ILM)
unnamed: C99.1, U26.10 (ITIMER)
unnamed: R67.2, R68.1, U26.2 (OVLO/OVCSEL)
unnamed: C105.1, U27.7 (DVDT)
unnamed: R80.1, U27.9 (ILM)
unnamed: C102.1, U27.10 (ITIMER)
unnamed: R70.2, R71.1, U27.2 (OVLO/OVCSEL)
unnamed: R85.2, R86.1, U30.5 (FB)
unnamed: C119.1, U30.9 (SS/TR)
unnamed: USB1.2 (D-), USB1.3 (D+)

Notes on the sheet:
GPIO Control
C0G
Output (internal)
~3A limit
eFuse (external)
Current sensing
5-20V DC
5V DC
~2A limit
EXT OUT = EXT IN
Address 0x44
Power (5V to +3V3, 1V2, 1V8, 2V5)
Output (external)
~15.1V for a 5 to 12V INPUT
Address 0x22
eFuse (internal)

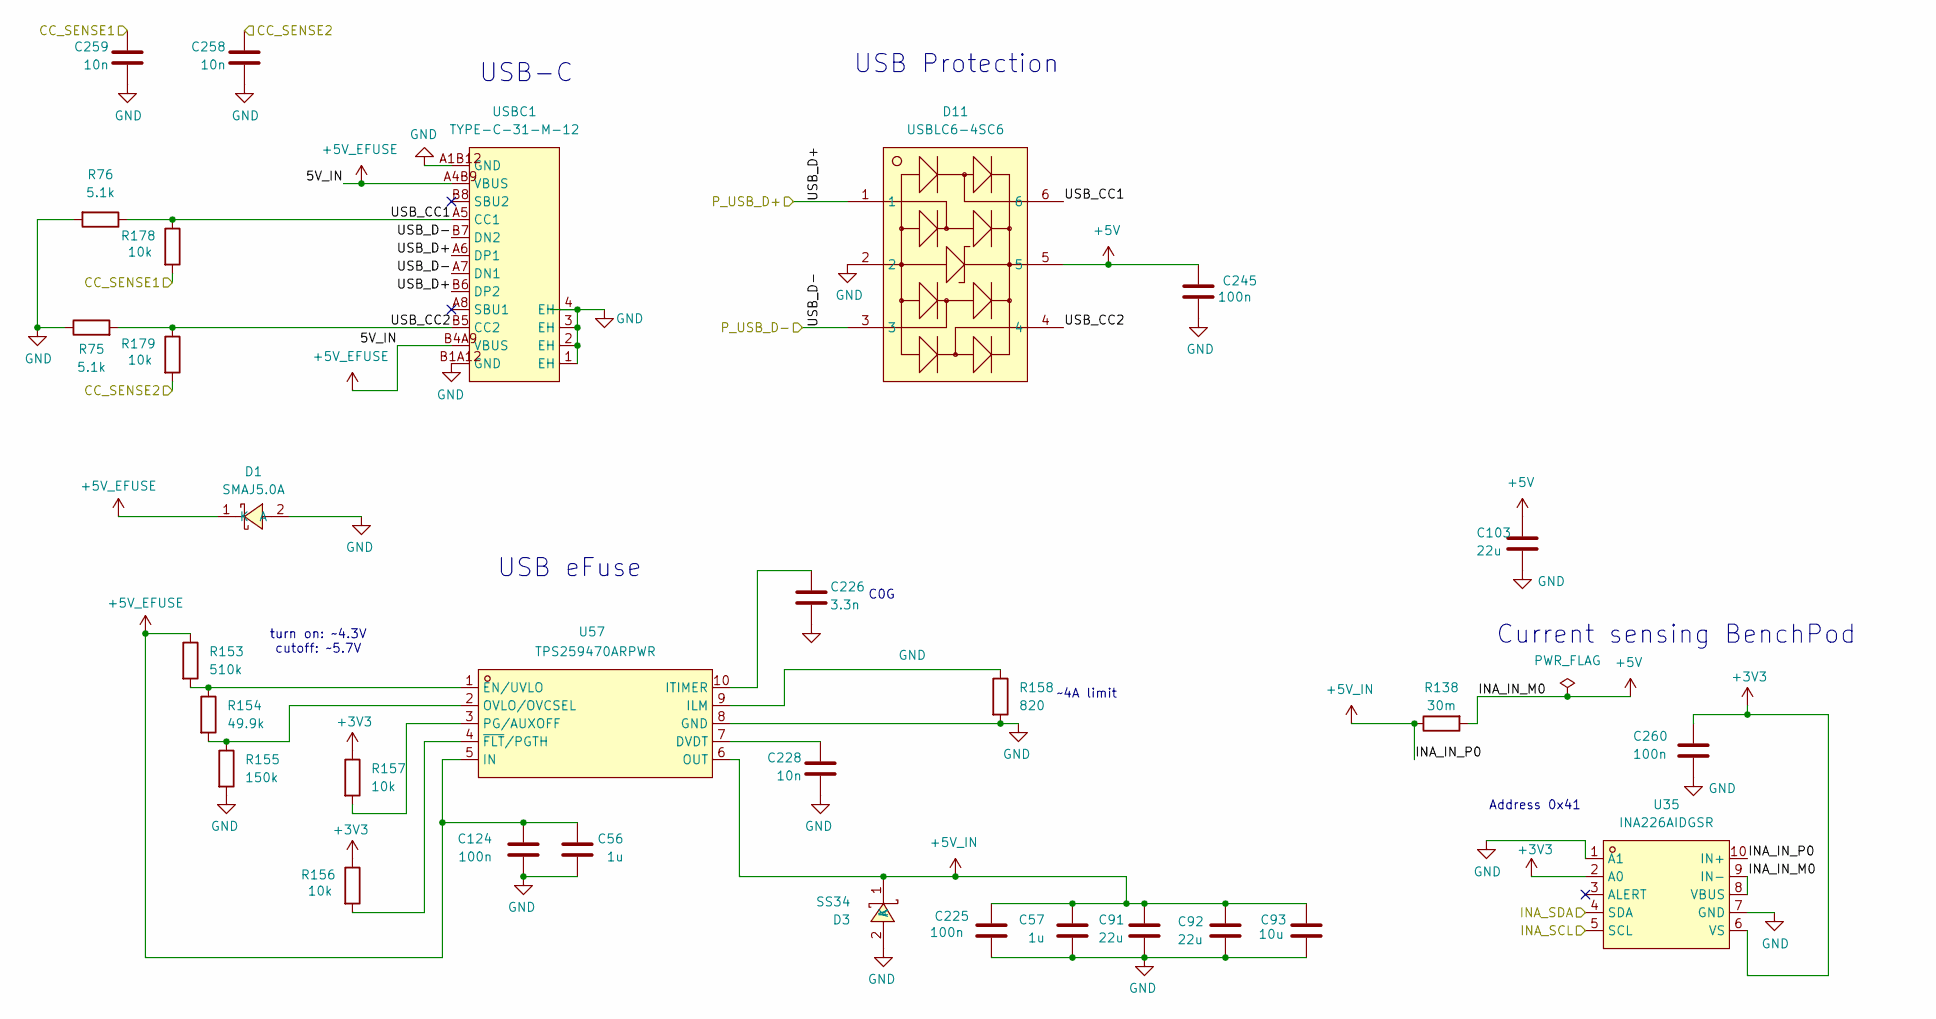
[picture p12: schematic usb.kicad_sch]

Parts:
C56: 1u; C_0402_1005Metric; MPN GRM155R61H105KE05D; LCSC C1518208
C57: 1u; C_0402_1005Metric; MPN CL05A105KA5NQNC; LCSC C52923
C91, C92, C103: 22u; C_0805_2012Metric; LCSC C45783
C93: 10u; C_0603_1608Metric; LCSC C96446
C124, C225, C245, C260: 100n; C_0402_1005Metric; MPN CC0603KRX7R9BB104; LCSC C307331
C226: 3.3n; C_0402_1005Metric; LCSC C26404
C228, C258, C259: 10n; C_0402_1005Metric; LCSC C15195
D1: SMAJ5.0A; SMA_L4.3-W2.6-LS5.0-RD; MPN SMAJ5.0A; LCSC Part C2925443
D3: SS34; SMA_L4.3-W2.6-LS5.2-RD; MPN SS34; LCSC Part C3014011
D11: USBLC6-4SC6; SOT-23-6_L2.9-W1.6-P0.95-LS2.8-BL; MPN USBLC6-4SC6; LCSC C111212
R75, R76: 5.1k; R_0402_1005Metric; LCSC C25905
R138: 30m; R_2512_6332Metric; LCSC C2941066
R153: 510k; R_0603_1608Metric; LCSC C23192
R154: 49.9k; R_0603_1608Metric; LCSC C23184
R155: 150k; R_0603_1608Metric; LCSC C22807
R156, R157, R178, R179: 10k; R_0402_1005Metric; LCSC C25744
R158: 820; R_0603_1608Metric; LCSC C23253
U35: INA226AIDGSR; VSSOP-10_L3.0-W3.0-P0.50-LS4.9-BL; LCSC Part C49851
U57: TPS259470ARPWR; VQFN-10_L2.0-W2.0-P0.45-TL; MPN TPS259470ARPWR; LCSC Part C3662799
USBC1: TYPE-C-31-M-12; USB-C_SMD-TYPE-C-31-M-12_1; MPN TYPE-C-31-M-12; LCSC Part C165948

Connections:
+3V3: C260.2, R156.1, R157.1, U35.2 (A0), U35.6 (VS); also elsewhere on the board
+5V: C103.1, C245.2, D11.5, R138.2, U35.8 (VBUS), U35.9 (IN-); also elsewhere on the board
+5V_EFUSE: C56.2, C124.2, D1.1 (K), R153.1, U57.5 (IN), USBC1.A4B9 (VBUS), USBC1.B4A9 (VBUS)
+5V_IN: C57.2, C91.1, C92.1, C93.1, C225.2, D3.1 (K), R138.1, U35.10 (IN+), U57.6 (OUT); also elsewhere on the board
/CC_SENSE1: C259.1, R178.2; also elsewhere on the board
/CC_SENSE2: C258.1, R179.2; also elsewhere on the board
/I2C0_SCL: U35.5 (SCL); also elsewhere on the board
/I2C0_SDA: U35.4 (SDA); also elsewhere on the board
/P_USB_D+: D11.1, USBC1.A6 (DP1), USBC1.B6 (DP2); also elsewhere on the board
/P_USB_D-: D11.3, USBC1.A7 (DN1), USBC1.B7 (DN2); also elsewhere on the board
/USB/USB_CC1: D11.6, R76.1, R178.1, USBC1.A5 (CC1)
/USB/USB_CC2: D11.4, R75.2, R179.1, USBC1.B5 (CC2)
GND: C56.1, C57.1, C91.2, C92.2, C93.2, C103.2, C124.1, C225.1, C226.2, C228.2, C245.1, C258.2, C259.2, C260.1, D1.2 (A), D3.2 (A), D11.2, R75.1, R76.2, R155.2, R158.2, U35.1 (A1), U35.7 (GND), U57.8 (GND), USBC1.1 (EH), USBC1.2 (EH), USBC1.3 (EH), USBC1.4 (EH), USBC1.A1B12 (GND), USBC1.B1A12 (GND); also elsewhere on the board
unnamed: C228.1, U57.7 (DVDT)
unnamed: R153.2, R154.1, U57.1 (EN/UVLO)
unnamed: R158.1, U57.9 (ILM)
unnamed: C226.1, U57.10 (ITIMER)
unnamed: R154.2, R155.1, U57.2 (OVLO/OVCSEL)
unnamed: R157.2, U57.3 (PG/AUXOFF)
unnamed: R156.2, U57.4 (~FLT/PGTH)

Notes on the sheet:
USB-C
Current sensing BenchPod
USB Protection
~4A limit
C0G
turn on: ~4.3V cutoff: ~5.7V
USB eFuse
Address 0x41

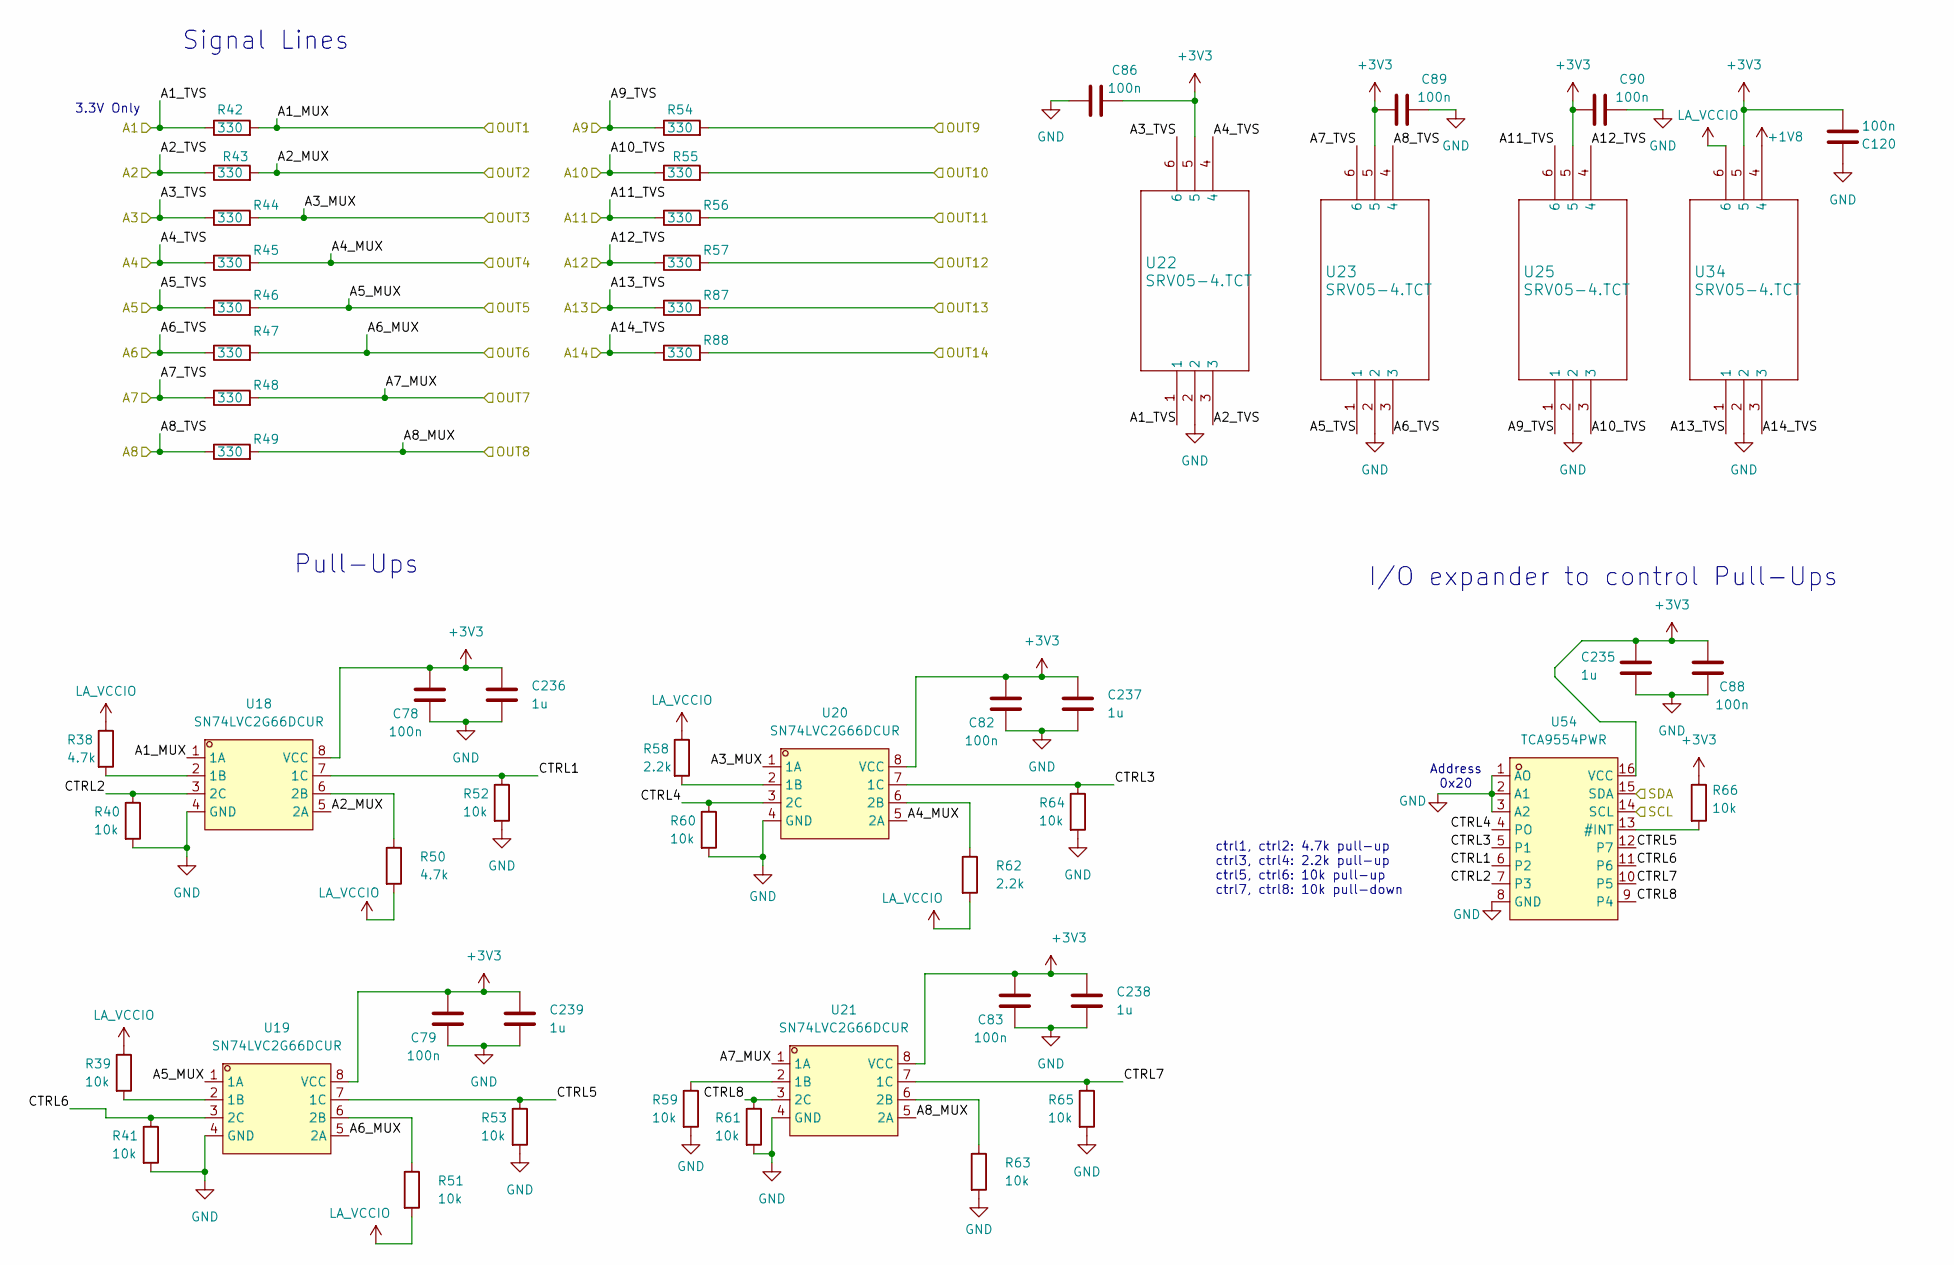
[picture p13: schematic LogicAnalyzer.kicad_sch]

Parts:
C78, C79, C82, C83, C86, C88, C89, C90, C120: 100n; C_0402_1005Metric; LCSC C307331
C235, C236, C237, C238, C239: 1u; C_0402_1005Metric; MPN CL05A105KA5NQNC; LCSC C52923
R38, R50: 4.7k; R_0402_1005Metric; LCSC C25900
R39, R40, R41, R51, R52, R53, R59, R60, R61, R63, R64, R65, R66: 10k; R_0402_1005Metric; LCSC C25744
R42, R43, R44, R45, R46, R47, R48, R49, R54, R55, R56, R57, R87, R88: 330; R_0402_1005Metric; LCSC C25104
R58, R62: 2.2k; R_0402_1005Metric; LCSC C25879
U18, U19, U20, U21: SN74LVC2G66DCUR; VSSOP-8_L2.1-W2.4-P0.50-LS3.2-BR; MPN SN74LVC2G66DCUR; LCSC Part C181970
U22, U23, U25, U34: SRV05-4.TCT; SOT-23-6_L2.9-W1.6-P0.95-LS2.8-BR; LCSC C13612
U54: TCA9554PWR; TSSOP-16_L5.0-W4.4-P0.65-LS6.4-TL; MPN TCA9554PWR; LCSC Part C477924

Connections:
+1V8: U34.4; also elsewhere on the board
+3V3: C78.1, C79.1, C82.1, C83.1, C86.2, C88.1, C89.1, C90.1, C120.1, C235.2, C236.2, C237.2, C238.2, C239.2, R66.1, U18.8 (VCC), U19.8 (VCC), U20.8 (VCC), U21.8 (VCC), U22.5, U23.5, U25.5, U34.5, U54.16 (VCC); also elsewhere on the board
/I2C0_SCL: U54.14 (SCL); also elsewhere on the board
/I2C0_SDA: U54.15 (SDA); also elsewhere on the board
/LA_INPUT1: R42.1, U22.1; also elsewhere on the board
/LA_INPUT2: R43.1, U22.3; also elsewhere on the board
/LA_INPUT3: R44.1, U22.6; also elsewhere on the board
/LA_INPUT4: R45.1, U22.4; also elsewhere on the board
/LA_INPUT5: R46.1, U23.1; also elsewhere on the board
/LA_INPUT6: R47.1, U23.3; also elsewhere on the board
/LA_INPUT7: R48.1, U23.6; also elsewhere on the board
/LA_INPUT8: R49.1, U23.4; also elsewhere on the board
/LA_INPUT9: R54.1, U25.1; also elsewhere on the board
/LA_INPUT10: R55.1, U25.3; also elsewhere on the board
/LA_INPUT11: R56.1, U25.6; also elsewhere on the board
/LA_INPUT12: R57.1, U25.4; also elsewhere on the board
/LA_INPUT13: R87.1, U34.1; also elsewhere on the board
/LA_INPUT14: R88.1, U34.3; also elsewhere on the board
/LA_OUT1: R42.2, U18.1 (1A); also elsewhere on the board
/LA_OUT2: R43.2, U18.5 (2A); also elsewhere on the board
/LA_OUT3: R44.2, U20.1 (1A); also elsewhere on the board
/LA_OUT4: R45.2, U20.5 (2A); also elsewhere on the board
/LA_OUT5: R46.2, U19.1 (1A); also elsewhere on the board
/LA_OUT6: R47.2, U19.5 (2A); also elsewhere on the board
/LA_OUT7: R48.2, U21.1 (1A); also elsewhere on the board
/LA_OUT8: R49.2, U21.5 (2A); also elsewhere on the board
/LA_OUT9: R54.2; also elsewhere on the board
/LA_OUT10: R55.2; also elsewhere on the board
/LA_OUT11: R56.2; also elsewhere on the board
/LA_OUT12: R57.2; also elsewhere on the board
/LA_OUT13: R87.2; also elsewhere on the board
/LA_OUT14: R88.2; also elsewhere on the board
/LogicAnalyzer/CTRL1: R52.1, U18.7 (1C), U54.6 (P2)
/LogicAnalyzer/CTRL2: R40.1, U18.3 (2C), U54.7 (P3)
/LogicAnalyzer/CTRL3: R64.1, U20.7 (1C), U54.5 (P1)
/LogicAnalyzer/CTRL4: R60.1, U20.3 (2C), U54.4 (PO)
/LogicAnalyzer/CTRL5: R53.1, U19.7 (1C), U54.12 (P7)
/LogicAnalyzer/CTRL6: R41.1, U19.3 (2C), U54.11 (P6)
/LogicAnalyzer/CTRL7: R65.1, U21.7 (1C), U54.10 (P5)
/LogicAnalyzer/CTRL8: R61.1, U21.3 (2C), U54.9 (P4)
GND: C78.2, C79.2, C82.2, C83.2, C86.1, C88.2, C89.2, C90.2, C120.2, C235.1, C236.1, C237.1, C238.1, C239.1, R40.2, R41.2, R52.2, R53.2, R59.2, R60.2, R61.2, R63.2, R64.2, R65.2, U18.4 (GND), U19.4 (GND), U20.4 (GND), U21.4 (GND), U22.2, U23.2, U25.2, U34.2, U54.1 (AO), U54.2 (A1), U54.3 (A2), U54.8 (GND); also elsewhere on the board
LA_VCCIO: R38.1, R39.1, R50.2, R51.2, R58.1, R62.2, U34.6; also elsewhere on the board
unnamed: R38.2, U18.2 (1B)
unnamed: R50.1, U18.6 (2B)
unnamed: R39.2, U19.2 (1B)
unnamed: R51.1, U19.6 (2B)
unnamed: R58.2, U20.2 (1B)
unnamed: R62.1, U20.6 (2B)
unnamed: R59.1, U21.2 (1B)
unnamed: R63.1, U21.6 (2B)
unnamed: R66.2, U54.13 (#INT)

Notes on the sheet:
ctrl1, ctrl2: 4.7k pull-up ctrl3, ctrl4: 2.2k pull-up ctrl5, ctrl6: 10k pull-up ctrl7, ctrl8: 10k pull-down
3.3V Only
I/O expander to control Pull-Ups
Signal Lines
Pull-Ups
Address 0x20

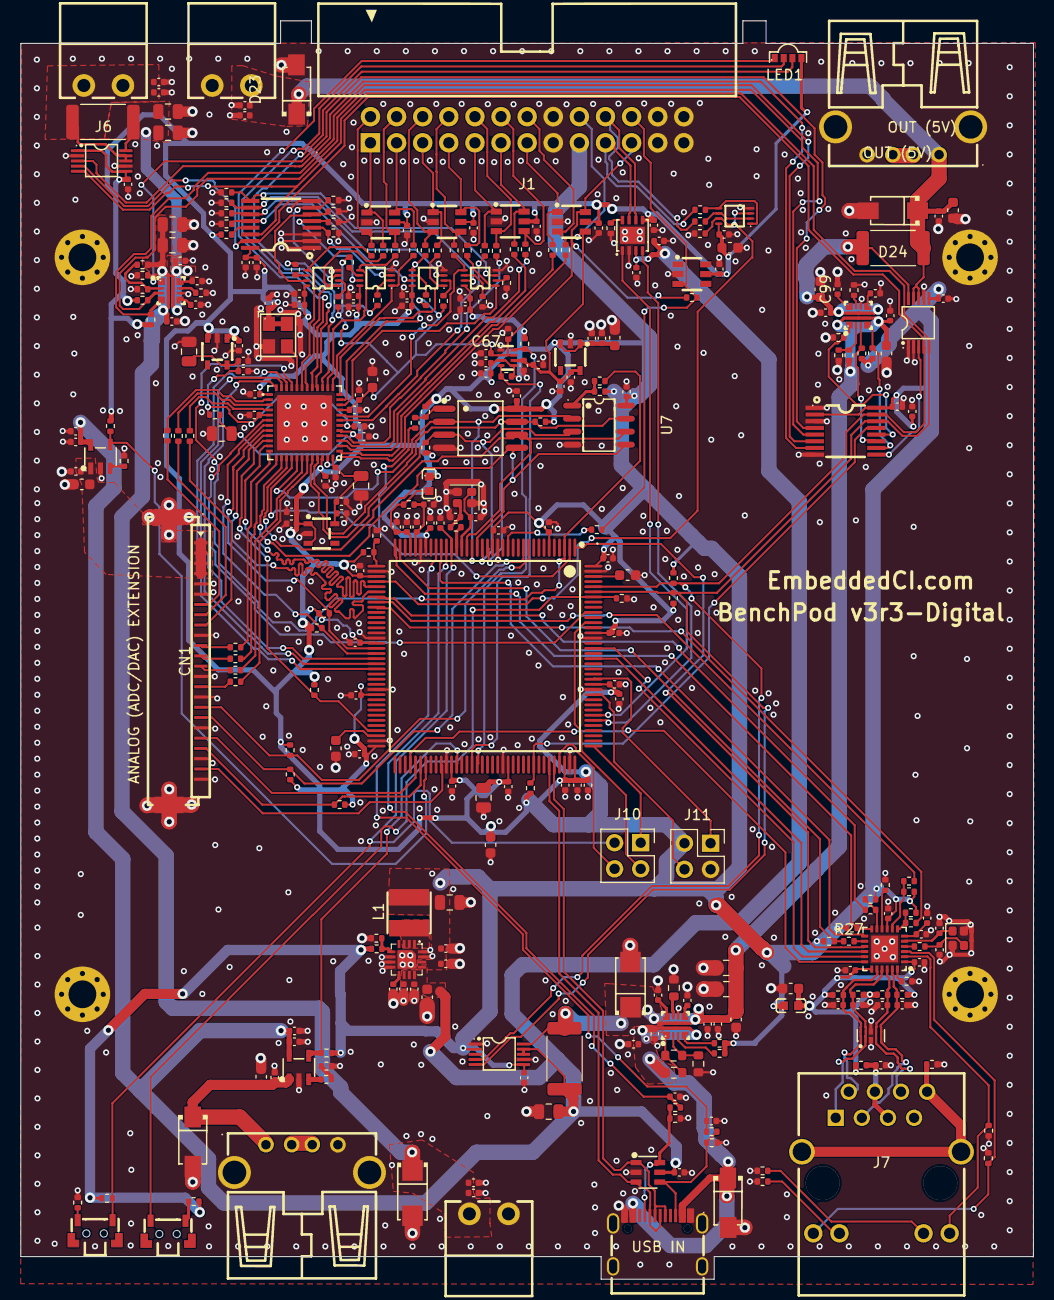
[picture p14: board pcb/benchpod-digital/vbench-pod.kicad_pcb from above]

Board: 4 copper layers, 98.5 x 122.4 mm, 335 parts (0 on the bottom side), 205 nets.
